roboryman/EchoCore/bom/EchoCore.csv

Ref | Qnty | Value | Name | Description | Footprint | Manufacturer | Manufacturer Part Number | JLCPCB Part Number | Comments | DNP
C101, C102, C104, C105, C106, C107, C113, C114, C306, C307, C311, C312, C401 | 13 | 100n | C | Unpolarized capacitor | Capacitor_SMD:C_0402_1005Metric | Samsung Electro-Mechanics | CL05B104KA5NNNC | C1525 | Prefer ceramic X7R
C103, C202, C207, C210 | 4 | 4.7u | C | Unpolarized capacitor | Capacitor_SMD:C_0603_1608Metric | Samsung Electro-Mechanics | CL10B475KQ8NQNC | C19666 | Prefer ceramic X7R
C108, C301, C302 | 3 | 10n | C | Unpolarized capacitor | Capacitor_SMD:C_0402_1005Metric | Murata Electronics | GRM1555C1E103GE01D | - | Ceramic C0G only
C109, C110, C203, C204, C206, C305, C308 | 7 | 1u | C | Unpolarized capacitor | Capacitor_SMD:C_0603_1608Metric | Samsung Electro-Mechanics | CL10B105KP8NNNC | C15849 | Prefer ceramic X7R
C111, C112 | 2 | 10p | C | Unpolarized capacitor | Capacitor_SMD:C_0805_2012Metric | Samsung Electro-Mechanics | CL21C100CBANNNC | - | Ceramic C0G or X7R
C201, C205 | 2 | 2.2u | C | Unpolarized capacitor | Capacitor_SMD:C_0603_1608Metric | Samsung Electro-Mechanics | CL10B225KP8NNNC | C23630 | Prefer ceramic X7R
C208 | 1 | 22u | C | Unpolarized capacitor | Capacitor_SMD:C_0805_2012Metric | Samsung Electro-Mechanics | CL21A226KQCLRNC | C45783 | Prefer ceramic X7R
C209 | 1 | DNP | C | Unpolarized capacitor | Capacitor_SMD:C_0805_2012Metric | - | - | - | DNP | DNP
C303, C304, C309 | 3 | 150p | C | Unpolarized capacitor | Capacitor_SMD:C_0805_2012Metric | YAGEO | CC0805FRNPO9BN151 | - | Ceramic C0G only
C310 | 1 | 220n | C | Unpolarized capacitor | Capacitor_SMD:C_0603_1608Metric | Murata Electronics | GRM188R71E224JA88J | - | Prefer ceramic X7R
D101 | 1 | EAST1616RGBB2 | LED_RGBA | RGB LED, red/green/blue/anode | _Galahad_Labs_Footprints:EAST1616RGBB2_RGBA | Everlight Electronics Co Ltd | EAST1616RGBB2 | - | RGB LED
D201 | 1 | 5988170107F (Green) | LED | Light emitting diode | _Galahad_Labs_Footprints:DIALIGHT_598-81xx | Dialight | 5988170107F | - | Power LED
FL401 | 1 | ACM-21-900M-T | Filter_EMI_CommonMode_12x43 | EMI 2-inductor common mode filter | _Galahad_Labs_Footprints:ABRACON_ACM-21-900M-T | Abracon LLC | ACM-21-900M-T | - | Buck inductor
J401 | 1 | FTSH-105-01-L-DV-K | Conn_02x05_Odd_Even | Generic connector, double row, 02x05, odd/even pin numbering scheme (row 1 odd numbers, row 2 even numbers), script generated (kicad-library-utils/schlib/autogen/connector/) | _Galahad_Labs_Footprints:SAMTEC_FTSH-105-01-L-DV-K | Samtec Inc. | FTSH-105-01-L-DV-K | - | SWD connector
J402 | 1 | USB4105-GF-A | USB_C_Receptacle_USB2.0 | USB 2.0-only Type-C Receptacle connector | Connector_USB:USB_C_Receptacle_GCT_USB4105-xx-A_16P_TopMnt_Horizontal | GCT | USB4105-GF-A | - | USB 2.0 connector (type c)
J403 | 1 | JST-PH_01x04 | Conn_01x04 | Generic connector, single row, 01x04, script generated (kicad-library-utils/schlib/autogen/connector/) | Connector_JST:JST_PH_S4B-PH-K_1x04_P2.00mm_Horizontal | JST Sales America Inc. | S4B-PH-K-S | - | Analog connector
L101, L201 | 2 | 10n | L | Inductor | Inductor_SMD:L_0402_1005Metric | Murata Electronics | LQG15WZ10NH02D | - | DCR > 0.15
L202 | 1 | 68u | L | Inductor | _Galahad_Labs_Footprints:TDK_VLS3015CX-H | TDK Corporation | VLS3015CX-680M-H | - | -
R101, R104, R107, R108 | 4 | 10k | R | Resistor | Resistor_SMD:R_0603_1608Metric | Vishay Dale | CRCW060310K0FKEAHP | C25804 | >1/4 W, low tolerance
R102, R103, R105, R106, R206 | 5 | 100 | R | Resistor | Resistor_SMD:R_0402_1005Metric | Vishay Dale | CRCW0402100RFKEDHP | C25076 | >1/4 W, low tolerance
R201 | 1 | 10 | R | Resistor | Resistor_SMD:R_0805_2012Metric | Rohm Semiconductor | ESR10EZPJ100 | C17415 | >2/5 W, low tolerance
R202 | 1 | 82k | R | Resistor | Resistor_SMD:R_0603_1608Metric | TE Connectivity Passive Product | CRGP0603F82K | C23254 | >1/4 W, low tolerance
R203 | 1 | 47k | R | Resistor | Resistor_SMD:R_0805_2012Metric | Vishay Dale | CRCW080547K0FKEAHP | C17713 | >1/4 W, low tolerance
R204 | 1 | 300k | R | Resistor | Resistor_SMD:R_0805_2012Metric | Vishay Dale | RCS0805300KFKEA | C17616 | >1/4 W, low tolerance
R205 | 1 | 510k | R | Resistor | Resistor_SMD:R_0805_2012Metric | Panasonic Electronic Components | ERJ-PB6B5103V | C17733 | >1/4 W, low tolerance
R207 | 1 | 180k | R | Resistor | Resistor_SMD:R_0805_2012Metric | Panasonic Electronic Components | ERJ-UP6F1803V | C17501 | >1/4 W, low tolerance
R209 | 1 | 22k | R | Resistor | Resistor_SMD:R_0603_1608Metric | Panasonic Electronic Components | ERJ-PA3F2202V | C31850 | >1/4 W, low tolerance
R210 | 1 | 18k | R | Resistor | Resistor_SMD:R_0603_1608Metric | Panasonic Electronic Components | ERJ-PA3F1802V | C25810 | >1/4 W, low tolerance
R301, R302, R303, R304, R306, R308 | 6 | 1k | R | Resistor | Resistor_SMD:R_0603_1608Metric | Susumu | RG1608P-102-B-T5 | C21190 | Very low tolerance
R305, R307, R310 | 3 | 100M | R | Resistor | Resistor_SMD:R_0805_2012Metric | YAGEO | RC0805JR-13100ML | - | -
R311 | 1 | 0R | R | Resistor | Resistor_SMD:R_0402_1005Metric | Bourns Inc. | CR0402-J/-000GLF | C17168 | -
R401, R402, R403 | 3 | 49R9 | R | Resistor | Resistor_SMD:R_0402_1005Metric | YAGEO | RC0402FR-0749R9L | C25120 | Low tolerance
R404, R405 | 2 | 5k1 | R | Resistor | Resistor_SMD:R_0603_1608Metric | YAGEO | RC0603FR-135K1L | C23186 | Low tolerance
SW102 | 1 | PTS645SM43SMTR92 LFS | SW_Push | Push button switch, generic, two pins | Button_Switch_SMD:SW_SPST_PTS645 | C&K | PTS645SM43SMTR92LFS | - | Temporary switch
U101 | 1 | BMI323 | BMI323 | Small, versatile 6DoF sensor module, LGA-14 | Package_LGA:Bosch_LGA-14_3x2.5mm_P0.5mm | Bosch Sensortec | BMI323 | - | IMU
U102 | 1 | STM32F070CBTx | STM32F070CBTx | STMicroelectronics Arm Cortex-M0 MCU, 128KB flash, 16KB RAM, 48 MHz, 2.4-3.6V, 37 GPIO, LQFP48 | Package_QFP:LQFP-48_7x7mm_P0.5mm | STMicroelectronics | STM32F070CBT6 | - | MCU
U201 | 1 | LM27762 | LM27762 | Low-noise inverting charge pump with both positive and negative LDO's, with 2.7V-5.5V input to +1.5 to +5V and -1.5 to -5V Output Voltage, WSON-12 | Package_SON:WSON-12-1EP_3x2mm_P0.5mm_EP1x2.65 | Texas Instruments | LM27762DSSR | - | Analog supply LDO
U202 | 1 | TLV62568DBVR | TLV62568DBV | High Efficiency Synchronous Buck Converter, Adjustable Output 0.6V-5.5V, 1A, SOT-23-5 | Package_TO_SOT_SMD:SOT-23-5 | Texas Instruments | TLV62568DBVR | - | Digital supply buck
U301 | 1 | OPA4376 | OPA4376 | Quad Low-Noise, Low Quiescent Current, Precision Operational Amplifier e-trim Series, SC-70-5 | Package_SO:TSSOP-14_4.4x5mm_P0.65mm | Texas Instruments | OPA4376AIPW | - | Analog buffer
U302 | 1 | ADS131M02 | ADS131M02 | 24-bit ΔΣ ADC, 2 Channels, SPI compatible, PGA 1 to 128, TSSOP-20 | Package_SO:TSSOP-20_4.4x6.5mm_P0.65mm | Texas Instruments | ADS131M02IPWT | - | ADC
U401, U403 | 2 | TPD4E1B06 | TPD4E1B06 | 4-Channel Ultra Low Leakage ESD Protection Device | Package_TO_SOT_SMD:SOT-363_SC-70-6 | Texas Instruments | TPD4E1B06DCKR | - | ESD
U402 | 1 | USBLC6-2SC6 | USBLC6-2SC6 | Very low capacitance ESD protection diode, 2 data-line, SOT-23-6 | Package_TO_SOT_SMD:SOT-23-6 | STMicroelectronics | USBLC6-2SC6 | - | USB CMC
Y101 | 1 | ECS-160-10-36-CKM | Crystal_GND24 | Four pin crystal, GND on pins 2 and 4 | _Galahad_Labs_Footprints:Crystal_SMD_ECS_ECX-2236-4Pin_2.5x2.0mm | ECS Inc. | ECS-160-10-36-CKM-TR3 | - | 16 MHz Crystal
