roboryman/EchoCore/pinout.csv

Position | Name | Type | Signal | Label
1 | VDD | Power
2 | PC13 | I/O
3 | PC14-OSC32_IN | I/O
4 | PC15-OSC32_OUT | I/O
5 | PF0-OSC_IN | I/O | RCC_OSC_IN
6 | PF1-OSC_OUT | I/O | RCC_OSC_OUT
7 | NRST | Reset
8 | VSSA | Power
9 | VDDA | Power
10 | PA0 | I/O
11 | PA1 | I/O
12 | PA2 | I/O
13 | PA3 | I/O
14 | PA4 | I/O | SPI1_NSS
15 | PA5 | I/O | SPI1_SCK
16 | PA6 | I/O | SPI1_MISO
17 | PA7 | I/O | SPI1_MOSI
18 | PB0 | I/O
19 | PB1 | Input | GPIO_Input | ADC_INT
20 | PB2 | I/O
21 | PB10 | I/O
22 | PB11 | I/O
23 | VSS | Power
24 | VDD | Power
25 | PB12 | Input | GPIO_Input | IMU_INT1
26 | PB13 | I/O | SPI2_SCK
27 | PB14 | I/O | SPI2_MISO
28 | PB15 | I/O | SPI2_MOSI
29 | PA8 | I/O | RCC_MCO
30 | PA9 | Input | GPIO_Input | IMU_INT2
31 | PA10 | I/O
32 | PA11 | I/O | USB_DM
33 | PA12 | I/O | USB_DP
34 | PA13 | I/O | SYS_SWDIO
35 | VSS | Power
36 | VDD | Power
37 | PA14 | I/O | SYS_SWCLK
38 | PA15 | I/O
39 | PB3 | I/O
40 | PB4 | I/O | TIM3_CH1
41 | PB5 | I/O | TIM3_CH2
42 | PB6 | I/O
43 | PB7 | I/O
44 | BOOT0 | Boot
45 | PB8 | I/O | TIM16_CH1
46 | PB9 | I/O | SPI2_NSS
47 | VSS | Power
48 | VDD | Power
