roboryman/EchoCore/EchoCore.kicad_pcb

## KiCad design EchoCore.kicad_pcb (2026-11-10)

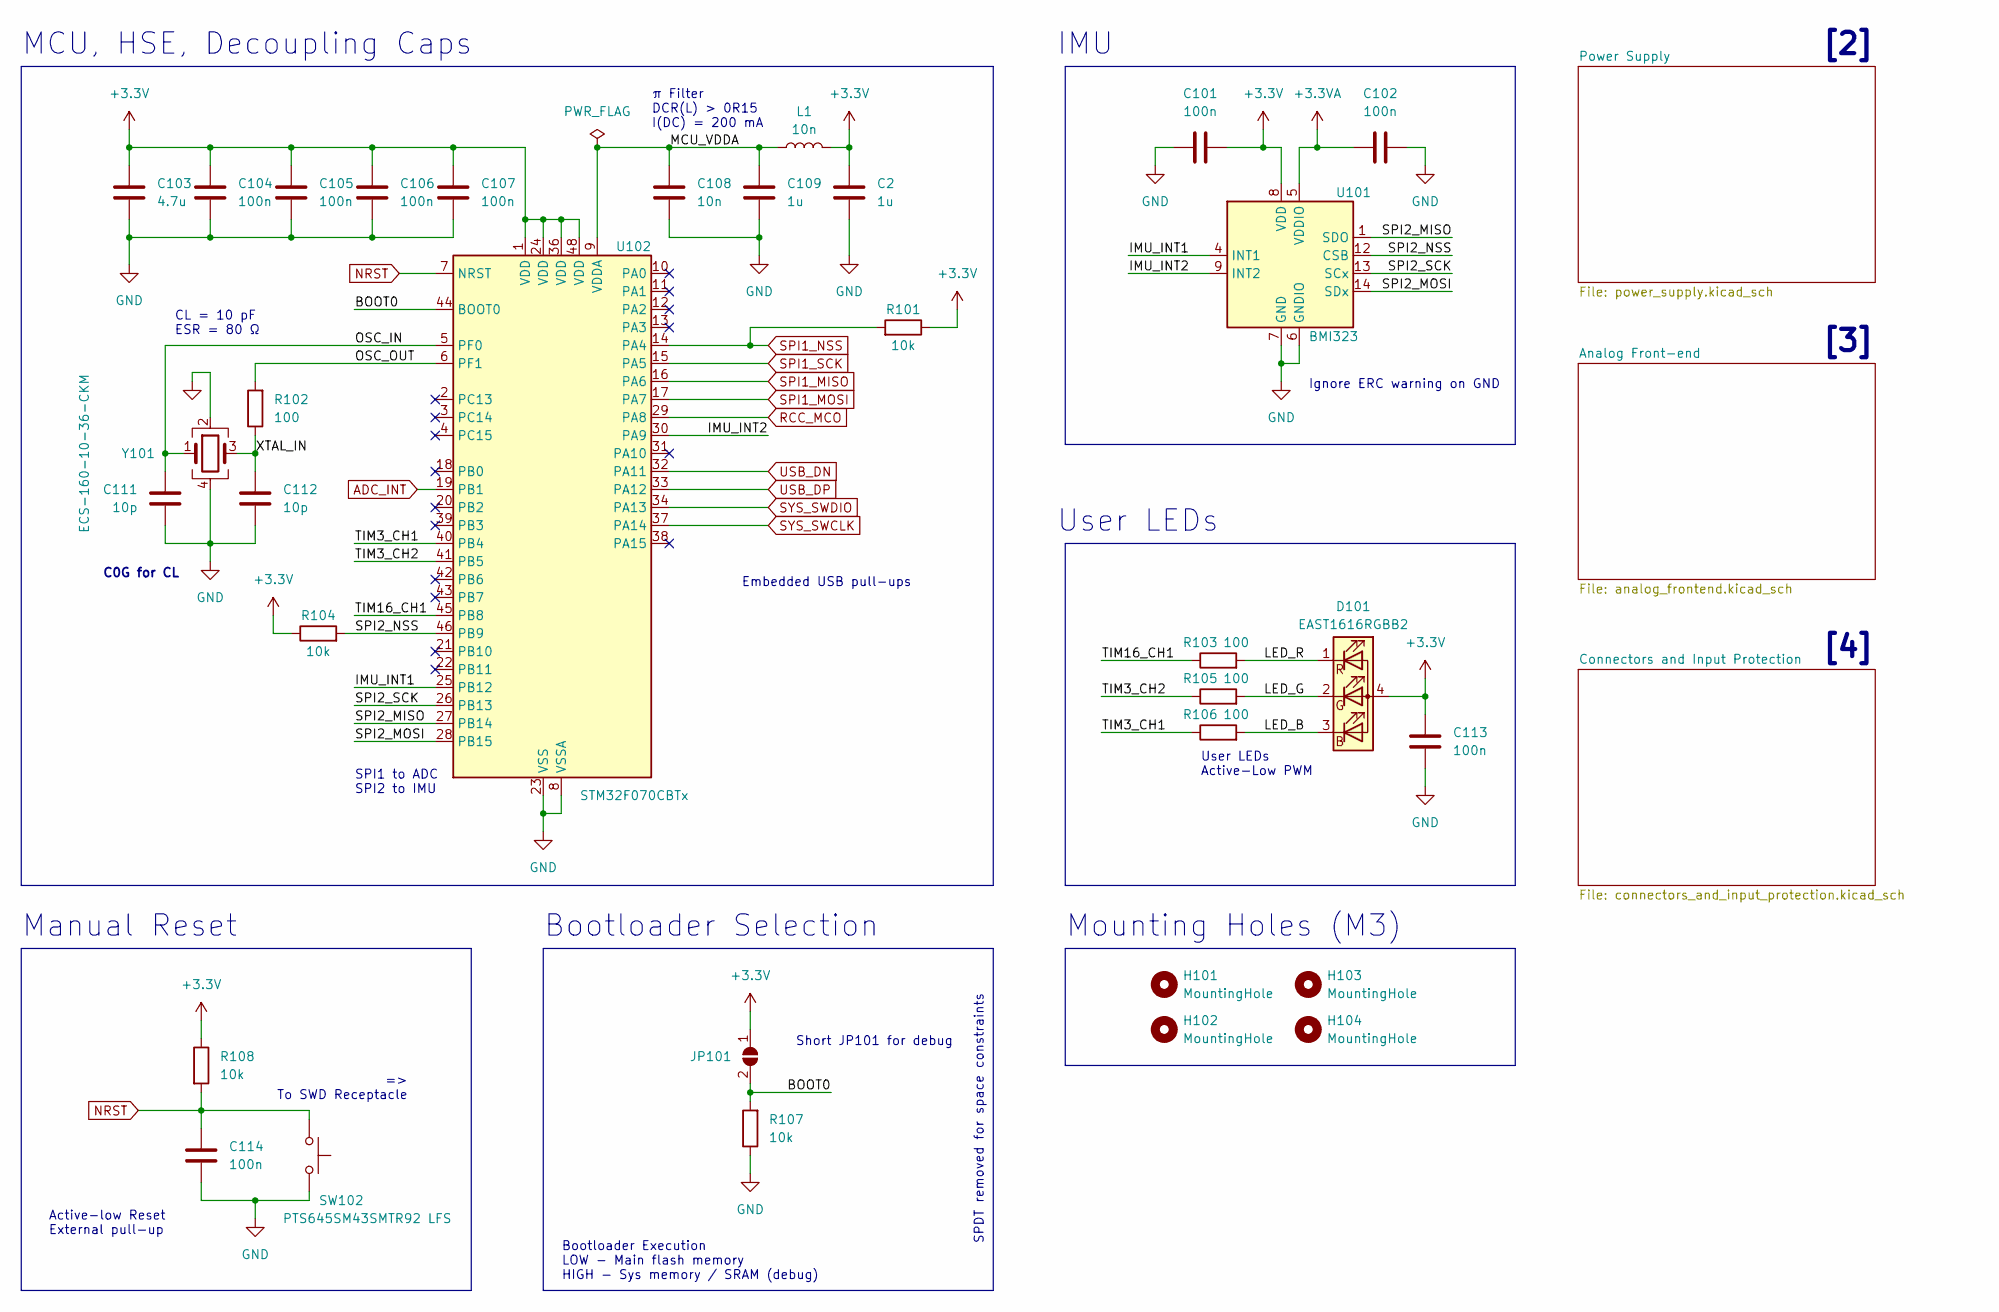
[picture p1: schematic EchoCore.kicad_sch]

Parts:
C2, C109: 1u; C_0603_1608Metric; Manufacturer Part Number CL10B105KP8NNNC; JLCPCB Part Number C15849
C101, C102, C104, C105, C106, C107, C113, C114: 100n; C_0402_1005Metric; Manufacturer Part Number CL05B104KA5NNNC; JLCPCB Part Number C1525
C103: 4.7u; C_0603_1608Metric; Manufacturer Part Number CL10B475KQ8NQNC; JLCPCB Part Number C19666
C108: 10n; C_0402_1005Metric; Manufacturer Part Number GRM1555C1E103GE01D
C111, C112: 10p; C_0805_2012Metric; Manufacturer Part Number CL21C100CBANNNC
D101: EAST1616RGBB2; EAST1616RGBB2_RGBA; Manufacturer Part Number EAST1616RGBB2
H101, H102, H103, H104: MountingHole; MountingHole_3.2mm_M3
JP101: SolderJumper_2_Open; SolderJumper-2_P1.3mm_Open_RoundedPad1.0x1.5mm
L1: 10n; L_0402_1005Metric; Manufacturer Part Number LQG15WZ10NH02D
R101, R104, R107, R108: 10k; R_0603_1608Metric; Manufacturer Part Number CRCW060310K0FKEAHP; JLCPCB Part Number C25804
R102, R103, R105, R106: 100; R_0402_1005Metric; Manufacturer Part Number CRCW0402100RFKEDHP; JLCPCB Part Number C25076
SW102: PTS645SM43SMTR92 LFS; SW_SPST_PTS645; Manufacturer Part Number PTS645SM43SMTR92LFS
U101: BMI323; Bosch_LGA-14_3x2.5mm_P0.5mm; Manufacturer Part Number BMI323
U102: STM32F070CBTx; LQFP-48_7x7mm_P0.5mm; Manufacturer Part Number STM32F070CBT6
Y101: ECS-160-10-36-CKM; Crystal_SMD_ECS_ECX-2236-4Pin_2.5x2.0mm; Manufacturer Part Number ECS-160-10-36-CKM-TR3

Connections:
+3.3V: C101.2, C103.1, C104.1, C105.1, C106.1, C107.1, C113.1, D101.4 (A), JP101.1 (A), R101.1, R104.1, R108.1, U101.8 (VDD), U102.1 (VDD), U102.24 (VDD), U102.36 (VDD), U102.48 (VDD); also elsewhere on the board
+3.3VA: C102.1, U101.5 (VDDIO); also elsewhere on the board
/BOOT0: JP101.2 (B), R107.2, U102.44 (BOOT0)
/IMU_INT1: U101.4 (INT1), U102.25 (PB12)
/IMU_INT2: U101.9 (INT2), U102.30 (PA9)
/LED_B: D101.3 (BK), R106.2
/LED_G: D101.2 (GK), R105.2
/LED_R: D101.1 (RK), R103.2
/MCU_VDDA: C108.1, C109.1, U102.9 (VDDA); also elsewhere on the board
/OSC_IN: C111.1, U102.5 (PF0), Y101.1
/OSC_OUT: R102.2, U102.6 (PF1)
/SPI2_MISO: U101.1 (SDO), U102.27 (PB14)
/SPI2_MOSI: U101.14 (SDx), U102.28 (PB15)
/SPI2_NSS: R104.2, U101.12 (CSB), U102.46 (PB9)
/SPI2_SCK: U101.13 (SCx), U102.26 (PB13)
/TIM3_CH1: R106.1, U102.40 (PB4)
/TIM3_CH2: R105.1, U102.41 (PB5)
/TIM16_CH1: R103.1, U102.45 (PB8)
/XTAL_IN: C112.1, R102.1, Y101.3
ADC_INT: U102.19 (PB1); also elsewhere on the board
GND: C101.1, C102.2, C103.2, C104.2, C105.2, C106.2, C107.2, C108.2, C109.2, C111.2, C112.2, C113.2, C114.2, R107.1, SW102.2, U101.6 (GNDIO), U101.7 (GND), U102.8 (VSSA), U102.23 (VSS), U102.35 (VSS), U102.47 (VSS), Y101.2, Y101.4; also elsewhere on the board
NRST: C114.1, R108.2, SW102.1, U102.7 (NRST); also elsewhere on the board
RCC_MCO: U102.29 (PA8); also elsewhere on the board
SPI1_MISO: U102.16 (PA6); also elsewhere on the board
SPI1_MOSI: U102.17 (PA7); also elsewhere on the board
SPI1_NSS: R101.2, U102.14 (PA4); also elsewhere on the board
SPI1_SCK: U102.15 (PA5); also elsewhere on the board
SYS_SWCLK: U102.37 (PA14); also elsewhere on the board
SYS_SWDIO: U102.34 (PA13); also elsewhere on the board
USB_DN: U102.32 (PA11); also elsewhere on the board
USB_DP: U102.33 (PA12); also elsewhere on the board

Notes on the sheet:
Bootloader Selection
CL = 10 pF ESR = 80 Ω
IMU
Bootloader Execution LOW - Main flash memory HIGH - Sys memory / SRAM (debug)
SPDT removed for space constraints
Manual Reset
π Filter DCR(L) > 0R15 I(DC) = 200 mA
User LEDs Active-Low PWM
Ignore ERC warning on GND
[4]
SPI1 to ADC SPI2 to IMU
[3]
[2]
Mounting Holes (M3)
User LEDs
Embedded USB pull-ups
Short JP101 for debug
C0G for CL
Active-low Reset External pull-up
MCU, HSE, Decoupling Caps
=> To SWD Receptacle

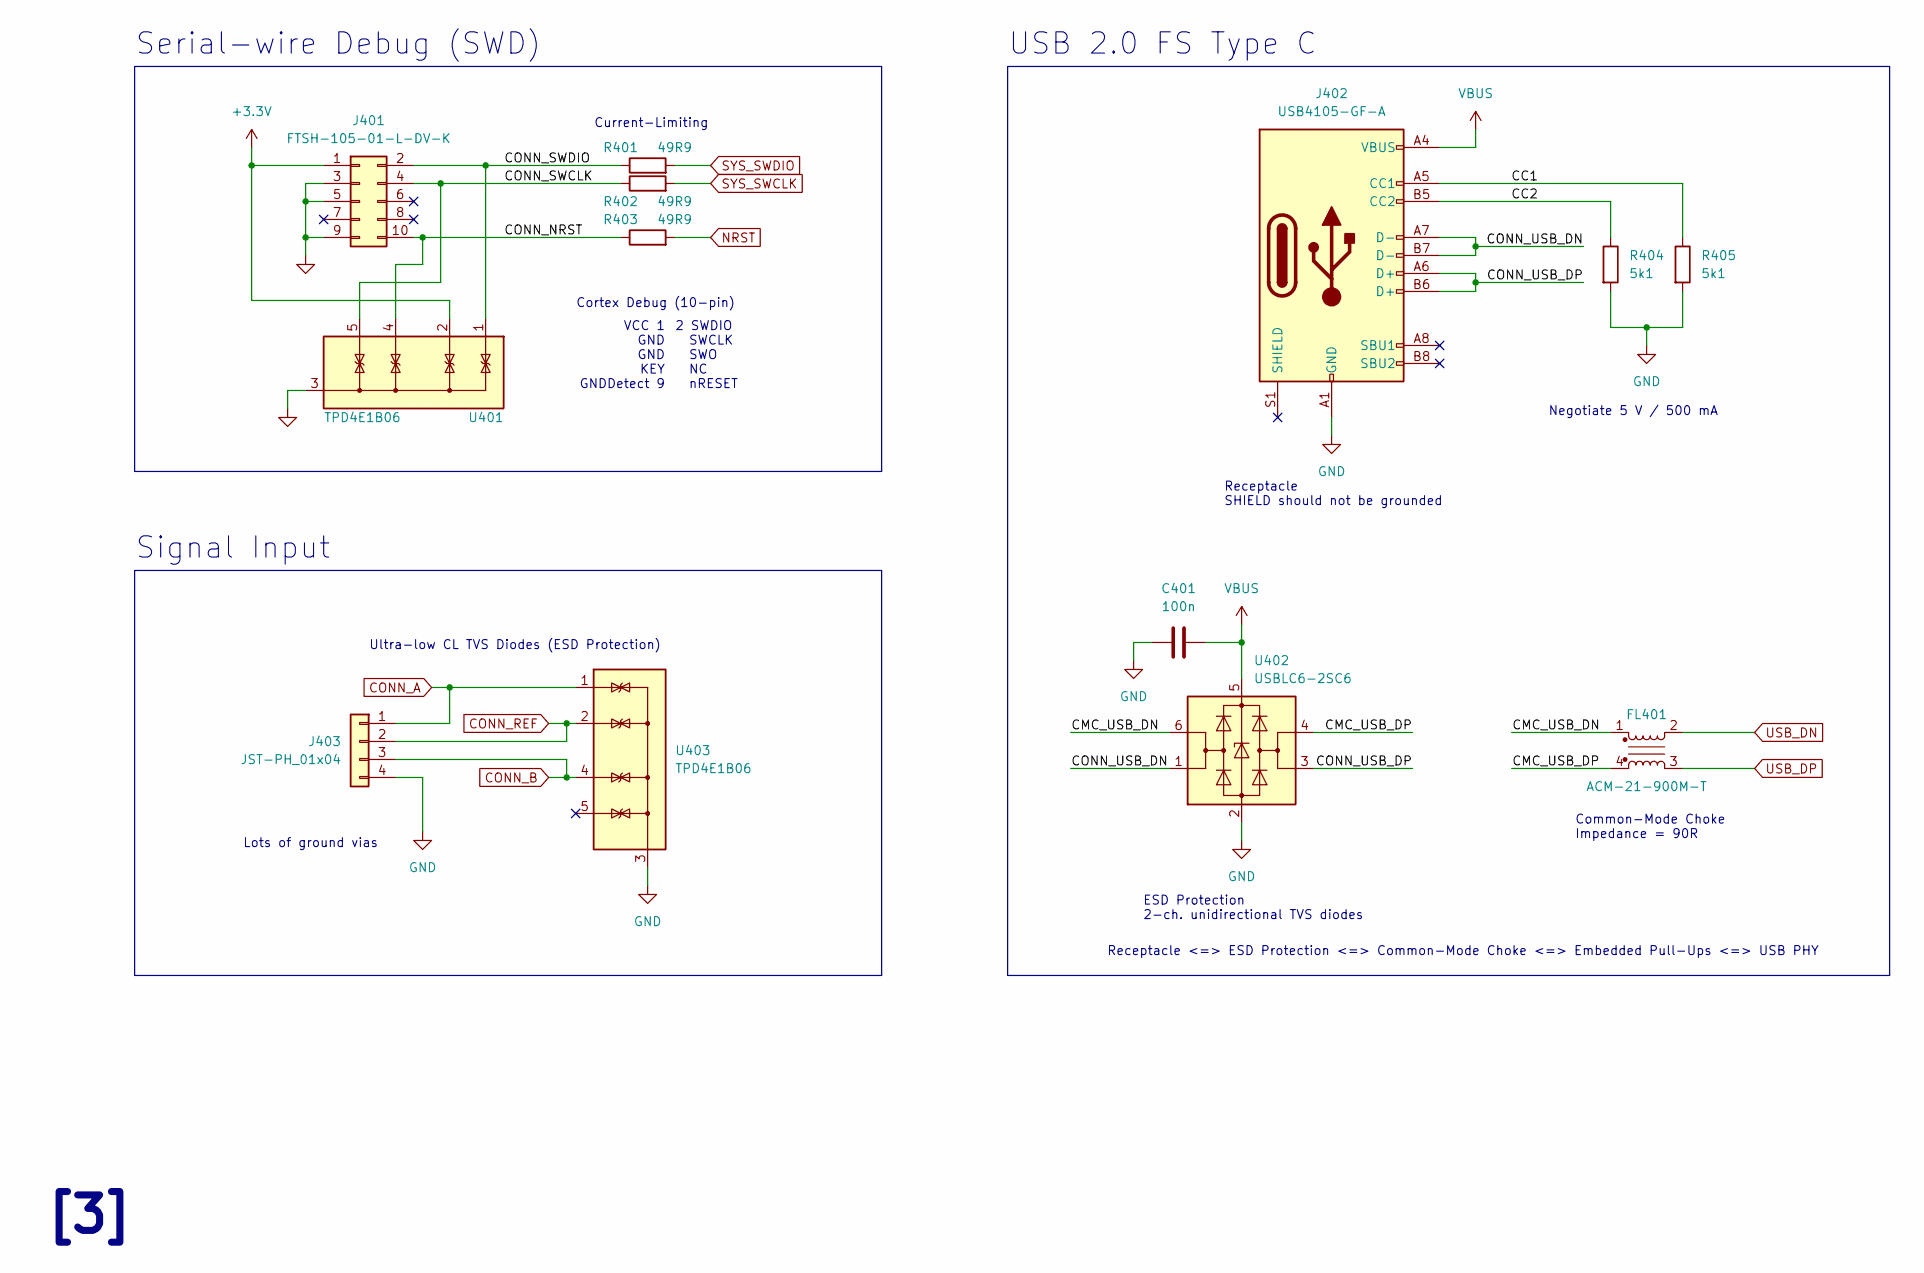
[picture p2: schematic connectors_and_input_protection.kicad_sch, EchoCore Connectors and Input Protection]

Parts:
C401: 100n; C_0402_1005Metric; Manufacturer Part Number CL05B104KA5NNNC; JLCPCB Part Number C1525
FL401: ACM-21-900M-T; ABRACON_ACM-21-900M-T; Manufacturer Part Number ACM-21-900M-T
J401: FTSH-105-01-L-DV-K; SAMTEC_FTSH-105-01-L-DV-K; Manufacturer Part Number FTSH-105-01-L-DV-K
J402: USB4105-GF-A; USB_C_Receptacle_GCT_USB4105-xx-A_16P_TopMnt_Horizontal; Manufacturer Part Number USB4105-GF-A
J403: JST-PH_01x04; JST_PH_S4B-PH-K_1x04_P2.00mm_Horizontal; Manufacturer Part Number S4B-PH-K-S
R401, R402, R403: 49R9; R_0402_1005Metric; Manufacturer Part Number RC0402FR-0749R9L; JLCPCB Part Number C25120
R404, R405: 5k1; R_0603_1608Metric; Manufacturer Part Number RC0603FR-135K1L; JLCPCB Part Number C23186
U401, U403: TPD4E1B06; SOT-363_SC-70-6; Manufacturer Part Number TPD4E1B06DCKR
U402: USBLC6-2SC6; SOT-23-6; Manufacturer Part Number USBLC6-2SC6

Connections:
+3.3V: J401.1, U401.2 (IO2); also elsewhere on the board
/Connectors and Input Protection/CC1: J402.A5 (CC1), R405.1
/Connectors and Input Protection/CC2: J402.B5 (CC2), R404.1
/Connectors and Input Protection/CMC_USB_DN: FL401.1, U402.6 (I/O1)
/Connectors and Input Protection/CMC_USB_DP: FL401.4, U402.4 (I/O2)
/Connectors and Input Protection/CONN_NRST: J401.10, R403.1, U401.4 (IO3)
/Connectors and Input Protection/CONN_SWCLK: J401.4, R402.1, U401.5 (IO4)
/Connectors and Input Protection/CONN_SWDIO: J401.2, R401.1, U401.1 (IO1)
/Connectors and Input Protection/CONN_USB_DN: J402.A7 (D-), J402.B7 (D-), U402.1 (I/O1)
/Connectors and Input Protection/CONN_USB_DP: J402.A6 (D+), J402.B6 (D+), U402.3 (I/O2)
CONN_A: J403.1, U403.1 (IO1); also elsewhere on the board
CONN_B: J403.3, U403.4 (IO3); also elsewhere on the board
CONN_REF: J403.2, U403.2 (IO2); also elsewhere on the board
GND: C401.1, J401.3, J401.5, J401.9, J402.A1 (GND), J402.A12 (GND), J402.B1 (GND), J402.B12 (GND), J403.4, R404.2, R405.2, U401.3 (GND), U402.2 (GND), U403.3 (GND); also elsewhere on the board
NRST: R403.2; also elsewhere on the board
SYS_SWCLK: R402.2; also elsewhere on the board
SYS_SWDIO: R401.2; also elsewhere on the board
USB_DN: FL401.2; also elsewhere on the board
USB_DP: FL401.3; also elsewhere on the board
VBUS: C401.2, J402.A4 (VBUS), J402.A9 (VBUS), J402.B4 (VBUS), J402.B9 (VBUS), U402.5 (VBUS); also elsewhere on the board

Notes on the sheet:
USB 2.0 FS Type C
Receptacle SHIELD should not be grounded
2 SWDIO SWCLK SWO NC nRESET
Signal Input
Ultra-low CL TVS Diodes (ESD Protection)
Serial-wire Debug (SWD)
Common-Mode Choke Impedance = 90R
Negotiate 5 V / 500 mA
Cortex Debug (10-pin)
Lots of ground vias
[3]
Current-Limiting
Receptacle <=> ESD Protection <=> Common-Mode Choke <=> Embedded Pull-Ups <=> USB PHY
ESD Protection 2-ch. unidirectional TVS diodes
VCC 1 GND GND KEY GNDDetect 9

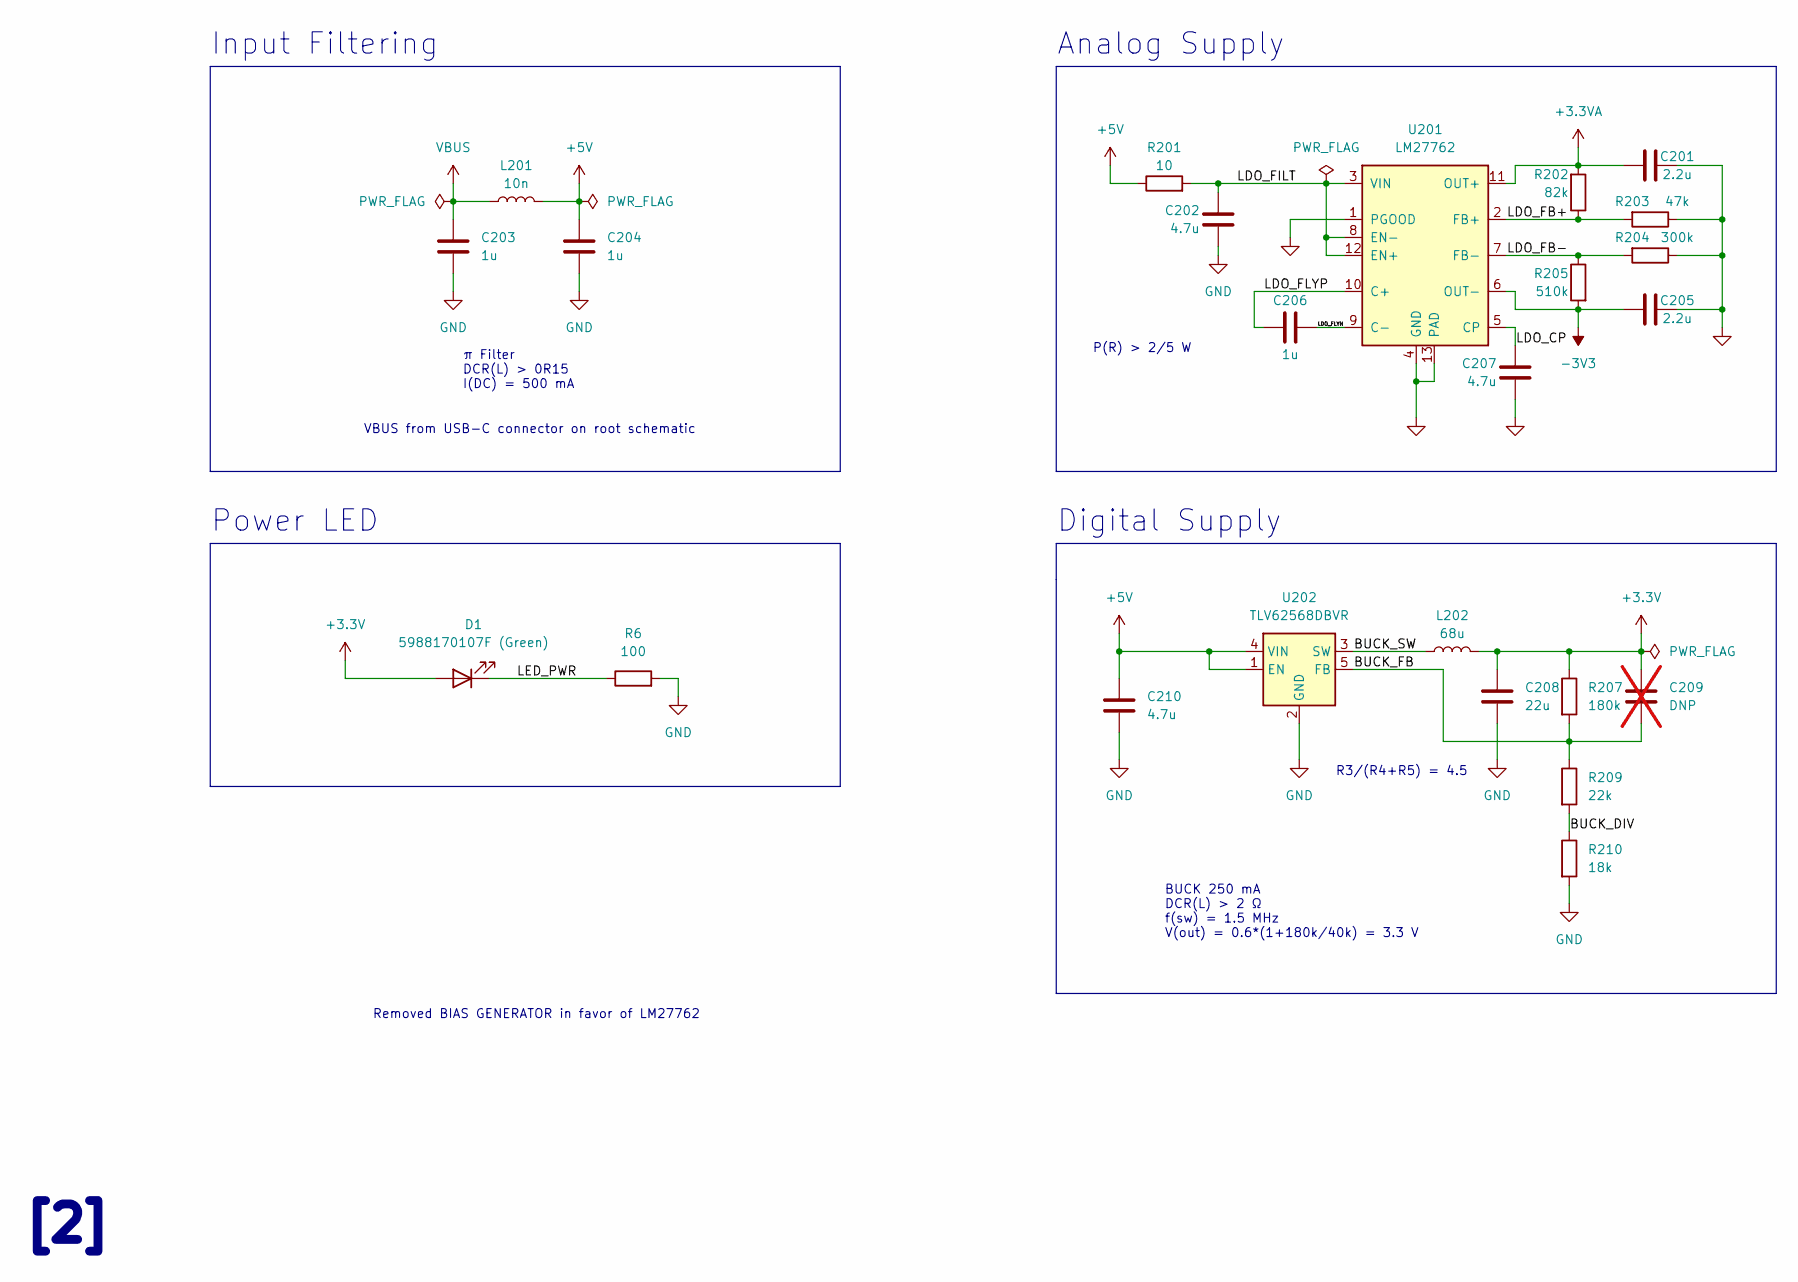
[picture p3: schematic power_supply.kicad_sch, EchoCore Power Supply]

Parts:
C201, C205: 2.2u; C_0603_1608Metric; Manufacturer Part Number CL10B225KP8NNNC; JLCPCB Part Number C23630
C202, C207, C210: 4.7u; C_0603_1608Metric; Manufacturer Part Number CL10B475KQ8NQNC; JLCPCB Part Number C19666
C203, C204, C206: 1u; C_0603_1608Metric; Manufacturer Part Number CL10B105KP8NNNC; JLCPCB Part Number C15849
C208: 22u; C_0805_2012Metric; Manufacturer Part Number CL21A226KQCLRNC; JLCPCB Part Number C45783
C209: DNP; C_0805_2012Metric; not fitted
D1: 5988170107F (Green); DIALIGHT_598-81xx; Manufacturer Part Number 5988170107F
L201: 10n; L_0402_1005Metric; Manufacturer Part Number LQG15WZ10NH02D
L202: 68u; TDK_VLS3015CX-H; Manufacturer Part Number VLS3015CX-680M-H
R6: 100; R_0402_1005Metric; Manufacturer Part Number CRCW0402100RFKEDHP; JLCPCB Part Number C25076
R201: 10; R_0805_2012Metric; Manufacturer Part Number ESR10EZPJ100; JLCPCB Part Number C17415
R202: 82k; R_0603_1608Metric; Manufacturer Part Number CRGP0603F82K; JLCPCB Part Number C23254
R203: 47k; R_0805_2012Metric; Manufacturer Part Number CRCW080547K0FKEAHP; JLCPCB Part Number C17713
R204: 300k; R_0805_2012Metric; Manufacturer Part Number RCS0805300KFKEA; JLCPCB Part Number C17616
R205: 510k; R_0805_2012Metric; Manufacturer Part Number ERJ-PB6B5103V; JLCPCB Part Number C17733
R207: 180k; R_0805_2012Metric; Manufacturer Part Number ERJ-UP6F1803V; JLCPCB Part Number C17501
R209: 22k; R_0603_1608Metric; Manufacturer Part Number ERJ-PA3F2202V; JLCPCB Part Number C31850
R210: 18k; R_0603_1608Metric; Manufacturer Part Number ERJ-PA3F1802V; JLCPCB Part Number C25810
U201: LM27762; WSON-12-1EP_3x2mm_P0.5mm_EP1x2.65; Manufacturer Part Number LM27762DSSR
U202: TLV62568DBVR; SOT-23-5; Manufacturer Part Number TLV62568DBVR

Connections:
+3.3V: C208.2, C209.2, L202.2, R207.1; also elsewhere on the board
+3.3VA: C201.1, R202.2, U201.11 (OUT+); also elsewhere on the board
+5V: C204.1, C210.1, L201.2, R201.1, U202.1 (EN), U202.4 (VIN)
-3V3: C205.1, R205.2, U201.6 (OUT-); also elsewhere on the board
/Power Supply/BUCK_DIV: R209.2, R210.1
/Power Supply/BUCK_FB: C209.1, R207.2, R209.1, U202.5 (FB)
/Power Supply/BUCK_SW: L202.1, U202.3 (SW)
/Power Supply/LDO_CP: C207.1, U201.5 (CP)
/Power Supply/LDO_FB+: R202.1, R203.2, U201.2 (FB+)
/Power Supply/LDO_FB-: R204.2, R205.1, U201.7 (FB-)
/Power Supply/LDO_FILT: C202.1, R201.2, U201.3 (VIN), U201.8 (EN-), U201.12 (EN+)
/Power Supply/LDO_FLYN: C206.2, U201.9 (C-)
/Power Supply/LDO_FLYP: C206.1, U201.10 (C+)
GND: C201.2, C202.2, C203.2, C204.2, C205.2, C207.2, C208.1, C210.2, R203.1, R204.1, R210.2, U201.1 (PGOOD), U201.4 (GND), U201.13 (PAD), U202.2 (GND); also elsewhere on the board
VBUS: C203.1, L201.1; also elsewhere on the board

Notes on the sheet:
π Filter DCR(L) > 0R15 I(DC) = 500 mA
Digital Supply
P(R) > 2/5 W
VBUS from USB-C connector on root schematic
Analog Supply
Input Filtering
R3/(R4+R5) = 4.5
Power LED
Removed BIAS GENERATOR in favor of LM27762
BUCK 250 mA DCR(L) > 2 Ω f(sw) = 1.5 MHz V(out) = 0.6*(1+180k/40k) = 3.3 V
[2]

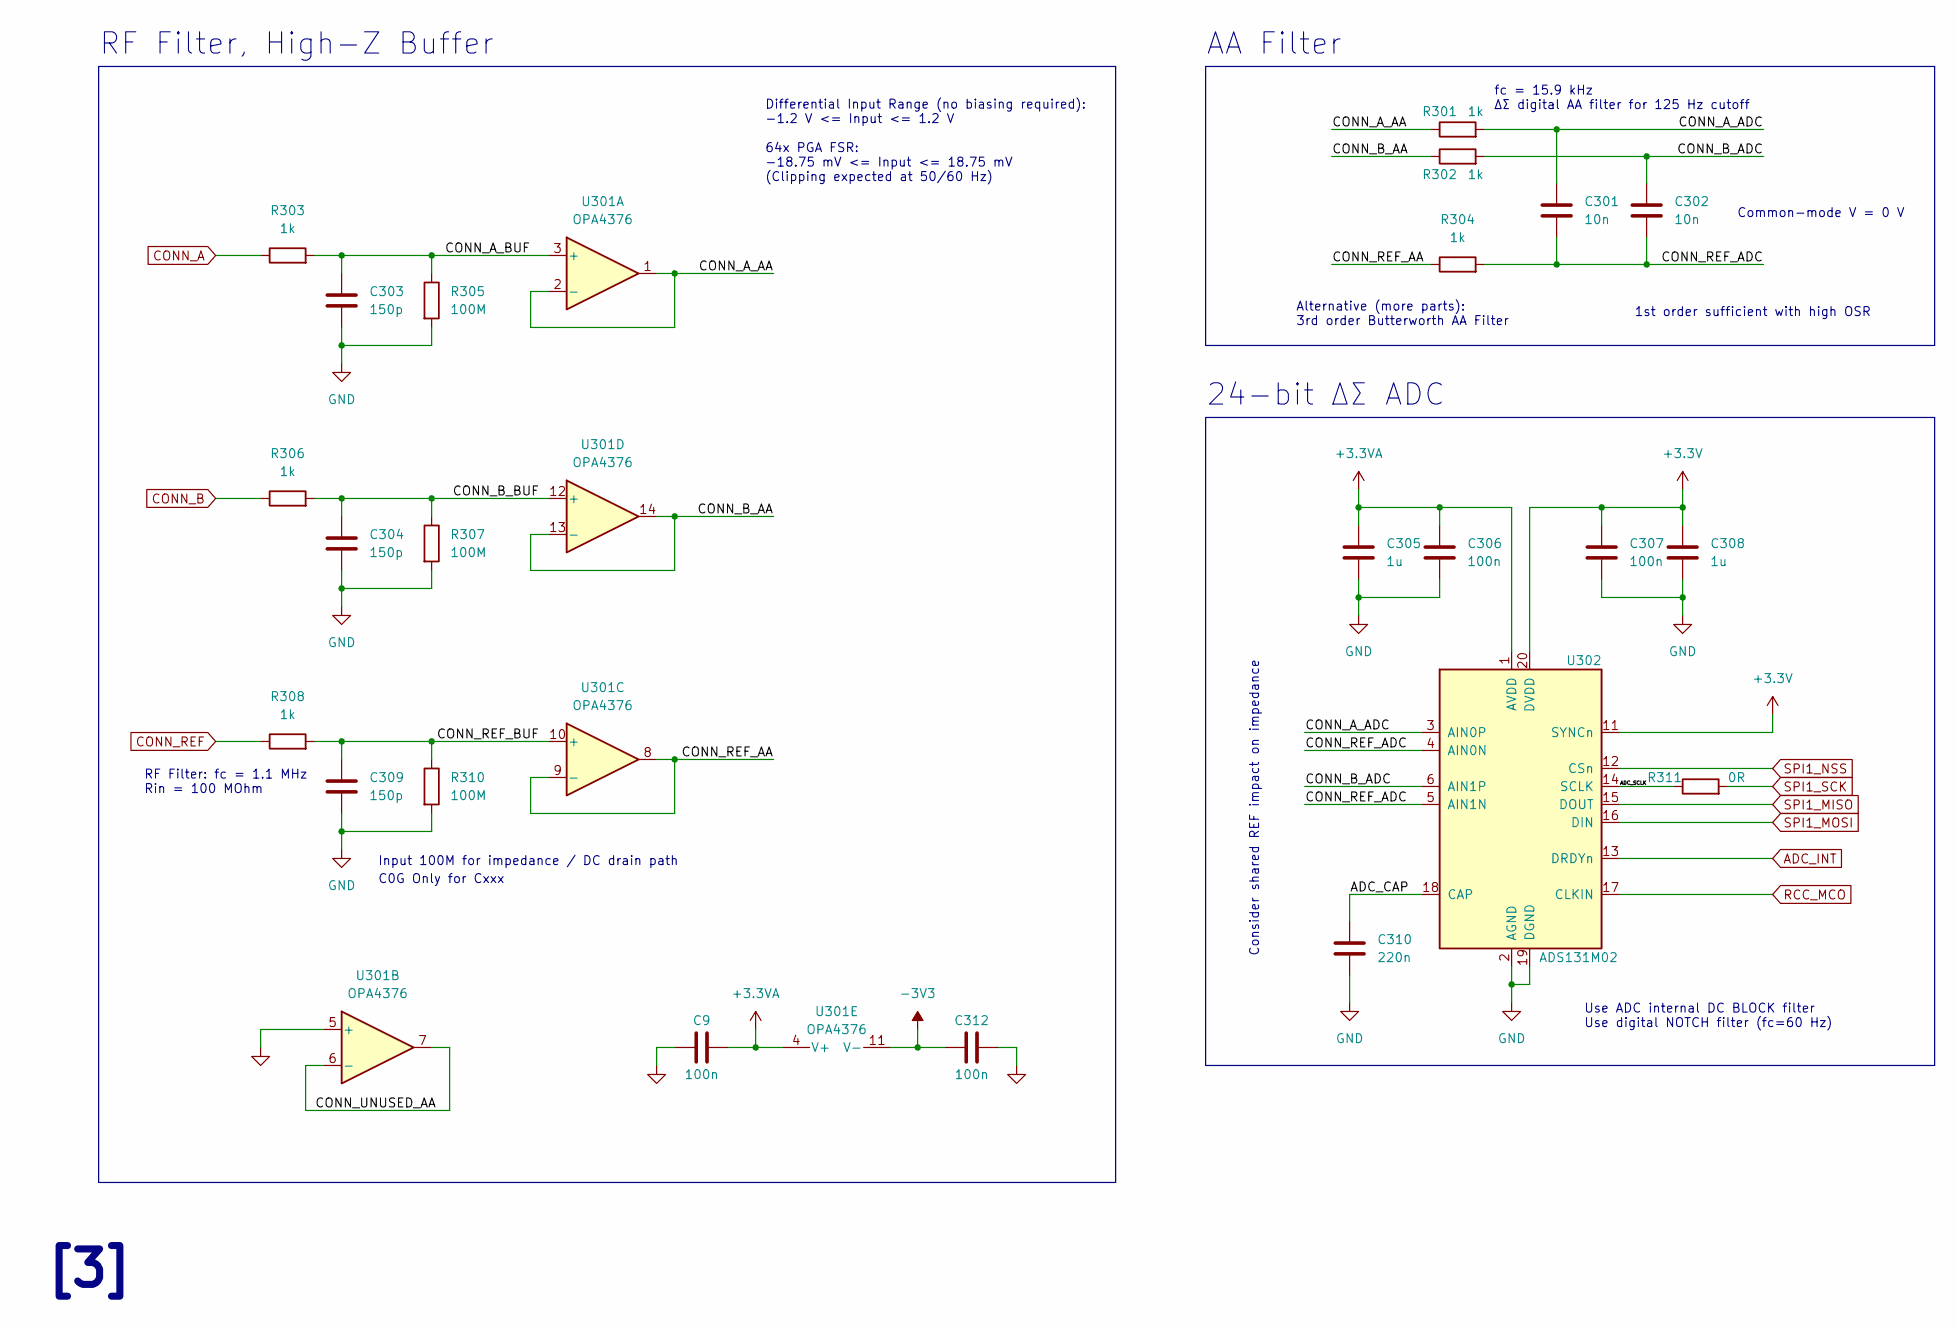
[picture p4: schematic analog_frontend.kicad_sch, EchoCore Analog Front-End]

Parts:
C9, C306, C307, C312: 100n; C_0402_1005Metric; Manufacturer Part Number CL05B104KA5NNNC; JLCPCB Part Number C1525
C301, C302: 10n; C_0402_1005Metric; Manufacturer Part Number GRM1555C1E103GE01D
C303, C304, C309: 150p; C_0805_2012Metric; Manufacturer Part Number CC0805FRNPO9BN151
C305, C308: 1u; C_0603_1608Metric; Manufacturer Part Number CL10B105KP8NNNC; JLCPCB Part Number C15849
C310: 220n; C_0603_1608Metric; Manufacturer Part Number GRM188R71E224JA88J
R301, R302, R303, R304, R306, R308: 1k; R_0603_1608Metric; Manufacturer Part Number RG1608P-102-B-T5; JLCPCB Part Number C21190
R305, R307, R310: 100M; R_0805_2012Metric; Manufacturer Part Number RC0805JR-13100ML
R311: 0R; R_0402_1005Metric; Manufacturer Part Number CR0402-J/-000GLF; JLCPCB Part Number C17168
U301: OPA4376; TSSOP-14_4.4x5mm_P0.65mm; Manufacturer Part Number OPA4376AIPW
U302: ADS131M02; TSSOP-20_4.4x6.5mm_P0.65mm; Manufacturer Part Number ADS131M02IPWT

Connections:
+3.3V: C307.2, C308.1, U302.11 (SYNCn), U302.20 (DVDD); also elsewhere on the board
+3.3VA: C305.1, C306.2, U301.4 (V+), U302.1 (AVDD); also elsewhere on the board
-3V3: C312.1, U301.11 (V-); also elsewhere on the board
/Analog Front-end/ADC_CAP: C310.1, U302.18 (CAP)
/Analog Front-end/ADC_SCLK: R311.1, U302.14 (SCLK)
/Analog Front-end/CONN_A_AA: R301.1, U301.1, U301.2 (-)
/Analog Front-end/CONN_A_ADC: C301.1, R301.2, U302.3 (AIN0P)
/Analog Front-end/CONN_A_BUF: C303.1, R303.2, R305.1, U301.3 (+)
/Analog Front-end/CONN_B_AA: R302.1, U301.13 (-), U301.14
/Analog Front-end/CONN_B_ADC: C302.1, R302.2, U302.6 (AIN1P)
/Analog Front-end/CONN_B_BUF: C304.1, R306.2, R307.1, U301.12 (+)
/Analog Front-end/CONN_REF_AA: R304.1, U301.8, U301.9 (-)
/Analog Front-end/CONN_REF_ADC: C301.2, C302.2, R304.2, U302.4 (AIN0N), U302.5 (AIN1N)
/Analog Front-end/CONN_REF_BUF: C309.1, R308.2, R310.1, U301.10 (+)
/Analog Front-end/CONN_UNUSED_AA: U301.6 (-), U301.7
ADC_INT: U302.13 (DRDYn); also elsewhere on the board
CONN_A: R303.1; also elsewhere on the board
CONN_B: R306.1; also elsewhere on the board
CONN_REF: R308.1; also elsewhere on the board
GND: C303.2, C304.2, C305.2, C306.1, C307.1, C308.2, C309.2, C310.2, C312.2, R305.2, R307.2, R310.2, U301.5 (+), U302.2 (AGND), U302.19 (DGND); also elsewhere on the board
RCC_MCO: U302.17 (CLKIN); also elsewhere on the board
SPI1_MISO: U302.15 (DOUT); also elsewhere on the board
SPI1_MOSI: U302.16 (DIN); also elsewhere on the board
SPI1_NSS: U302.12 (CSn); also elsewhere on the board
SPI1_SCK: R311.2; also elsewhere on the board

Notes on the sheet:
1st order sufficient with high OSR
24-bit ΔΣ ADC
Differential Input Range (no biasing required): -1.2 V <= Input <= 1.2 V 64x PGA FSR: -18.75 mV <= Input <= 18.75 mV (Clipping expected at 50/60 Hz)
C0G Only for Cxxx
Use ADC internal DC BLOCK filter Use digital NOTCH filter (fc=60 Hz)
Input 100M for impedance / DC drain path
[3]
Alternative (more parts): 3rd order Butterworth AA Filter
AA Filter
Common-mode V = 0 V
Consider shared REF impact on impedance
RF Filter, High-Z Buffer
fc = 15.9 kHz ΔΣ digital AA filter for 125 Hz cutoff
RF Filter: fc = 1.1 MHz Rin = 100 MOhm

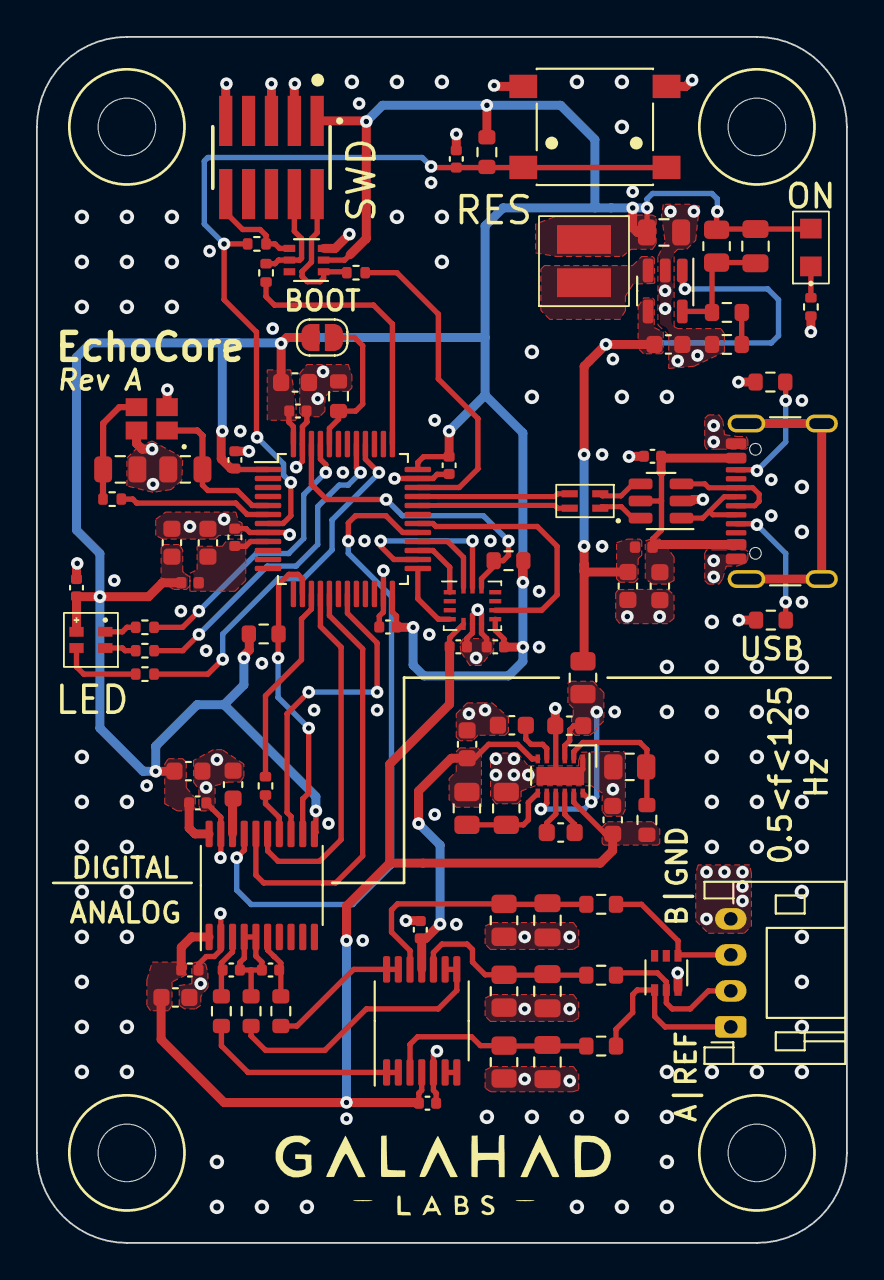
[picture p5: board EchoCore.kicad_pcb from above]

Board: 4 copper layers, 45.0 x 67.0 mm, 94 parts (0 on the bottom side), 68 nets.

Other parts of the board:
C110: 1u; C_0603_1608Metric
C311: 100n; C_0402_1005Metric
D201: 5988170107F (Green); DIALIGHT_598-81xx
L101: 10n; L_0402_1005Metric
R206: 100; R_0402_1005Metric

Their connections:
+3.3V: C110.1, D201.2 (A), L101.2; also elsewhere on the board
+3.3VA: C311.1; also elsewhere on the board
/MCU_VDDA: L101.1; also elsewhere on the board
/Power Supply/LED_PWR: D201.1 (K), R206.1
GND: C110.2, C311.2, R206.2; also elsewhere on the board
