roboryman/EchoCore/PinOutPlanning_RETS/Core/Src/main.c

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
/* Includes ------------------------------------------------------------------*/
#include <stdio.h>
#include <stdarg.h>
#include "main.h"
#include "usb_device.h"

/* USER CODE BEGIN Includes */
#include "user_define.h"
#include "usbd_cdc_if.h"
#include "bmi323.h"
#include "ads131m02.h"
/* USER CODE END Includes */

SPI_HandleTypeDef hspi1;
SPI_HandleTypeDef hspi2;

TIM_HandleTypeDef htim3;
TIM_HandleTypeDef htim16;

void SystemClock_Config(void);
static void MX_GPIO_Init(void);
static void MX_SPI1_Init(void);
static void MX_SPI2_Init(void);
static void MX_TIM3_Init(void);
static void MX_TIM16_Init(void);
/* USER CODE BEGIN PFP */
static void CDC_TX_Buffer_Init(void);
/* USER CODE END PFP */

/**
  * @brief  The application entry point.
  * @retval int
  */
int main(void)
{
	/* MCU Configuration--------------------------------------------------------*/

	/* Reset of all peripherals, Initializes the Flash interface and the Systick. */
	HAL_Init();

	/* Configure the system clock */
	SystemClock_Config();

	/* Initialize all configured peripherals */
	MX_GPIO_Init();
	MX_SPI1_Init();
	MX_SPI2_Init();
	MX_TIM3_Init();
	MX_TIM16_Init();
	MX_USB_DEVICE_Init();
	/* USER CODE BEGIN 2 */
	CDC_TX_Buffer_Init(); // Put this in USER CODE BEGIN Init ? TODO TODO TODO

	HAL_Delay(1000);

	Init_BMI323();
	ADS131M02_echocore_init();

	HAL_Delay(1000);

	PDEBUG("Enabling interrupts...\r\n");
	HAL_NVIC_SetPriority(ADC_INT_EXTI_IRQn, 1, 0);
  	HAL_NVIC_EnableIRQ(ADC_INT_EXTI_IRQn);

	TIM3->CCR1 = 0;
	TIM3->CCR2 = 0;
	TIM16->CCR1 = 0;
	//HAL_TIM_PWM_Start(&htim3, TIM_CHANNEL_1);
	HAL_TIM_PWM_Start(&htim3, TIM_CHANNEL_2);

	PDEBUG("Beginning task loop...\r\n");

	/* USER CODE END 2 */

	/* Infinite loop */
	/* USER CODE BEGIN WHILE */
	while (1)
	{
		/* USER CODE END WHILE */

		/* USER CODE BEGIN 3 */

		/* Check for received data and interpret */
		if(cdc_int_flag)
		{
			// Interpret UserRxBufferFS based on RX data format

			/* DEBUG */
			PDEBUG("Printing all registers of IMU...\r\n");
			BMI323_Print_ALLRegs();

			/* Reset CDC RX interrupt flag */
			cdc_int_flag = 0;
		}

		/* Update ADC Values */
		ADS131M02_task();

		/* Update IMU Values */
		BMI323Task();

		/* Transmit new packet */
		CDC_Transmit_FS(UserTxBufferFS, APP_TX_DATA_SIZE);
		//HAL_Delay(10000);

		/* Control RGB LEDs based on IMU acceleration */
		// Can use data from UserTxBuffer for this (probably should use mutex tho in case of interrupts)
		// LEDTask();

		/* Testing */
		//CDC_Transmit_FS(UserTxBufferFS, APP_TX_DATA_SIZE);
		//HAL_Delay(10000);
		///uint8_t hi_msg[] = "hello\r\n";
		//CDC_Transmit_FS(hi_msg, sizeof(hi_msg));
		//HAL_Delay(500);
	}
	/* USER CODE END 3 */
}

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
/* USER CODE BEGIN 4 */
static void CDC_TX_Buffer_Init(void)
{
	uint16_t version	= 0x0101; // LSB first for memcpy
	uint32_t eeg_data_start = 0xAAAAAAAA; // LSB first for memcpy
	uint32_t imu_data_start = 0x55555555; // LSB first for memcpy

	// Reset to all 0x00
	memset(UserTxBufferFS, 0, sizeof(UserTxBufferFS));

	/* Initialize header and footer */
	UserTxBufferFS[0] = 0xAA;								// Frame Start
	strcpy((char *)&UserTxBufferFS[1], "GALAHAD LABS");		// Vendor
	strcpy((char *)&UserTxBufferFS[13], "ECHOCORE");		// Product
	memcpy(&UserTxBufferFS[21], &version, 2);				// HW/FW Version
	memcpy(&UserTxBufferFS[27], &eeg_data_start, 4);		// EEG Data Start
	/*
	 * EEG Data
	 */
	memcpy(&UserTxBufferFS[39], &imu_data_start, 4);		// IMU Data Start
	UserTxBufferFS[57] = 0x55;								// Frame End
}


void HAL_GPIO_EXTI_Callback(uint16_t GPIO_Pin)
{
	if(GPIO_Pin == IMU_INT1_Pin) // PB12
	{
		imu_int1_flag = 1;
		PDEBUG("INT1 Triggered\r\n");
		#if defined(FIFO_WM_INT)
			#if defined(USE_BMI323)
			bmi323_fifo_ready = 1;
			#endif
		#endif
	}
	else if(GPIO_Pin == IMU_INT2_Pin) // PA9
	{
		// Conflicts with SPI2 CSN...
		imu_int2_flag = 1;
		PDEBUG("INT2 Triggered\r\n");
	}
	else if(GPIO_Pin == ADC_INT_Pin)
	{
		adc_flag = 1;
		//PDEBUG("ADC INT Triggered\r\n");
	}
}


void PDEBUG(char *format, ...)
{
#if defined(DEBUG_EN)
	char chBuffer[512];
    va_list ap;
    va_start(ap, format);
    vsnprintf(chBuffer, sizeof(chBuffer), format, ap);
    CDC_Transmit_FS((uint8_t *)chBuffer, strlen(chBuffer));
    va_end(ap);
#endif
}
/* USER CODE END 4 */
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
