roboryman/EchoCore/PinOutPlanning_RETS/Core/Inc/bmi3_defs.h

/**
* Copyright (c) 2023 Bosch Sensortec GmbH. All rights reserved.
*
* BSD-3-Clause
*
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
* 1. Redistributions of source code must retain the above copyright
*    notice, this list of conditions and the following disclaimer.
*
* 2. Redistributions in binary form must reproduce the above copyright
*    notice, this list of conditions and the following disclaimer in the
*    documentation and/or other materials provided with the distribution.
*
* 3. Neither the name of the copyright holder nor the names of its
*    contributors may be used to endorse or promote products derived from
*    this software without specific prior written permission.
*
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
* @file       bmi3_defs.h
* @date       2023-02-17
* @version    v2.1.0
*
*/
 #ifndef _BMI3_DEFS_H
 #define _BMI3_DEFS_H

/********************************************************* */
/*!             Header includes                           */
/********************************************************* */
#include <stdint.h>
#include <stddef.h>

/********************************************************* */
/*!             General Macro Definitions                 */
/********************************************************* */
/*! Utility macros */
#define BMI3_SET_BITS(reg_data, bitname, data) \
    ((reg_data & ~(bitname##_MASK)) | \
     ((data << bitname##_POS) & bitname##_MASK))

#define BMI3_GET_BITS(reg_data, bitname) \
    ((reg_data & (bitname##_MASK)) >> \
     (bitname##_POS))

#define BMI3_SET_BIT_POS0(reg_data, bitname, data) \
    ((reg_data & ~(bitname##_MASK)) | \
     (data & bitname##_MASK))

#define BMI3_GET_BIT_POS0(reg_data, bitname)         (reg_data & (bitname##_MASK))
#define BMI3_SET_BIT_VAL0(reg_data, bitname)         (reg_data & ~(bitname##_MASK))

/*! LSB and MSB mask definitions */
#define BMI3_SET_LOW_BYTE                            UINT16_C(0x00FF)
#define BMI3_SET_HIGH_BYTE                           UINT16_C(0xFF00)
#define BMI3_SET_LOW_NIBBLE                          UINT8_C(0x0F)

/*! For getting LSB and MSB */
#define BMI3_GET_LSB(var)                            (uint8_t)(var & BMI3_SET_LOW_BYTE)
#define BMI3_GET_MSB(var)                            (uint8_t)((var & BMI3_SET_HIGH_BYTE) >> 8)

/*! For enable and disable */
#define BMI3_ENABLE                                  UINT8_C(1)
#define BMI3_DISABLE                                 UINT8_C(0)

/*! To define TRUE or FALSE */
#define BMI3_TRUE                                    UINT8_C(1)
#define BMI3_FALSE                                   UINT8_C(0)

/*!
 * BMI3_INTF_RET_TYPE is the read/write interface return type which can be overwritten by the build system.
 * The default is set to int8_t.
 */
#ifndef BMI3_INTF_RET_TYPE
#define BMI3_INTF_RET_TYPE                           int8_t
#endif

/*!
 * BMI3_INTF_RET_SUCCESS is the success return value read/write interface return type which can be
 * overwritten by the build system. The default is set to 0.
 */
#ifndef BMI3_INTF_RET_SUCCESS
#define BMI3_INTF_RET_SUCCESS                        INT8_C(0)
#endif

/*! To define success code */
#define BMI3_OK                                      INT8_C(0)

/*! To define error codes */
#define BMI3_E_NULL_PTR                              INT8_C(-1)
#define BMI3_E_COM_FAIL                              INT8_C(-2)
#define BMI3_E_DEV_NOT_FOUND                         INT8_C(-3)
#define BMI3_E_ACC_INVALID_CFG                       INT8_C(-4)
#define BMI3_E_GYRO_INVALID_CFG                      INT8_C(-5)
#define BMI3_E_INVALID_SENSOR                        INT8_C(-6)
#define BMI3_E_INVALID_INT_PIN                       INT8_C(-7)
#define BMI3_E_INVALID_INPUT                         INT8_C(-8)
#define BMI3_E_INVALID_STATUS                        INT8_C(-9)
#define BMI3_E_DATA_RDY_INT_FAILED                   INT8_C(-10)
#define BMI3_E_INVALID_FOC_POSITION                  INT8_C(-11)
#define BMI3_E_INVALID_ST_SELECTION                  INT8_C(-12)
#define BMI3_E_OUT_OF_RANGE                          INT8_C(-13)
#define BMI3_E_FEATURE_ENGINE_STATUS                 INT8_C(-14)

/*! BMI3 Commands */
#define BMI3_CMD_SELF_TEST_TRIGGER                   UINT16_C(0x0100)
#define BMI3_CMD_SELF_CALIB_TRIGGER                  UINT16_C(0x0101)
#define BMI3_CMD_SELF_CALIB_ABORT                    UINT16_C(0x0200)
#define BMI3_CMD_I3C_TCSYNC_UPDATE                   UINT16_C(0x0201)
#define BMI3_CMD_AXIS_MAP_UPDATE                     UINT16_C(0x0300)
#define BMI3_CMD_1                                   UINT16_C(0x64AD)
#define BMI3_CMD_2                                   UINT16_C(0xD3AC)
#define BMI3_CMD_SOFT_RESET                          UINT16_C(0xDEAF)

/*! To define warnings for FIFO activity */
#define BMI3_W_FIFO_EMPTY                            UINT8_C(1)
#define BMI3_W_PARTIAL_READ                          UINT8_C(2)
#define BMI3_W_ST_PARTIAL_READ                       UINT8_C(3)
#define BMI3_W_FIFO_GYRO_DUMMY_FRAME                 UINT8_C(4)
#define BMI3_W_FIFO_ACCEL_DUMMY_FRAME                UINT8_C(5)
#define BMI3_W_FIFO_TEMP_DUMMY_FRAME                 UINT8_C(6)
#define BMI3_W_FIFO_INVALID_FRAME                    UINT8_C(7)

/*! Masks for FIFO dummy data frames */
#define BMI3_FIFO_GYRO_DUMMY_FRAME                   UINT16_C(0x7f02)
#define BMI3_FIFO_ACCEL_DUMMY_FRAME                  UINT16_C(0x7f01)
#define BMI3_FIFO_TEMP_DUMMY_FRAME                   UINT16_C(0x8000)

/*! Bit wise to define information */
#define BMI3_I_MIN_VALUE                             UINT8_C(1)
#define BMI3_I_MAX_VALUE                             UINT8_C(2)

/*! To define Self-test enable modes */
#define BMI3_ST_ACCEL_ONLY                           UINT8_C(1)
#define BMI3_ST_GYRO_ONLY                            UINT8_C(2)
#define BMI3_ST_BOTH_ACC_GYR                         UINT8_C(3)

/*! Soft-reset delay */
#define BMI3_SOFT_RESET_DELAY                        UINT16_C(2000)

/***************************************************************************** */
/*!         Sensor Macro Definitions                 */
/***************************************************************************** */
/*! Macros to define BMI3 sensor/feature types */
#define BMI3_ACCEL                                   UINT8_C(0)
#define BMI3_GYRO                                    UINT8_C(1)
#define BMI3_SIG_MOTION                              UINT8_C(2)
#define BMI3_ANY_MOTION                              UINT8_C(3)
#define BMI3_NO_MOTION                               UINT8_C(4)
#define BMI3_STEP_COUNTER                            UINT8_C(5)
#define BMI3_TILT                                    UINT8_C(6)
#define BMI3_ORIENTATION                             UINT8_C(7)
#define BMI3_FLAT                                    UINT8_C(8)
#define BMI3_TAP                                     UINT8_C(9)
#define BMI3_ALT_ACCEL                               UINT8_C(10)
#define BMI3_ALT_GYRO                                UINT8_C(11)
#define BMI3_ALT_AUTO_CONFIG                         UINT8_C(12)

/*! Non virtual sensor features */
#define BMI3_TEMP                                    UINT8_C(13)
#define BMI3_I3C_SYNC_ACCEL                          UINT8_C(14)
#define BMI3_I3C_SYNC_GYRO                           UINT8_C(15)
#define BMI3_I3C_SYNC_TEMP                           UINT8_C(16)

#define BMI3_16_BIT_RESOLUTION                       UINT8_C(16)

/*! Masks for mapping of config major and minor mask instances in the system */
#define BMI3_CONFIG_1_MAJOR_MASK                     UINT16_C(0xFC00)
#define BMI3_CONFIG_1_MINOR_MASK                     UINT16_C(0x03FF)
#define BMI3_CONFIG_2_MAJOR_MASK                     UINT16_C(0xFC00)
#define BMI3_CONFIG_2_MINOR_MASK                     UINT16_C(0x03FF)

/*! Bit position for config version */
#define BMI3_CONFIG_POS                              UINT8_C(10)

/*! BMI3 I2C address */
#define BMI3_ADDR_I2C_PRIM                           UINT8_C(0x68)
#define BMI3_ADDR_I2C_SEC                            UINT8_C(0x69)

/********************************************************* */
/*!                 Register Addresses                    */
/********************************************************* */

/*! To define the chip id address */
#define BMI3_REG_CHIP_ID                             UINT8_C(0x00)

/*! Reports sensor error conditions */
#define BMI3_REG_ERR_REG                             UINT8_C(0x01)

/*! Sensor status flags */
#define BMI3_REG_STATUS                              UINT8_C(0x02)

/*! ACC Data X. */
#define BMI3_REG_ACC_DATA_X                          UINT8_C(0x03)

/*! ACC Data Y. */
#define BMI3_REG_ACC_DATA_Y                          UINT8_C(0x04)

/*! ACC Data Z. */
#define BMI3_REG_ACC_DATA_Z                          UINT8_C(0x05)

/*! GYR Data X. */
#define BMI3_REG_GYR_DATA_X                          UINT8_C(0x06)

/*! GYR Data Y. */
#define BMI3_REG_GYR_DATA_Y                          UINT8_C(0x07)

/*! GYR Data Z. */
#define BMI3_REG_GYR_DATA_Z                          UINT8_C(0x08)

/*! Temperature Data.
 *  The resolution is 512 LSB/K.
 *  0x0000 -> 23 degree Celsius
 *  0x8000 -> invalid
 */
#define BMI3_REG_TEMP_DATA                           UINT8_C(0x09)

/*! Sensor time LSW (15:0). */
#define BMI3_REG_SENSOR_TIME_0                       UINT8_C(0x0A)

/*! Sensor time MSW (31:16). */
#define BMI3_REG_SENSOR_TIME_1                       UINT8_C(0x0B)

/*! Saturation flags for each sensor and axis. */
#define BMI3_REG_SAT_FLAGS                           UINT8_C(0x0C)

/*! INT1 Status Register.
 *  This register is clear-on-read.
 */
#define BMI3_REG_INT_STATUS_INT1                     UINT8_C(0x0D)

/*! INT2 Status Register.
 *  This register is clear-on-read.
 */
#define BMI3_REG_INT_STATUS_INT2                     UINT8_C(0x0E)

/*! I3C IBI Status Register.
 *  This register is clear-on-read.
 */
#define BMI3_REG_INT_STATUS_IBI                      UINT8_C(0x0F)

/*! Feature engine configuration, before setting/changing an active configuration the register must be cleared
(set to 0) */
#define BMI3_REG_FEATURE_IO0                         UINT8_C(0x10)

/*! Feature engine I/O register 0. */
#define BMI3_REG_FEATURE_IO1                         UINT8_C(0x11)

/*! Feature engine I/O register 1. */
#define BMI3_REG_FEATURE_IO2                         UINT8_C(0x12)

/*! Feature engine I/O register 2. */
#define BMI3_REG_FEATURE_IO3                         UINT8_C(0x13)

/*! Feature I/O synchronization status and trigger. */
#define BMI3_REG_FEATURE_IO_STATUS                   UINT8_C(0x14)

/*! FIFO fill state in words */
#define BMI3_REG_FIFO_FILL_LEVEL                     UINT8_C(0x15)

/*! FIFO data output register */
#define BMI3_REG_FIFO_DATA                           UINT8_C(0x16)

/*! Sets the output data rate, bandwidth, range and the mode of the accelerometer */
#define BMI3_REG_ACC_CONF                            UINT8_C(0x20)

/*! Sets the output data rate, bandwidth, range and the mode of the gyroscope in the sensor */
#define BMI3_REG_GYR_CONF                            UINT8_C(0x21)

/*! Sets the alternative output data rate, bandwidth, range and the mode of the accelerometer */
#define BMI3_REG_ALT_ACC_CONF                        UINT8_C(0x28)

/*! Sets the alternative output data rate, bandwidth, range and the mode of the gyroscope */
#define BMI3_REG_ALT_GYR_CONF                        UINT8_C(0x29)

/*! Alternate configuration control */
#define BMI3_REG_ALT_CONF                            UINT8_C(0x2A)

/*! Reports the active configuration for the accelerometer and gyroscope */
#define BMI3_REG_ALT_STATUS                          UINT8_C(0x2B)

/*! FIFO watermark level */
#define BMI3_REG_FIFO_WATERMARK                      UINT8_C(0x35)

/*! Configuration of the FIFO data buffer behaviour */
#define BMI3_REG_FIFO_CONF                           UINT8_C(0x36)

/*! Control of the FIFO data buffer */
#define BMI3_REG_FIFO_CTRL                           UINT8_C(0x37)

/*! Configures the electrical behavior of the interrupt pins */
#define BMI3_REG_IO_INT_CTRL                         UINT8_C(0x38)

/*! Interrupt Configuration Register. */
#define BMI3_REG_INT_CONF                            UINT8_C(0x39)

/*! Mapping of feature engine interrupts to outputs */
#define BMI3_REG_INT_MAP1                            UINT8_C(0x3A)

/*! Mapping of feature engine interrupts, data ready interrupts for signals and FIFO buffer interrupts to outputs */
#define BMI3_REG_INT_MAP2                            UINT8_C(0x3B)

/*! Feature engine control register */
#define BMI3_REG_FEATURE_CTRL                        UINT8_C(0x40)

/*! Address register for feature data: configurations and extended output. */
#define BMI3_REG_FEATURE_DATA_ADDR                   UINT8_C(0x41)

/*! I/O port for the data values of the feature engine. */
#define BMI3_REG_FEATURE_DATA_TX                     UINT8_C(0x42)

/*! Status of the data access to the feature engine. */
#define BMI3_REG_FEATURE_DATA_STATUS                 UINT8_C(0x43)

/*! Status of the feature engine. */
#define BMI3_REG_FEATURE_ENGINE_STATUS               UINT8_C(0x45)

/*! Register of extended data on feature events. The register content is valid in combination with an active bit
in INT_STATUS_INT1/2. */
#define BMI3_REG_FEATURE_EVENT_EXT                   UINT8_C(0x47)

/*! Pull down behavior control */
#define BMI3_REG_IO_PDN_CTRL                         UINT8_C(0x4F)

/*! Configuration register for the SPI interface */
#define BMI3_REG_IO_SPI_IF                           UINT8_C(0x50)

/*! Configuration register for the electrical characteristics of the pads */
#define BMI3_REG_IO_PAD_STRENGTH                     UINT8_C(0x51)

/*! Configuration register for the I2C interface. */
#define BMI3_REG_IO_I2C_IF                           UINT8_C(0x52)

/*! ODR Deviation Trim Register (OTP backed) - User mirror register */
#define BMI3_REG_IO_ODR_DEVIATION                    UINT8_C(0x53)

/*! Data path register for the accelerometer offset of axis x */
#define BMI3_REG_ACC_DP_OFF_X                        UINT8_C(0x60)

/*! Data path register for the accelerometer re-scale of axis x */
#define BMI3_REG_ACC_DP_DGAIN_X                      UINT8_C(0x61)

/*! Data path register for the accelerometer offset of axis y */
#define BMI3_REG_ACC_DP_OFF_Y                        UINT8_C(0x62)

/*! Data path register for the accelerometer re-scale of axis y */
#define BMI3_REG_ACC_DP_DGAIN_Y                      UINT8_C(0x63)

/*! Data path register for the accelerometer offset of axis z */
#define BMI3_REG_ACC_DP_OFF_Z                        UINT8_C(0x64)

/*! Data path register for the accelerometer re-scale of axis z */
#define BMI3_REG_ACC_DP_DGAIN_Z                      UINT8_C(0x65)

/*! Data path register for the gyroscope offset of axis x */
#define BMI3_REG_GYR_DP_OFF_X                        UINT8_C(0x66)

/*! Data path register for the gyroscope re-scale of axis x */
#define BMI3_REG_GYR_DP_DGAIN_X                      UINT8_C(0x67)

/*! Data path register for the gyroscope offset of axis y */
#define BMI3_REG_GYR_DP_OFF_Y                        UINT8_C(0x68)

/*! Data path register for the gyroscope re-scale of axis y */
#define BMI3_REG_GYR_DP_DGAIN_Y                      UINT8_C(0x69)

/*! Data path register for the gyroscope offset of axis z */
#define BMI3_REG_GYR_DP_OFF_Z                        UINT8_C(0x6A)

/*! Data path register for the gyroscope re-scale of axis z */
#define BMI3_REG_GYR_DP_DGAIN_Z                      UINT8_C(0x6B)

/*! I3C Timing Control Sync TPH Register */
#define BMI3_REG_I3C_TC_SYNC_TPH                     UINT8_C(0x70)

/*! I3C Timing Control Sync TU Register */
#define BMI3_REG_I3C_TC_SYNC_TU                      UINT8_C(0x71)

/*! I3C Timing Control Sync ODR Register */
#define BMI3_REG_I3C_TC_SYNC_ODR                     UINT8_C(0x72)

/*! Command Register */
#define BMI3_REG_CMD                                 UINT8_C(0x7E)

/*! Reserved configuration */
#define BMI3_REG_CFG_RES                             UINT8_C(0x7F)

/*! Macro to define start address of data in RAM patch */
#define BMI3_CONFIG_ARRAY_DATA_START_ADDR            UINT8_C(4)

/********************************************************* */
/*!               Macros for bit masking                  */
/********************************************************* */

/*! Chip id. */
#define BMI3_CHIP_ID_MASK                            UINT16_C(0x00FF)

#define BMI3_REV_ID_MASK                             UINT8_C(0xF0)
#define BMI3_REV_ID_POS                              UINT8_C(4)

/*! Fatal Error, chip is not in operational state (Boot-, power-system). This flag will be reset only by power-on-reset
 * or soft-reset. */
#define BMI3_FATAL_ERR_MASK                          UINT16_C(0x0001)

/*! Overload of the feature engine detected. This flag is clear-on-read. */
#define BMI3_FEAT_ENG_OVRLD_MASK                     UINT16_C(0x0004)
#define BMI3_FEAT_ENG_OVRLD_POS                      UINT8_C(2)

/*! Watchdog timer of the feature engine triggered. This flag is clear-on-read. */
#define BMI3_FEAT_ENG_WD_MASK                        UINT16_C(0x0010)
#define BMI3_FEAT_ENG_WD_POS                         UINT8_C(4)

/*! Unsupported accelerometer configuration set by user. This flag will be reset when configuration has been corrected.
 * */
#define BMI3_ACC_CONF_ERR_MASK                       UINT16_C(0x0020)
#define BMI3_ACC_CONF_ERR_POS                        UINT8_C(5)

/*! Unsupported gyroscope configuration set by user.
 * This flag will be reset when configuration has been corrected.
 */
#define BMI3_GYR_CONF_ERR_MASK                       UINT16_C(0x0040)
#define BMI3_GYR_CONF_ERR_POS                        UINT8_C(6)

/*! SDR parity error or read abort condition (maximum clock stall time for I3C Read Trasfer) occurred.
 *  This flag is a clear-on-read type. It is cleared automatically once read.
 *  Refer to the MIPI I3C specification chapter 'Master Clock Stalling' for detail info regarding the read abort
 * condition.
 */
#define BMI3_I3C_ERROR0_MASK                         UINT16_C(0x0100)
#define BMI3_I3C_ERROR0_POS                          UINT8_C(8)

/*! S0/S1 error occurred. When S0/S1 error occurs, the slave will recover automatically after 60 us as if we see a
 * HDR-exit pattern on the bus while the flag will persist for notification purpose.
 * This flag is clear-on-read type. It is cleared automatically once read.
 */
#define BMI3_I3C_ERROR3_MASK                         UINT16_C(0x0800)
#define BMI3_I3C_ERROR3_POS                          UINT8_C(11)

/*! '1' after device power up or soft-reset. This flag is clear-on-read. */
#define BMI3_POR_DETECTED_MASK                       UINT16_C(0x0001)

/*! Data ready for Temperature. This flag is clear-on-read. */
#define BMI3_DRDY_TEMP_MASK                          UINT16_C(0x0020)
#define BMI3_DRDY_TEMP_POS                           UINT8_C(5)

/*! Data ready for Gyroscope. This flag is clear-on-read. */
#define BMI3_DRDY_GYR_MASK                           UINT16_C(0x0040)
#define BMI3_DRDY_GYR_POS                            UINT8_C(6)

/*! Data ready for Accelerometer. This flag is clear-on-read. */
#define BMI3_DRDY_ACC_MASK                           UINT16_C(0x0080)
#define BMI3_DRDY_ACC_POS                            UINT8_C(7)

/*! Accel x-axis mask and bit position */
#define BMI3_ACC_X_MASK                              UINT16_C(0xFFFF)

/*! Accel y-axis mask and bit position */
#define BMI3_ACC_Y_MASK                              UINT16_C(0xFFFF)

/*! Accel z-axis mask and bit position */
#define BMI3_ACC_Z_MASK                              UINT16_C(0xFFFF)

/*! Gyro x-axis mask and bit position */
#define BMI3_GYR_X_MASK                              UINT16_C(0xFFFF)

/*! Gyro y-axis mask and bit position */
#define BMI3_GYR_Y_MASK                              UINT16_C(0xFFFF)

/*! Gyro z-axis mask and bit position */
#define BMI3_GYR_Z_MASK                              UINT16_C(0xFFFF)

/*! Temperature value.
 *  T (deg C) := temp_data/512 + 23
 */
#define BMI3_TEMP_DATA_MASK                          UINT16_C(0xFFFF)

/*! Sensor time LSW (15:0) */
#define BMI3_SENSOR_TIME_15_0_MASK                   UINT16_C(0xFFFF)

/*! Sensor time MSW (31:16) */
#define BMI3_SENSOR_TIME_31_16_MASK                  UINT16_C(0xFFFF)

/*! Saturation flag for accel X axis */
#define BMI3_SATF_ACC_X_MASK                         UINT16_C(0x0001)

/*! Saturation flag for accel Y axis */
#define BMI3_SATF_ACC_Y_MASK                         UINT16_C(0x0002)
#define BMI3_SATF_ACC_Y_POS                          UINT8_C(1)

/*! Saturation flag for accel Z axis */
#define BMI3_SATF_ACC_Z_MASK                         UINT16_C(0x0004)
#define BMI3_SATF_ACC_Z_POS                          UINT8_C(2)

/*! Saturation flag for gyro X axis */
#define BMI3_SATF_GYR_X_MASK                         UINT16_C(0x0008)
#define BMI3_SATF_GYR_X_POS                          UINT8_C(3)

/*! Saturation flag for gyro Y axis */
#define BMI3_SATF_GYR_Y_MASK                         UINT16_C(0x0010)
#define BMI3_SATF_GYR_Y_POS                          UINT8_C(4)

/*! Saturation flag for gyro Z axis */
#define BMI3_SATF_GYR_Z_MASK                         UINT16_C(0x0020)
#define BMI3_SATF_GYR_Z_POS                          UINT8_C(5)

/*! IBI status macros */
#define BMI3_IBI_NO_MOTION_MASK                      UINT16_C(0x0001)

#define BMI3_IBI_ANY_MOTION_MASK                     UINT16_C(0x0002)
#define BMI3_IBI_ANY_MOTION_POS                      UINT8_C(1)

#define BMI3_IBI_FLAT_MASK                           UINT16_C(0x0004)
#define BMI3_IBI_FLAT_POS                            UINT8_C(2)

#define BMI3_IBI_ORIENTATION_MASK                    UINT16_C(0x0008)
#define BMI3_IBI_ORIENTATION_POS                     UINT8_C(3)

#define BMI3_IBI_STEP_DETECTOR_MASK                  UINT16_C(0x0010)
#define BMI3_IBI_STEP_DETECTOR_POS                   UINT8_C(4)

#define BMI3_IBI_STEP_COUNTER_MASK                   UINT16_C(0x0020)
#define BMI3_IBI_STEP_COUNTER_POS                    UINT8_C(5)

#define BMI3_IBI_SIG_MOTION_MASK                     UINT16_C(0x0040)
#define BMI3_IBI_SIG_MOTION_POS                      UINT8_C(6)

#define BMI3_IBI_TILT_MASK                           UINT16_C(0x0080)
#define BMI3_IBI_TILT_POS                            UINT8_C(7)

#define BMI3_IBI_TAP_MASK                            UINT16_C(0x0100)
#define BMI3_IBI_TAP_POS                             UINT8_C(8)

#define BMI3_IBI_I3C_MASK                            UINT16_C(0x0200)
#define BMI3_IBI_I3C_POS                             UINT8_C(9)

#define BMI3_IBI_ERR_STATUS_MASK                     UINT16_C(0x0400)
#define BMI3_IBI_ERR_STATUS_POS                      UINT8_C(10)

#define BMI3_IBI_TEMP_DRDY_MASK                      UINT16_C(0x0800)
#define BMI3_IBI_TEMP_DRDY_POS                       UINT8_C(11)

#define BMI3_IBI_GYR_DRDY_MASK                       UINT16_C(0x1000)
#define BMI3_IBI_GYR_DRDY_POS                        UINT8_C(12)

#define BMI3_IBI_ACC_DRDY_MASK                       UINT16_C(0x2000)
#define BMI3_IBI_ACC_DRDY_POS                        UINT8_C(13)

#define BMI3_IBI_FWM_MASK                            UINT16_C(0x4000)
#define BMI3_IBI_FWM_POS                             UINT8_C(14)

#define BMI3_IBI_FFULL_MASK                          UINT16_C(0x8000)
#define BMI3_IBI_FFULL_POS                           UINT8_C(15)

/*! No-motion detection output */
#define BMI3_NO_MOTION_X_EN_MASK                     UINT16_C(0x0001)

/*! No-motion detection output */
#define BMI3_NO_MOTION_Y_EN_MASK                     UINT16_C(0x0002)
#define BMI3_NO_MOTION_Y_EN_POS                      UINT8_C(1)

/*! No-motion detection output */
#define BMI3_NO_MOTION_Z_EN_MASK                     UINT16_C(0x0004)
#define BMI3_NO_MOTION_Z_EN_POS                      UINT8_C(2)

/*! Any-motion detection output */
#define BMI3_ANY_MOTION_X_EN_MASK                    UINT16_C(0x0008)
#define BMI3_ANY_MOTION_X_EN_POS                     UINT8_C(3)

/*! Any-motion detection output */
#define BMI3_ANY_MOTION_Y_EN_MASK                    UINT16_C(0x0010)
#define BMI3_ANY_MOTION_Y_EN_POS                     UINT8_C(4)

/*! Any-motion detection output */
#define BMI3_ANY_MOTION_Z_EN_MASK                    UINT16_C(0x0020)
#define BMI3_ANY_MOTION_Z_EN_POS                     UINT8_C(5)

/*! Flat detection output */
#define BMI3_FLAT_EN_MASK                            UINT16_C(0x0040)
#define BMI3_FLAT_EN_POS                             UINT8_C(6)

/*! Orientation detection output */
#define BMI3_ORIENTATION_EN_MASK                     UINT16_C(0x0080)
#define BMI3_ORIENTATION_EN_POS                      UINT8_C(7)

/*! Step detector output */
#define BMI3_STEP_DETECTOR_EN_MASK                   UINT16_C(0x0100)
#define BMI3_STEP_DETECTOR_EN_POS                    UINT8_C(8)

/*! Step counter watermark output */
#define BMI3_STEP_COUNTER_EN_MASK                    UINT16_C(0x0200)
#define BMI3_STEP_COUNTER_EN_POS                     UINT8_C(9)

/*! Sigmotion detection output */
#define BMI3_SIG_MOTION_EN_MASK                      UINT16_C(0x0400)
#define BMI3_SIG_MOTION_EN_POS                       UINT8_C(10)

/*! Tilt detection output */
#define BMI3_TILT_EN_MASK                            UINT16_C(0x0800)
#define BMI3_TILT_EN_POS                             UINT8_C(11)

/*! Tap detection output */
#define BMI3_TAP_DETECTOR_S_TAP_EN_MASK              UINT16_C(0x1000)
#define BMI3_TAP_DETECTOR_S_TAP_EN_POS               UINT8_C(12)

#define BMI3_TAP_DETECTOR_D_TAP_EN_MASK              UINT16_C(0x2000)
#define BMI3_TAP_DETECTOR_D_TAP_EN_POS               UINT8_C(13)

#define BMI3_TAP_DETECTOR_T_TAP_EN_MASK              UINT16_C(0x4000)
#define BMI3_TAP_DETECTOR_T_TAP_EN_POS               UINT8_C(14)

#define BMI3_I3C_SYNC_FILTER_EN_MASK                 UINT16_C(0x0001)

#define BMI3_I3C_SYNC_EN_MASK                        UINT16_C(0x8000)
#define BMI3_I3C_SYNC_EN_POS                         UINT8_C(15)

/*! Error and status information */
#define BMI3_ERROR_STATUS_MASK                       UINT16_C(0x000F)

#define BMI3_FEAT_ENG_INACT_MASK                     UINT8_C(0x0)

#define BMI3_FEAT_ENG_ACT_MASK                       UINT8_C(0x1)

#define BMI3_INIT_CRC_ERR_MASK                       UINT8_C(0x3)

#define BMI3_UGAIN_OFFS_UPD_ERR_MASK                 UINT8_C(0x4)

#define BMI3_NO_ERROR_MASK                           UINT8_C(0x5)

#define BMI3_AXIS_MAP_ERR_MASK                       UINT8_C(0x6)

#define BMI3_TCSYNC_CONF_ERR_MASK                    UINT8_C(0x8)

#define BMI3_SC_ST_ABORTED_MASK                      UINT8_C(0x9)

#define BMI3_SC_IGNORED_MASK                         UINT8_C(0xA)

#define BMI3_ST_IGNORED_MASK                         UINT8_C(0xB)

#define BMI3_SC_ST_PRECON_ERR_MASK                   UINT8_C(0xC)

#define BMI3_MODE_CHANGE_WHILE_SC_ST_MASK            UINT8_C(0xD)

#define BMI3_POSTPONE_I3C_SYNC_MASK                  UINT8_C(0xE)

#define BMI3_MODE_CHANGE_WHILE_I3C_SYNC_MASK         UINT8_C(0xF)

/*! Self-calibration (gyroscope only) or self-test (accelerometer and/or gyroscope) execution status. 0 indicates that
 * the procedure is ongoing. 1 indicates that the procedure is completed. */
#define BMI3_SC_ST_COMPLETE_MASK                     UINT16_C(0x0010)
#define BMI3_SC_ST_COMPLETE_POS                      UINT8_C(4)

/*! Gyroscope self-calibration result (1=OK, 0=Not OK). Bit sc_st_complete should be 1 prior to reading this bit. */
#define BMI3_GYRO_SC_RESULT_MASK                     UINT16_C(0x0020)
#define BMI3_GYRO_SC_RESULT_POS                      UINT8_C(5)

/*! Accelerometer and/or gyroscope self-test result (1=OK, 0=Not OK). Bit sc_st_complete should be 1 prior to reading
 * this bit. */
#define BMI3_ST_RESULT_MASK                          UINT16_C(0x0040)
#define BMI3_ST_RESULT_POS                           UINT8_C(6)

/*! Insufficient sample rate for either 50Hz or 200Hz or I3C TC-sync feature */
#define BMI3_SAMPLE_RATE_ERR_MASK                    UINT16_C(0x0080)
#define BMI3_SAMPLE_RATE_ERR_POS                     UINT8_C(7)

/*! User gain/offset update execution status. 0 indicates that the procedure is ongoing. 1 indicates that the procedure
 * is completed */
#define BMI3_UGAIN_OFFS_UPD_COMPLETE_MASK            UINT16_C(0x0100)
#define BMI3_UGAIN_OFFS_UPD_COMPLETE_POS             UINT8_C(8)

/*! Axis mapping completed */
#define BMI3_AXIS_MAP_COMPLETE_MASK                  UINT16_C(0x0400)
#define BMI3_AXIS_MAP_COMPLETE_POS                   UINT8_C(10)

/*! Current state of the system */
#define BMI3_STATE_MASK                              UINT16_C(0x1800)
#define BMI3_STATE_POS                               UINT8_C(11)

/*! Before feature engine enable: Feature engine start-up configuration */
#define BMI3_STARTUP_CONFIG_0_MASK                   UINT16_C(0x0FFFF)

/*! Step counter value word-0 (low word) */
#define BMI3_STEP_COUNTER_OUT_0_MASK                 UINT16_C(0x0FFFF)

/*! Before feature engine enable: Feature engine start-up configuration */
#define BMI3_STARTUP_CONFIG_1_MASK                   UINT16_C(0x0FFFF)

/*! Step counter value word-1 (high word) */
#define BMI3_STEP_COUNTER_OUT_1_MASK                 UINT16_C(0x0FFFF)

/*! On read: data has been written by the feature engine On write: data written by the host shall be sent to the feature
 * engine. */
#define BMI3_FEATURE_IO_STATUS_MASK                  UINT16_C(0x0001)

/*! Current fill level of FIFO buffer
 * An empty FIFO corresponds to 0x000. The word counter may be reset by reading out all frames from the FIFO buffer or
 * when the FIFO is reset through fifo_flush. The word counter is updated each time a complete frame was read or
 * written. */
#define BMI3_FIFO_FILL_LEVEL_MASK                    UINT16_C(0x07FF)

/*! FIFO read data (16 bits)
 * Data format depends on the setting of register FIFO_CONF. The FIFO data are organized in frames. The new data flag is
 * preserved. Read burst access must be used, the address will not increment when the read burst reads at the address of
 * FIFO_DATA. When a frame is only partially read out it is retransmitted including the header at the next readout. */
#define BMI3_FIFO_DATA_MASK                          UINT16_C(0x0FFFF)

/*! ODR in Hz */
#define BMI3_ACC_ODR_MASK                            UINT16_C(0x000F)

/*! Full scale, Resolution */
#define BMI3_ACC_RANGE_MASK                          UINT16_C(0x0070)
#define BMI3_ACC_RANGE_POS                           UINT8_C(4)

/*! The Accel bandwidth coefficient defines the 3 dB cutoff frequency in relation to the ODR */
#define BMI3_ACC_BW_MASK                             UINT16_C(0x0080)
#define BMI3_ACC_BW_POS                              UINT8_C(7)

/*! Number of samples to be averaged */
#define BMI3_ACC_AVG_NUM_MASK                        UINT16_C(0x0700)
#define BMI3_ACC_AVG_NUM_POS                         UINT8_C(8)

/*! Defines mode of operation for Accelerometer. DO NOT COPY OPERATION DESCRIPTION TO CUSTOMER SPEC! */
#define BMI3_ACC_MODE_MASK                           UINT16_C(0x7000)
#define BMI3_ACC_MODE_POS                            UINT8_C(12)

/*! ODR in Hz */
#define BMI3_GYR_ODR_MASK                            UINT16_C(0x000F)

/*! Full scale, Resolution */
#define BMI3_GYR_RANGE_MASK                          UINT16_C(0x0070)
#define BMI3_GYR_RANGE_POS                           UINT8_C(4)

/*! The Gyroscope bandwidth coefficient defines the 3 dB cutoff frequency in relation to the ODR */
#define BMI3_GYR_BW_MASK                             UINT16_C(0x0080)
#define BMI3_GYR_BW_POS                              UINT8_C(7)

/*! Number of samples to be averaged */
#define BMI3_GYR_AVG_NUM_MASK                        UINT16_C(0x0700)
#define BMI3_GYR_AVG_NUM_POS                         UINT8_C(8)

/*! Defines mode of operation for Gyroscope.DO NOT COPY OPERATION DESCRIPTION TO CUSTOMER SPEC! */
#define BMI3_GYR_MODE_MASK                           UINT16_C(0x7000)
#define BMI3_GYR_MODE_POS                            UINT8_C(12)

/*! ODR in Hz */
#define BMI3_ALT_ACC_ODR_MASK                        UINT16_C(0x000F)

/*! Number of samples to be averaged */
#define BMI3_ALT_ACC_AVG_NUM_MASK                    UINT16_C(0x0700)
#define BMI3_ALT_ACC_AVG_NUM_POS                     UINT8_C(8)

/*! Defines mode of operation for Accelerometer. DO NOT COPY OPERATION DESCRIPTION TO CUSTOMER SPEC! */
#define BMI3_ALT_ACC_MODE_MASK                       UINT16_C(0x7000)
#define BMI3_ALT_ACC_MODE_POS                        UINT8_C(12)

/*! ODR in Hz */
#define BMI3_ALT_GYR_ODR_MASK                        UINT16_C(0x000F)

/*! Number of samples to be averaged */
#define BMI3_ALT_GYR_AVG_NUM_MASK                    UINT16_C(0x0700)
#define BMI3_ALT_GYR_AVG_NUM_POS                     UINT8_C(8)

/*! Defines mode of operation for Gyroscope.DO NOT COPY OPERATION DESCRIPTION TO CUSTOMER SPEC! */
#define BMI3_ALT_GYR_MODE_MASK                       UINT16_C(0x7000)
#define BMI3_ALT_GYR_MODE_POS                        UINT8_C(12)

/*! Enables switching possibility to alternate configuration for accel */
#define BMI3_ALT_ACC_EN_MASK                         UINT16_C(0x0001)

/*! Enables switching possibility to alternate configuration for gyro */
#define BMI3_ALT_GYR_EN_MASK                         UINT16_C(0x0010)
#define BMI3_ALT_GYR_EN_POS                          UINT8_C(4)

/*! If enabled, any write to ACC_CONF or GYR_CONF will instanly switch back to associated user configuration */
#define BMI3_ALT_RST_CONF_WRITE_EN_MASK              UINT16_C(0x0100)
#define BMI3_ALT_RST_CONF_WRITE_EN_POS               UINT8_C(8)

/*! Accel is using ALT_ACC_CONF if set; ACC_CONF otherwise */
#define BMI3_ALT_ACC_ACTIVE_MASK                     UINT16_C(0x0001)

/*! Gyro is using ALT_GYR_CONF if set; GYR_CONF otherwise */
#define BMI3_ALT_GYR_ACTIVE_MASK                     UINT16_C(0x0010)
#define BMI3_ALT_GYR_ACTIVE_POS                      UINT8_C(4)

/*! Trigger an interrupt when FIFO contains fifo_watermark words */
#define BMI3_FIFO_WATERMARK_MASK                     UINT16_C(0x03FF)

/*! Stop writing samples into fifo when fifo is full */
#define BMI3_FIFO_STOP_ON_FULL_MASK                  UINT16_C(0x0001)

/*! Store Sensortime data in FIFO */
#define BMI3_FIFO_TIME_EN_MASK                       UINT16_C(0x0100)
#define BMI3_FIFO_TIME_EN_POS                        UINT8_C(8)

/*! Store Accelerometer data in FIFO (all 3 axes) */
#define BMI3_FIFO_ACC_EN_MASK                        UINT16_C(0x0200)
#define BMI3_FIFO_ACC_EN_POS                         UINT8_C(9)

/*! Store Gyroscope data in FIFO (all 3 axes) */
#define BMI3_FIFO_GYR_EN_MASK                        UINT16_C(0x0400)
#define BMI3_FIFO_GYR_EN_POS                         UINT8_C(10)

/*! Store temperature data in FIFO */
#define BMI3_FIFO_TEMP_EN_MASK                       UINT16_C(0x0800)
#define BMI3_FIFO_TEMP_EN_POS                        UINT8_C(11)

/*! Clear all fifo data; do not touch configuration. */
#define BMI3_FIFO_FLUSH_MASK                         UINT16_C(0x0001)

/*! Configure level of INT1 pin */
#define BMI3_INT1_LVL_MASK                           UINT16_C(0x0001)

/*! Configure behavior of INT1 pin */
#define BMI3_INT1_OD_MASK                            UINT16_C(0x0002)
#define BMI3_INT1_OD_POS                             UINT8_C(1)

/*! Output enable for INT1 pin */
#define BMI3_INT1_OUTPUT_EN_MASK                     UINT16_C(0x0004)
#define BMI3_INT1_OUTPUT_EN_POS                      UINT8_C(2)

/*! Configure level of INT2 pin */
#define BMI3_INT2_LVL_MASK                           UINT16_C(0x0100)
#define BMI3_INT2_LVL_POS                            UINT8_C(8)

/*! Configure behavior of INT2 pin */
#define BMI3_INT2_OD_MASK                            UINT16_C(0x0200)
#define BMI3_INT2_OD_POS                             UINT8_C(9)

/*! Output enable for INT2 pin */
#define BMI3_INT2_OUTPUT_EN_MASK                     UINT16_C(0x0400)
#define BMI3_INT2_OUTPUT_EN_POS                      UINT8_C(10)

/*! Mask definitions for interrupt pin configuration */
#define BMI3_INT_LATCH_MASK                          UINT16_C(0x0001)

/*! Map no-motion output to either INT1 or INT2 or IBI */
#define BMI3_NO_MOTION_OUT_MASK                      UINT16_C(0x0003)

/*! Map any-motion output to either INT1 or INT2 or IBI */
#define BMI3_ANY_MOTION_OUT_MASK                     UINT16_C(0x000C)
#define BMI3_ANY_MOTION_OUT_POS                      UINT8_C(2)

/*! Map flat output to either INT1 or INT2 or IBI */
#define BMI3_FLAT_OUT_MASK                           UINT16_C(0x0030)
#define BMI3_FLAT_OUT_POS                            UINT8_C(4)

/*! Map orientation output to either INT1 or INT2 or IBI */
#define BMI3_ORIENTATION_OUT_MASK                    UINT8_C(0x00C0)
#define BMI3_ORIENTATION_OUT_POS                     UINT8_C(6)

/*! Map step_detector output to either INT1 or INT2 or IBI */
#define BMI3_STEP_DETECTOR_OUT_MASK                  UINT8_C(0x0300)
#define BMI3_STEP_DETECTOR_OUT_POS                   UINT8_C(8)

/*! Map step_counter watermark output to either INT1 or INT2 or IBI */
#define BMI3_STEP_COUNTER_OUT_MASK                   UINT8_C(0x0C00)
#define BMI3_STEP_COUNTER_OUT_POS                    UINT8_C(10)

/*! Map sigmotion output to either INT1 or INT2 or IBI */
#define BMI3_SIG_MOTION_OUT_MASK                     UINT16_C(0x3000)
#define BMI3_SIG_MOTION_OUT_POS                      UINT8_C(12)

/*! Map tilt output to either INT1 or INT2 or IBI */
#define BMI3_TILT_OUT_MASK                           UINT16_C(0xC000)
#define BMI3_TILT_OUT_POS                            UINT8_C(14)

/*! Map tap output to either INT1 or INT2 or IBI */
#define BMI3_TAP_OUT_MASK                            UINT16_C(0x0003)
#define BMI3_TAP_OUT_POS                             UINT8_C(0)

/*! Map i3c output to either INT1 or INT2 or IBI */
#define BMI3_I3C_OUT_MASK                            UINT16_C(0x000C)
#define BMI3_I3C_OUT_POS                             UINT8_C(2)

/*! Map feature engine's error or status change to either INT1 or INT2 or IBI */
#define BMI3_ERR_STATUS_MASK                         UINT16_C(0x0030)
#define BMI3_ERR_STATUS_POS                          UINT8_C(4)

/*! Map temperature data ready interrupt to either INT1 or INT2 or IBI */
#define BMI3_TEMP_DRDY_INT_MASK                      UINT16_C(0x00C0)
#define BMI3_TEMP_DRDY_INT_POS                       UINT8_C(6)

/*! Map gyro data ready interrupt to either INT1 or INT2 or IBI */
#define BMI3_GYR_DRDY_INT_MASK                       UINT16_C(0x0300)
#define BMI3_GYR_DRDY_INT_POS                        UINT8_C(8)

/*! Map accel data ready interrupt to either INT1 or INT2 or IBI */
#define BMI3_ACC_DRDY_INT_MASK                       UINT16_C(0x0C00)
#define BMI3_ACC_DRDY_INT_POS                        UINT8_C(10)

/*! Map FIFO watermark interrupt to either INT1 or INT2 or IBI */
#define BMI3_FIFO_WATERMARK_INT_MASK                 UINT16_C(0x3000)
#define BMI3_FIFO_WATERMARK_INT_POS                  UINT8_C(12)

/*! Map FIFO full interrupt to either INT1 or INT2 or IBI */
#define BMI3_FIFO_FULL_INT_MASK                      UINT16_C(0xC000)
#define BMI3_FIFO_FULL_INT_POS                       UINT8_C(14)

/*! Enable or disable the feature engine. Note: a soft-reset is required to re-enable the feature engine. */
#define BMI3_ENGINE_EN_MASK                          UINT16_C(0x0001)

/*! Start address for the feature data, that is feature configurations and extended feature output. */
#define BMI3_DATA_ADDRESS_MASK                       UINT16_C(0x07FF)

/*! Data port for DMA transfers. */
#define BMI3_DATA_TX_VALUE_MASK                      UINT16_C(0xFFFF)

/*! Out of bounds error. Cleared on next TX. */
#define BMI3_DATA_OUTOFBOUND_ERR_MASK                UINT16_C(0x0001)

/*! DMA is ready to use. If this bit is 0, DMA access will not work. */
#define BMI3_DATA_TX_READY_MASK                      UINT16_C(0x0002)
#define BMI3_DATA_TX_READY_POS                       UINT8_C(1)

/*! Feature engine is in sleep/halt state (will be reset after read) */
#define BMI3_SLEEP_MASK                              UINT16_C(0x0001)

/*! Transfer of data to or from the feature engine is ongoing. */
#define BMI3_OVERLOAD_MASK                           UINT16_C(0x0002)
#define BMI3_OVERLOAD_POS                            UINT8_C(1)

/*! DMA controller has started DMA and DMA transactions are ongoing */
#define BMI3_DATA_TX_ACTIVE_MASK                     UINT16_C(0x0008)
#define BMI3_DATA_TX_ACTIVE_POS                      UINT8_C(3)

/*! Feature engine was disabled by the host. Perform a soft-reset to re-enable the feature engine. */
#define BMI3_DISABLED_BY_HOST_MASK                   UINT16_C(0x0010)
#define BMI3_DISABLED_BY_HOST_POS                    UINT8_C(4)

/*! The feature engine did not acknowledge its internal watchdog in time. Perform a soft-reset to re-enable the feature
 * engine. */
#define BMI3_WATCHDOG_NOT_ACK_MASK                   UINT16_C(0x0020)
#define BMI3_WATCHDOG_NOT_ACK_POS                    UINT8_C(5)

/*! Output value of the orientation detection feature. Value after device initialization is 0b00 i.e. Portrait upright
 * */
#define BMI3_ORIENTATION_PORTRAIT_LANDSCAPE_MASK     UINT16_C(0x0003)

/*! Output value of face down face up orientation (only if ud_en is enabled). Value after device initialization is 0b0
 * i.e. Face up */
#define BMI3_ORIENTATION_FACEUP_DOWN_MASK            UINT16_C(0x0004)
#define BMI3_ORIENTATION_FACEUP_DOWN_POS             UINT8_C(2)

/*! Single tap detected */
#define BMI3_S_TAP_MASK                              UINT16_C(0x0008)
#define BMI3_S_TAP_POS                               UINT8_C(3)

/*! Double tap detected */
#define BMI3_D_TAP_MASK                              UINT16_C(0x0010)
#define BMI3_D_TAP_POS                               UINT8_C(4)

/*! Triple tap detected */
#define BMI3_T_TAP_MASK                              UINT16_C(0x0020)
#define BMI3_T_TAP_POS                               UINT8_C(5)

/*! Pull down behavior control */
#define BMI3_ANAIO_PDN_DIS                           UINT16_C(0x0001)

/*! Mask definitions for SPI read/write address */
#define BMI3_SPI_RD_MASK                             UINT16_C(0x80)
#define BMI3_SPI_WR_MASK                             UINT16_C(0x7F)

/*! Enable SPI PIN3 mode. Default is PIN4 mode. */
#define BMI3_SPI3_EN_MASK                            UINT16_C(0x0001)

/*! Generic output pad drive strength primary interface, 0: weakest; 7: strongest */
#define BMI3_IF_DRV_MASK                             UINT16_C(0x0007)

/*! SDX I2C control bit - increase drive strength */
#define BMI3_IF_I2C_BOOST_MASK                       UINT16_C(0x0008)
#define BMI3_IF_I2C_BOOST_POS                        UINT8_C(3)

/*! Select timer period for I2C Watchdog */
#define BMI3_WATCHDOG_TIMER_SEL_MASK                 UINT16_C(0x0001)

/*! I2C Watchdog at the SDI pin in I2C interface mode */
#define BMI3_WATCHDOG_TIMER_EN_MASK                  UINT16_C(0x0002)
#define BMI3_WATCHDOG_TIMER_EN_POS                   UINT8_C(1)

/*! ODR clock deviation */
#define BMI3_ODR_DEVIATION_MASK                      UINT16_C(0x001F)

/*! Data path register for the temperature independent accelerometer re-scale of axis z */
#define BMI3_ACC_DP_DGAIN_X_MASK                     UINT16_C(0x00FF)

/*! Data path register for the temperature independent accelerometer re-scale of axis z */
#define BMI3_ACC_DP_DGAIN_Y_MASK                     UINT16_C(0x00FF)

/*! Data path register for the temperature independent accelerometer re-scale of axis z */
#define BMI3_ACC_DP_DGAIN_Z_MASK                     UINT16_C(0x00FF)

/*! Data path register for the temperature independent accelerometer offset of axis x */
#define BMI3_GYR_DP_OFF_X_MASK                       UINT16_C(0x03FF)

/*! Data path register for the temperature independent accelerometer offset of axis y */
#define BMI3_GYR_DP_DGAIN_X_MASK                     UINT16_C(0x007F)

/*! Data path register for the temperature independent accelerometer offset of axis y */
#define BMI3_GYR_DP_OFF_Y_MASK                       UINT16_C(0x03FF)

/*! Data path register for the temperature independent accelerometer re-scale of axis z */
#define BMI3_GYR_DP_DGAIN_Y_MASK                     UINT16_C(0x007F)

/*! Data path register for the temperature independent accelerometer offset of axis z */
#define BMI3_GYR_DP_OFF_Z_MASK                       UINT16_C(0x03FF)

/*! Data path register for the temperature independent accelerometer re-scale of axis z */
#define BMI3_GYR_DP_DGAIN_Z_MASK                     UINT16_C(0x007F)

/*! I3C Timing Control Sync TPH Register */
#define BMI3_I3C_TC_SYNC_TPH_MASK                    UINT16_C(0xFFFF)

/*! I3C Timing Control Sync TU Register */
#define BMI3_I3C_TC_SYNC_TU_MASK                     UINT16_C(0x00FF)

/*! I3C Timing Control Sync ODR Register */
#define BMI3_I3C_TC_SYNC_ODR_MASK                    UINT16_C(0x00FF)

/*! Available commands (Note: Register will always return 0x00 as read result) */
#define BMI3_CMD_MASK                                UINT16_C(0xFFFF)

/*! Value one address mask and bit position */
#define BMI3_VALUE_1_MASK                            UINT16_C(0x001F)

/*! Value two address mask and bit position */
#define BMI3_VALUE_2_MASK                            UINT16_C(0xC000)
#define BMI3_VALUE_2_POS                             UINT8_C(14)

/*! Feature engine enable mask */
#define BMI3_FEATURE_ENGINE_ENABLE_MASK              UINT16_C(0X0001)

#define BMI3_SC_ST_STATUS_MASK                       UINT8_C(0x10)
#define BMI3_SC_ST_RESULT_MASK                       UINT8_C(0x40)

#define BMI3_ST_ACC_X_OK_MASK                        UINT8_C(0x01)
#define BMI3_ST_ACC_Y_OK_MASK                        UINT8_C(0x02)
#define BMI3_ST_ACC_Z_OK_MASK                        UINT8_C(0x04)
#define BMI3_ST_GYR_X_OK_MASK                        UINT8_C(0x08)
#define BMI3_ST_GYR_Y_OK_MASK                        UINT8_C(0x10)
#define BMI3_ST_GYR_Z_OK_MASK                        UINT8_C(0x20)
#define BMI3_ST_GYR_DRIVE_OK_MASK                    UINT8_C(0x40)

#define BMI3_ST_ACC_X_OK_POS                         UINT8_C(0)
#define BMI3_ST_ACC_Y_OK_POS                         UINT8_C(1)
#define BMI3_ST_ACC_Z_OK_POS                         UINT8_C(2)
#define BMI3_ST_GYR_X_OK_POS                         UINT8_C(3)
#define BMI3_ST_GYR_Y_OK_POS                         UINT8_C(4)
#define BMI3_ST_GYR_Z_OK_POS                         UINT8_C(5)
#define BMI3_ST_GYR_DRIVE_OK_POS                     UINT8_C(6)

/*! Macros to define values of BMI3 axis and its sign for re-map settings */
#define BMI3_MAP_XYZ_AXIS                            UINT8_C(0x00)
#define BMI3_MAP_YXZ_AXIS                            UINT8_C(0x01)
#define BMI3_MAP_XZY_AXIS                            UINT8_C(0x02)
#define BMI3_MAP_ZXY_AXIS                            UINT8_C(0x03)
#define BMI3_MAP_YZX_AXIS                            UINT8_C(0x04)
#define BMI3_MAP_ZYX_AXIS                            UINT8_C(0x05)
#define BMI3_MAP_POSITIVE                            UINT8_C(0x00)
#define BMI3_MAP_NEGATIVE                            UINT8_C(0x01)

/*! Remap Axes */
#define BMI3_XYZ_AXIS_MASK                           UINT8_C(0x07)
#define BMI3_X_AXIS_SIGN_MASK                        UINT8_C(0x08)
#define BMI3_Y_AXIS_SIGN_MASK                        UINT8_C(0x10)
#define BMI3_Z_AXIS_SIGN_MASK                        UINT8_C(0x20)

/*! Bit position definitions of BMI3 axis re-mapping */
#define BMI3_X_AXIS_SIGN_POS                         UINT8_C(3)
#define BMI3_Y_AXIS_SIGN_POS                         UINT8_C(4)
#define BMI3_Z_AXIS_SIGN_POS                         UINT8_C(5)

/*! Feature interrupt status bit values */
#define BMI3_INT_STATUS_NO_MOTION                    UINT16_C(0x0001)
#define BMI3_INT_STATUS_ANY_MOTION                   UINT16_C(0x0002)
#define BMI3_INT_STATUS_FLAT                         UINT16_C(0x0004)
#define BMI3_INT_STATUS_ORIENTATION                  UINT16_C(0x0008)
#define BMI3_INT_STATUS_STEP_DETECTOR                UINT16_C(0x0010)
#define BMI3_INT_STATUS_STEP_COUNTER                 UINT16_C(0x0020)
#define BMI3_INT_STATUS_SIG_MOTION                   UINT16_C(0x0040)
#define BMI3_INT_STATUS_TILT                         UINT16_C(0x0080)
#define BMI3_INT_STATUS_TAP                          UINT16_C(0x0100)
#define BMI3_INT_STATUS_I3C                          UINT16_C(0x0200)
#define BMI3_INT_STATUS_ERR                          UINT16_C(0x0400)
#define BMI3_INT_STATUS_TEMP_DRDY                    UINT16_C(0x0800)
#define BMI3_INT_STATUS_GYR_DRDY                     UINT16_C(0x1000)
#define BMI3_INT_STATUS_ACC_DRDY                     UINT16_C(0x2000)
#define BMI3_INT_STATUS_FWM                          UINT16_C(0x4000)
#define BMI3_INT_STATUS_FFULL                        UINT16_C(0x8000)

/*! IBI status bit values */
#define BMI3_IBI_STATUS_NO_MOTION                    UINT16_C(0x0001)
#define BMI3_IBI_STATUS_ANY_MOTION                   UINT16_C(0x0002)
#define BMI3_IBI_STATUS_FLAT                         UINT16_C(0x0004)
#define BMI3_IBI_STATUS_ORIENTATION                  UINT16_C(0x0008)
#define BMI3_IBI_STATUS_STEP_DETECTOR                UINT16_C(0x0010)
#define BMI3_IBI_STATUS_STEP_COUNTER                 UINT16_C(0x0020)
#define BMI3_IBI_STATUS_SIG_MOTION                   UINT16_C(0x0040)
#define BMI3_IBI_STATUS_TILT                         UINT16_C(0x0080)
#define BMI3_IBI_STATUS_TAP                          UINT16_C(0x0100)
#define BMI3_IBI_STATUS_I3C                          UINT16_C(0x0200)
#define BMI3_IBI_STATUS_ERR_STATUS                   UINT16_C(0x0400)
#define BMI3_IBI_STATUS_TEMP_DRDY                    UINT16_C(0x0800)
#define BMI3_IBI_STATUS_GYR_DRDY                     UINT16_C(0x1000)
#define BMI3_IBI_STATUS_ACC_DRDY                     UINT16_C(0x2000)
#define BMI3_IBI_STATUS_FWM                          UINT16_C(0x4000)
#define BMI3_IBI_STATUS_FFULL                        UINT16_C(0x8000)

/******************************************************************************/
/*!  Mask definitions for feature interrupts configuration  */
/******************************************************************************/
#define BMI3_ANY_NO_SLOPE_THRESHOLD_MASK             UINT16_C(0x0FFF)

#define BMI3_ANY_NO_ACC_REF_UP_MASK                  UINT16_C(0x1000)
#define BMI3_ANY_NO_ACC_REF_UP_POS                   UINT8_C(12)

#define BMI3_ANY_NO_HYSTERESIS_MASK                  UINT16_C(0x03FF)

#define BMI3_ANY_NO_DURATION_MASK                    UINT16_C(0x1FFF)

#define BMI3_ANY_NO_WAIT_TIME_MASK                   UINT16_C(0xE000)
#define BMI3_ANY_NO_WAIT_TIME_POS                    UINT8_C(13)

/*! Bit mask definitions for BMI3 flat feature configuration */
#define BMI3_FLAT_THETA_MASK                         UINT16_C(0x003F)
#define BMI3_FLAT_BLOCKING_MASK                      UINT16_C(0x00C0)
#define BMI3_FLAT_HOLD_TIME_MASK                     UINT16_C(0xFF00)
#define BMI3_FLAT_SLOPE_THRES_MASK                   UINT16_C(0x00FF)
#define BMI3_FLAT_HYST_MASK                          UINT16_C(0XFF00)

/*! Bit position definitions for BMI3 flat feature configuration */
#define BMI3_FLAT_BLOCKING_POS                       UINT8_C(0x06)
#define BMI3_FLAT_HOLD_TIME_POS                      UINT8_C(0x08)
#define BMI3_FLAT_HYST_POS                           UINT8_C(0x08)

/*! Bit mask definitions for BMI3 significant motion feature configuration */
#define BMI3_SIG_BLOCK_SIZE_MASK                     UINT16_C(0xFFFF)

#define BMI3_SIG_P2P_MIN_MASK                        UINT16_C(0x03FF)

#define BMI3_SIG_MCR_MIN_MASK                        UINT16_C(0xFC00)
#define BMI3_SIG_MCR_MIN_POS                         UINT8_C(10)

#define BMI3_SIG_P2P_MAX_MASK                        UINT16_C(0x03FF)

#define BMI3_MCR_MAX_MASK                            UINT16_C(0xFC00)
#define BMI3_MCR_MAX_POS                             UINT8_C(10)

/*! Bit mask definitions for BMI3 tilt feature configuration */
#define BMI3_TILT_SEGMENT_SIZE_MASK                  UINT16_C(0x00FF)

#define BMI3_TILT_MIN_TILT_ANGLE_MASK                UINT16_C(0xFF00)
#define BMI3_TILT_MIN_TILT_ANGLE_POS                 UINT8_C(8)

#define BMI3_TILT_BETA_ACC_MEAN_MASK                 UINT16_C(0xFFFF)

/*! Bit mask definitions for BMI3 orientation feature configuration */
#define BMI3_ORIENT_UD_EN_MASK                       UINT16_C(0x0001)
#define BMI3_ORIENT_MODE_MASK                        UINT16_C(0x0006)
#define BMI3_ORIENT_BLOCKING_MASK                    UINT16_C(0x0018)
#define BMI3_ORIENT_THETA_MASK                       UINT16_C(0x07E0)
#define BMI3_ORIENT_HOLD_TIME_MASK                   UINT16_C(0XF800)
#define BMI3_ORIENT_SLOPE_THRES_MASK                 UINT16_C(0X00FF)
#define BMI3_ORIENT_HYST_MASK                        UINT16_C(0XFF00)

/*! Bit position definitions for BMI3 orientation feature configuration */
#define BMI3_ORIENT_MODE_POS                         UINT8_C(1)
#define BMI3_ORIENT_BLOCKING_POS                     UINT8_C(3)
#define BMI3_ORIENT_THETA_POS                        UINT8_C(5)
#define BMI3_ORIENT_HOLD_TIME_POS                    UINT8_C(11)
#define BMI3_ORIENT_HYST_POS                         UINT8_C(8)

/*! Bit position definitions for BMI3 step counter feature configuration */
#define BMI3_STEP_WATERMARK_MASK                     UINT16_C(0x3FF)

#define BMI3_STEP_RESET_COUNTER_MASK                 UINT16_C(0x0400)
#define BMI3_STEP_RESET_COUNTER_POS                  UINT8_C(10)

#define BMI3_STEP_ENV_MIN_DIST_UP_MASK               UINT16_C(0xFFFF)

#define BMI3_STEP_ENV_COEF_UP_MASK                   UINT16_C(0xFFFF)

#define BMI3_STEP_ENV_MIN_DIST_DOWN_MASK             UINT16_C(0xFFFF)

#define BMI3_STEP_ENV_COEF_DOWN_MASK                 UINT16_C(0xFFFF)

#define BMI3_STEP_MEAN_VAL_DECAY_MASK                UINT16_C(0xFFFF)

#define BMI3_STEP_MEAN_STEP_DUR_MASK                 UINT16_C(0xFFFF)

#define BMI3_STEP_BUFFER_SIZE_MASK                   UINT16_C(0x000F)

#define BMI3_STEP_FILTER_CASCADE_ENABLED_MASK        UINT16_C(0x0010)
#define BMI3_STEP_FILTER_CASCADE_ENABLED_POS         UINT8_C(4)

#define BMI3_STEP_COUNTER_INCREMENT_MASK             UINT16_C(0xFFE0)
#define BMI3_STEP_COUNTER_INCREMENT_POS              UINT8_C(5)

#define BMI3_STEP_PEAK_DURATION_MIN_WALKING_MASK     UINT16_C(0x00FF)

#define BMI3_STEP_PEAK_DURATION_MIN_RUNNING_MASK     UINT16_C(0xFF00)
#define BMI3_STEP_PEAK_DURATION_MIN_RUNNING_POS      UINT8_C(8)

#define BMI3_STEP_ACTIVITY_DETECTION_FACTOR_MASK     UINT16_C(0x000F)

#define BMI3_STEP_ACTIVITY_DETECTION_THRESHOLD_MASK  UINT16_C(0xFFF0)
#define BMI3_STEP_ACTIVITY_DETECTION_THRESHOLD_POS   UINT8_C(4)

#define BMI3_STEP_DURATION_MAX_MASK                  UINT16_C(0x00FF)

#define BMI3_STEP_DURATION_WINDOW_MASK               UINT16_C(0xFF00)
#define BMI3_STEP_DURATION_WINDOW_POS                UINT8_C(8)

#define BMI3_STEP_DURATION_PP_ENABLED_MASK           UINT16_C(0x0001)

#define BMI3_STEP_DURATION_THRESHOLD_MASK            UINT16_C(0x000E)
#define BMI3_STEP_DURATION_THRESHOLD_POS             UINT8_C(1)

#define BMI3_STEP_MEAN_CROSSING_PP_ENABLED_MASK      UINT16_C(0x0010)
#define BMI3_STEP_MEAN_CROSSING_PP_ENABLED_POS       UINT8_C(4)

#define BMI3_STEP_MCR_THRESHOLD_MASK                 UINT16_C(0x03E0)
#define BMI3_STEP_MCR_THRESHOLD_POS                  UINT8_C(5)

#define BMI3_STEP_SC_12_RES_MASK                     UINT16_C(0x0C00)
#define BMI3_STEP_SC_12_RES_POS                      UINT8_C(10)

/*! Bit mask definitions for BMI3 tap feature configuration */
#define BMI3_TAP_AXIS_SEL_MASK                       UINT16_C(0x0003)
#define BMI3_TAP_WAIT_FR_TIME_OUT_MASK               UINT16_C(0x0004)
#define BMI3_TAP_MAX_PEAKS_MASK                      UINT16_C(0x0038)
#define BMI3_TAP_MODE_MASK                           UINT16_C(0x00C0)
#define BMI3_TAP_PEAK_THRES_MASK                     UINT16_C(0X03FF)
#define BMI3_TAP_MAX_GEST_DUR_MASK                   UINT16_C(0XFC00)
#define BMI3_TAP_MAX_DUR_BW_PEAKS_MASK               UINT16_C(0X000F)
#define BMI3_TAP_SHOCK_SETT_DUR_MASK                 UINT16_C(0X00F0)
#define BMI3_TAP_MIN_QUITE_DUR_BW_TAPS_MASK          UINT16_C(0X0F00)
#define BMI3_TAP_QUITE_TIME_AFTR_GEST_MASK           UINT16_C(0XF000)

/*! Bit position definitions for BMI3 tap feature configuration */
#define BMI3_TAP_WAIT_FR_TIME_OUT_POS                UINT8_C(0x02)
#define BMI3_TAP_MAX_PEAKS_POS                       UINT8_C(0x03)
#define BMI3_TAP_MODE_POS                            UINT8_C(0x06)
#define BMI3_TAP_MAX_GEST_DUR_POS                    UINT8_C(0x0A)
#define BMI3_TAP_SHOCK_SETT_DUR_POS                  UINT8_C(0x04)
#define BMI3_TAP_MIN_QUITE_DUR_BW_TAPS_POS           UINT8_C(0x08)
#define BMI3_TAP_QUITE_TIME_AFTR_GEST_POS            UINT8_C(0x0C)

#define BMI3_TAP_DET_STATUS_SINGLE                   UINT16_C(0X0008)
#define BMI3_TAP_DET_STATUS_DOUBLE                   UINT16_C(0X0010)
#define BMI3_TAP_DET_STATUS_TRIPLE                   UINT16_C(0X0020)

/*! Bit mask definitions for BMI3 accel gyro user gain and offset */
#define BMI3_ACC_OFF_GAIN_RESET_MASK                 UINT16_C(0x0001)
#define BMI3_GYR_OFF_GAIN_RESET_MASK                 UINT16_C(0x0002)
#define BMI3_ACC_USR_OFF_X_MASK                      UINT16_C(0x3FFF)
#define BMI3_ACC_USR_OFF_Y_MASK                      UINT16_C(0x3FFF)
#define BMI3_ACC_USR_OFF_Z_MASK                      UINT16_C(0x3FFF)
#define BMI3_ACC_USR_GAIN_X_MASK                     UINT16_C(0x00FF)
#define BMI3_ACC_USR_GAIN_Y_MASK                     UINT16_C(0x00FF)
#define BMI3_ACC_USR_GAIN_Z_MASK                     UINT16_C(0x00FF)
#define BMI3_GYR_USR_OFF_X_MASK                      UINT16_C(0x03FF)
#define BMI3_GYR_USR_OFF_Y_MASK                      UINT16_C(0x03FF)
#define BMI3_GYR_USR_OFF_Z_MASK                      UINT16_C(0x03FF)
#define BMI3_GYR_USR_GAIN_X_MASK                     UINT16_C(0x007F)
#define BMI3_GYR_USR_GAIN_Y_MASK                     UINT16_C(0x007F)
#define BMI3_GYR_USR_GAIN_Z_MASK                     UINT16_C(0x007F)

/*! Data path register for the temperature independent accelerometer offset of axis x */
#define BMI3_ACC_DP_OFF_XYZ_13_BIT_MASK              UINT16_C(0x1FFF)
#define BMI3_ACC_DP_OFF_XYZ_14_BIT_MASK              UINT16_C(0x3FFF)

/*! Bit position definitions for BMI3 accel gyro user gain and offset */
#define BMI3_GYR_OFF_GAIN_RESET_POS                  UINT8_C(1)

/******************************************************************************/
/*! BMI3 sensor data bytes */
/******************************************************************************/
#define BMI3_ACC_NUM_BYTES                           UINT8_C(20)
#define BMI3_GYR_NUM_BYTES                           UINT8_C(14)
#define BMI3_CRT_CONFIG_FILE_SIZE                    UINT16_C(2048)
#define BMI3_FEAT_SIZE_IN_BYTES                      UINT8_C(16)
#define BMI3_ACC_CONFIG_LENGTH                       UINT8_C(2)
#define BMI3_NUM_BYTES_I3C_SYNC_ACC                  UINT8_C(16)
#define BMI3_NUM_BYTES_I3C_SYNC_GYR                  UINT8_C(10)
#define BMI3_NUM_BYTES_I3C_SYNC_TEMP                 UINT8_C(4)

/******************************************************************************/
/*!        Accelerometer Macro Definitions               */
/******************************************************************************/
/*!  Accelerometer Bandwidth parameters */
#define BMI3_ACC_AVG1                                UINT8_C(0x00)
#define BMI3_ACC_AVG2                                UINT8_C(0x01)
#define BMI3_ACC_AVG4                                UINT8_C(0x02)
#define BMI3_ACC_AVG8                                UINT8_C(0x03)
#define BMI3_ACC_AVG16                               UINT8_C(0x04)
#define BMI3_ACC_AVG32                               UINT8_C(0x05)
#define BMI3_ACC_AVG64                               UINT8_C(0x06)

/*! Accelerometer Output Data Rate */
#define BMI3_ACC_ODR_0_78HZ                          UINT8_C(0x01)
#define BMI3_ACC_ODR_1_56HZ                          UINT8_C(0x02)
#define BMI3_ACC_ODR_3_125HZ                         UINT8_C(0x03)
#define BMI3_ACC_ODR_6_25HZ                          UINT8_C(0x04)
#define BMI3_ACC_ODR_12_5HZ                          UINT8_C(0x05)
#define BMI3_ACC_ODR_25HZ                            UINT8_C(0x06)
#define BMI3_ACC_ODR_50HZ                            UINT8_C(0x07)
#define BMI3_ACC_ODR_100HZ                           UINT8_C(0x08)
#define BMI3_ACC_ODR_200HZ                           UINT8_C(0x09)
#define BMI3_ACC_ODR_400HZ                           UINT8_C(0x0A)
#define BMI3_ACC_ODR_800HZ                           UINT8_C(0x0B)
#define BMI3_ACC_ODR_1600HZ                          UINT8_C(0x0C)
#define BMI3_ACC_ODR_3200HZ                          UINT8_C(0x0D)
#define BMI3_ACC_ODR_6400HZ                          UINT8_C(0x0E)

/*! Accelerometer G Range */
#define BMI3_ACC_RANGE_2G                            UINT8_C(0x00)
#define BMI3_ACC_RANGE_4G                            UINT8_C(0x01)
#define BMI3_ACC_RANGE_8G                            UINT8_C(0x02)
#define BMI3_ACC_RANGE_16G                           UINT8_C(0x03)

/*! Accelerometer mode */
#define BMI3_ACC_MODE_DISABLE                        UINT8_C(0x00)
#define BMI3_ACC_MODE_LOW_PWR                        UINT8_C(0x03)
#define BMI3_ACC_MODE_NORMAL                         UINT8_C(0X04)
#define BMI3_ACC_MODE_HIGH_PERF                      UINT8_C(0x07)

/*! Accelerometer bandwidth */
#define BMI3_ACC_BW_ODR_HALF                         UINT8_C(0)
#define BMI3_ACC_BW_ODR_QUARTER                      UINT8_C(1)

/******************************************************************************/
/*!       Gyroscope Macro Definitions               */
/******************************************************************************/
/*!  Gyroscope Bandwidth parameters */
#define BMI3_GYR_AVG1                                UINT8_C(0x00)
#define BMI3_GYR_AVG2                                UINT8_C(0x01)
#define BMI3_GYR_AVG4                                UINT8_C(0x02)
#define BMI3_GYR_AVG8                                UINT8_C(0x03)
#define BMI3_GYR_AVG16                               UINT8_C(0x04)
#define BMI3_GYR_AVG32                               UINT8_C(0x05)
#define BMI3_GYR_AVG64                               UINT8_C(0x06)

/*! Gyroscope Output Data Rate */
#define BMI3_GYR_ODR_0_78HZ                          UINT8_C(0x01)
#define BMI3_GYR_ODR_1_56HZ                          UINT8_C(0x02)
#define BMI3_GYR_ODR_3_125HZ                         UINT8_C(0x03)
#define BMI3_GYR_ODR_6_25HZ                          UINT8_C(0x04)
#define BMI3_GYR_ODR_12_5HZ                          UINT8_C(0x05)
#define BMI3_GYR_ODR_25HZ                            UINT8_C(0x06)
#define BMI3_GYR_ODR_50HZ                            UINT8_C(0x07)
#define BMI3_GYR_ODR_100HZ                           UINT8_C(0x08)
#define BMI3_GYR_ODR_200HZ                           UINT8_C(0x09)
#define BMI3_GYR_ODR_400HZ                           UINT8_C(0x0A)
#define BMI3_GYR_ODR_800HZ                           UINT8_C(0x0B)
#define BMI3_GYR_ODR_1600HZ                          UINT8_C(0x0C)
#define BMI3_GYR_ODR_3200HZ                          UINT8_C(0x0D)
#define BMI3_GYR_ODR_6400HZ                          UINT8_C(0x0E)

/*! Gyroscope DPS Range */
#define BMI3_GYR_RANGE_125DPS                        UINT8_C(0x00)
#define BMI3_GYR_RANGE_250DPS                        UINT8_C(0x01)
#define BMI3_GYR_RANGE_500DPS                        UINT8_C(0x02)
#define BMI3_GYR_RANGE_1000DPS                       UINT8_C(0x03)
#define BMI3_GYR_RANGE_2000DPS                       UINT8_C(0x04)

/*! Gyroscope mode */
#define BMI3_GYR_MODE_DISABLE                        UINT8_C(0x00)
#define BMI3_GYR_MODE_SUSPEND                        UINT8_C(0X01)
#define BMI3_GYR_MODE_LOW_PWR                        UINT8_C(0x03)
#define BMI3_GYR_MODE_NORMAL                         UINT8_C(0X04)
#define BMI3_GYR_MODE_HIGH_PERF                      UINT8_C(0x07)

/*! Gyroscope bandwidth */
#define BMI3_GYR_BW_ODR_HALF                         UINT8_C(0)
#define BMI3_GYR_BW_ODR_QUARTER                      UINT8_C(1)

/******************************************************************************/
/*!        Alternate Accelerometer Macro Definitions               */
/******************************************************************************/
/*!  Alternate Accelerometer Bandwidth parameters */
#define BMI3_ALT_ACC_AVG1                            UINT8_C(0x00)
#define BMI3_ALT_ACC_AVG2                            UINT8_C(0x01)
#define BMI3_ALT_ACC_AVG4                            UINT8_C(0x02)
#define BMI3_ALT_ACC_AVG8                            UINT8_C(0x03)
#define BMI3_ALT_ACC_AVG16                           UINT8_C(0x04)
#define BMI3_ALT_ACC_AVG32                           UINT8_C(0x05)
#define BMI3_ALT_ACC_AVG64                           UINT8_C(0x06)

/*! Alternate Accelerometer Output Data Rate */
#define BMI3_ALT_ACC_ODR_0_78HZ                      UINT8_C(0x01)
#define BMI3_ALT_ACC_ODR_1_56HZ                      UINT8_C(0x02)
#define BMI3_ALT_ACC_ODR_3_125HZ                     UINT8_C(0x03)
#define BMI3_ALT_ACC_ODR_6_25HZ                      UINT8_C(0x04)
#define BMI3_ALT_ACC_ODR_12_5HZ                      UINT8_C(0x05)
#define BMI3_ALT_ACC_ODR_25HZ                        UINT8_C(0x06)
#define BMI3_ALT_ACC_ODR_50HZ                        UINT8_C(0x07)
#define BMI3_ALT_ACC_ODR_100HZ                       UINT8_C(0x08)
#define BMI3_ALT_ACC_ODR_200HZ                       UINT8_C(0x09)
#define BMI3_ALT_ACC_ODR_400HZ                       UINT8_C(0x0A)
#define BMI3_ALT_ACC_ODR_800HZ                       UINT8_C(0x0B)
#define BMI3_ALT_ACC_ODR_1600HZ                      UINT8_C(0x0C)
#define BMI3_ALT_ACC_ODR_3200HZ                      UINT8_C(0x0D)
#define BMI3_ALT_ACC_ODR_6400HZ                      UINT8_C(0x0E)

/*! Alternate Accelerometer mode */
#define BMI3_ALT_ACC_MODE_DISABLE                    UINT8_C(0x00)
#define BMI3_ALT_ACC_MODE_LOW_PWR                    UINT8_C(0x03)
#define BMI3_ALT_ACC_MODE_NORMAL                     UINT8_C(0X04)
#define BMI3_ALT_ACC_MODE_HIGH_PERF                  UINT8_C(0x07)

/******************************************************************************/
/*!      Alternate Gyroscope Macro Definitions               */
/******************************************************************************/
/*!  Alternate Gyroscope Bandwidth parameters */
#define BMI3_ALT_GYR_AVG1                            UINT8_C(0x00)
#define BMI3_ALT_GYR_AVG2                            UINT8_C(0x01)
#define BMI3_ALT_GYR_AVG4                            UINT8_C(0x02)
#define BMI3_ALT_GYR_AVG8                            UINT8_C(0x03)
#define BMI3_ALT_GYR_AVG16                           UINT8_C(0x04)
#define BMI3_ALT_GYR_AVG32                           UINT8_C(0x05)
#define BMI3_ALT_GYR_AVG64                           UINT8_C(0x06)

/*! Alternate Gyroscope Output Data Rate */
#define BMI3_ALT_GYR_ODR_0_78HZ                      UINT8_C(0x01)
#define BMI3_ALT_GYR_ODR_1_56HZ                      UINT8_C(0x02)
#define BMI3_ALT_GYR_ODR_3_125HZ                     UINT8_C(0x03)
#define BMI3_ALT_GYR_ODR_6_25HZ                      UINT8_C(0x04)
#define BMI3_ALT_GYR_ODR_12_5HZ                      UINT8_C(0x05)
#define BMI3_ALT_GYR_ODR_25HZ                        UINT8_C(0x06)
#define BMI3_ALT_GYR_ODR_50HZ                        UINT8_C(0x07)
#define BMI3_ALT_GYR_ODR_100HZ                       UINT8_C(0x08)
#define BMI3_ALT_GYR_ODR_200HZ                       UINT8_C(0x09)
#define BMI3_ALT_GYR_ODR_400HZ                       UINT8_C(0x0A)
#define BMI3_ALT_GYR_ODR_800HZ                       UINT8_C(0x0B)
#define BMI3_ALT_GYR_ODR_1600HZ                      UINT8_C(0x0C)
#define BMI3_ALT_GYR_ODR_3200HZ                      UINT8_C(0x0D)
#define BMI3_ALT_GYR_ODR_6400HZ                      UINT8_C(0x0E)

/*! Alternate Gyroscope mode */
#define BMI3_ALT_GYR_MODE_DISABLE                    UINT8_C(0x00)
#define BMI3_ALT_GYR_MODE_SUSPEND                    UINT8_C(0X01)
#define BMI3_ALT_GYR_MODE_LOW_PWR                    UINT8_C(0x03)
#define BMI3_ALT_GYR_MODE_NORMAL                     UINT8_C(0X04)
#define BMI3_ALT_GYR_MODE_HIGH_PERF                  UINT8_C(0x07)

/******************************************************************************/
/*!       I3C Macro Definitions               */
/******************************************************************************/

/*! I3C sync ODR */
#define BMI3_I3C_SYNC_ODR_6_25HZ                     UINT8_C(0x04)
#define BMI3_I3C_SYNC_ODR_12_5HZ                     UINT8_C(0x05)
#define BMI3_I3C_SYNC_ODR_25HZ                       UINT8_C(0x06)
#define BMI3_I3C_SYNC_ODR_50HZ                       UINT8_C(0x07)
#define BMI3_I3C_SYNC_ODR_100HZ                      UINT8_C(0x08)
#define BMI3_I3C_SYNC_ODR_200HZ                      UINT8_C(0x09)
#define BMI3_I3C_SYNC_ODR_400HZ                      UINT8_C(0x0A)
#define BMI3_I3C_SYNC_ODR_800HZ                      UINT8_C(0x0B)

/*! I3C sync division factor */
#define BMI3_I3C_SYNC_DIVISION_FACTOR_11             UINT8_C(0)
#define BMI3_I3C_SYNC_DIVISION_FACTOR_12             UINT8_C(1)
#define BMI3_I3C_SYNC_DIVISION_FACTOR_13             UINT8_C(2)
#define BMI3_I3C_SYNC_DIVISION_FACTOR_14             UINT8_C(3)

/******************************************************************************/
/*!       Feature interrupts base address definitions               */
/******************************************************************************/

#define BMI3_BASE_ADDR_CONFIG_VERSION                UINT8_C(0x00)
#define BMI3_BASE_ADDR_AXIS_REMAP                    UINT8_C(0x03)
#define BMI3_BASE_ADDR_ANY_MOTION                    UINT8_C(0x05)
#define BMI3_BASE_ADDR_NO_MOTION                     UINT8_C(0x08)
#define BMI3_BASE_ADDR_FLAT                          UINT8_C(0x0B)
#define BMI3_BASE_ADDR_SIG_MOTION                    UINT8_C(0x0D)
#define BMI3_BASE_ADDR_STEP_CNT                      UINT8_C(0x10)
#define BMI3_BASE_ADDR_ORIENT                        UINT8_C(0x1C)
#define BMI3_BASE_ADDR_TAP                           UINT8_C(0x1E)
#define BMI3_BASE_ADDR_TILT                          UINT8_C(0x21)
#define BMI3_BASE_ADDR_ALT_AUTO_CONFIG               UINT8_C(0X23)
#define BMI3_BASE_ADDR_ST_RESULT                     UINT8_C(0x24)
#define BMI3_BASE_ADDR_ST_SELECT                     UINT8_C(0x25)
#define BMI3_BASE_ADDR_GYRO_SC_SELECT                UINT8_C(0x26)
#define BMI3_BASE_ADDR_GYRO_SC_ST_CONF               UINT8_C(0x27)
#define BMI3_BASE_ADDR_GYRO_SC_ST_COEFFICIENTS       UINT8_C(0x28)
#define BMI3_BASE_ADDR_I3C_SYNC                      UINT8_C(0x36)
#define BMI3_BASE_ADDR_I3C_SYNC_ACC                  UINT8_C(0x37)
#define BMI3_BASE_ADDR_I3C_SYNC_GYR                  UINT8_C(0x3A)
#define BMI3_BASE_ADDR_I3C_SYNC_TEMP                 UINT8_C(0x3D)
#define BMI3_BASE_ADDR_I3C_SYNC_TIME                 UINT8_C(0x3E)
#define BMI3_BASE_ADDR_ACC_GYR_OFFSET_GAIN_RESET     UINT8_C(0x3F)
#define BMI3_BASE_ADDR_ACC_OFFSET_GAIN               UINT8_C(0x40)
#define BMI3_BASE_ADDR_GYRO_OFFSET_GAIN              UINT8_C(0x46)

/******************************************************************************/
/*! @name BMI3 Interrupt Modes */
/******************************************************************************/
/*! Non latched */
#define BMI3_INT_NON_LATCH                           UINT8_C(0)

#define BMI3_INT_LATCH_EN                            UINT8_C(1)
#define BMI3_INT_LATCH_DISABLE                       UINT8_C(0)

/*! BMI3 Interrupt Pin Behavior */
#define BMI3_INT_PUSH_PULL                           UINT8_C(0)
#define BMI3_INT_OPEN_DRAIN                          UINT8_C(1)

/*! BMI3 Interrupt Pin Level */
#define BMI3_INT_ACTIVE_LOW                          UINT8_C(0)
#define BMI3_INT_ACTIVE_HIGH                         UINT8_C(1)

/*! BMI3 Interrupt Output Enable */
#define BMI3_INT_OUTPUT_DISABLE                      UINT8_C(0)
#define BMI3_INT_OUTPUT_ENABLE                       UINT8_C(1)

/*! Orientation output macros */
#define BMI3_FACE_UP                                 UINT8_C(0x00)
#define BMI3_FACE_DOWN                               UINT8_C(0x01)

#define BMI3_PORTRAIT_UP_RIGHT                       UINT8_C(0x00)
#define BMI3_LANDSCAPE_LEFT                          UINT8_C(0x01)
#define BMI3_PORTRAIT_UP_DOWN                        UINT8_C(0x02)
#define BMI3_LANDSCAPE_RIGHT                         UINT8_C(0x03)

/******************************************************************************/
/*! @name       FIFO Macro Definitions                                        */
/******************************************************************************/

/*! Mask definitions for FIFO frame content configuration */
#define BMI3_FIFO_STOP_ON_FULL                       UINT16_C(0x0001)
#define BMI3_FIFO_TIME_EN                            UINT16_C(0x0100)
#define BMI3_FIFO_ACC_EN                             UINT16_C(0x0200)
#define BMI3_FIFO_GYR_EN                             UINT16_C(0x0400)
#define BMI3_FIFO_TEMP_EN                            UINT16_C(0x0800)
#define BMI3_FIFO_ALL_EN                             UINT16_C(0x0F00)

/*! FIFO sensor data lengths */
#define BMI3_LENGTH_FIFO_ACC                         UINT8_C(6)
#define BMI3_LENGTH_FIFO_GYR                         UINT8_C(6)
#define BMI3_LENGTH_TEMPERATURE                      UINT8_C(2)
#define BMI3_LENGTH_SENSOR_TIME                      UINT8_C(2)
#define BMI3_LENGTH_FIFO_CONFIG                      UINT8_C(2)
#define BMI3_LENGTH_FIFO_WM                          UINT8_C(2)
#define BMI3_LENGTH_MAX_FIFO_FILTER                  UINT8_C(1)
#define BMI3_LENGTH_FIFO_DATA                        UINT8_C(2)
#define BMI3_LENGTH_FIFO_MSB_BYTE                    UINT8_C(1)

/*! BMI3 Mask definitions of FIFO configuration registers */
#define BMI3_FIFO_CONFIG_MASK                        UINT16_C(0x0F01)

/*! BMI3 sensor selection for header-less frames  */
#define BMI3_FIFO_HEAD_LESS_ACC_FRM                  UINT16_C(0x0200)
#define BMI3_FIFO_HEAD_LESS_GYR_FRM                  UINT16_C(0x0400)
#define BMI3_FIFO_HEAD_LESS_SENS_TIME_FRM            UINT16_C(0x0100)
#define BMI3_FIFO_HEAD_LESS_TEMP_FRM                 UINT16_C(0x0800)
#define BMI3_FIFO_HEAD_LESS_ALL_FRM                  UINT16_C(0x0F00)

/******************************************************************************/
/*! @name       CFG RES Macro Definitions                                     */
/******************************************************************************/

#define BMI3_CFG_RES_VALUE_ONE                       UINT8_C(0x07)
#define BMI3_CFG_RES_MASK                            UINT8_C(0x80)

/******************************************************************************/
/*! @name       Alternate configuration macros                                */
/******************************************************************************/

/*! Enables switching possibility to alternate configuration for accel */
#define BMI3_ALT_ACC_ENABLE                          UINT8_C(0x01)

/*! Enables switching possibility to alternate configuration for gyro */
#define BMI3_ALT_GYR_ENABLE                          UINT8_C(0x10)

#define BMI3_ALT_CONF_ALT_SWITCH_MASK                UINT8_C(0x0F)

#define BMI3_ALT_CONF_USER_SWITCH_MASK               UINT8_C(0xF0)
#define BMI3_ALT_CONF_USER_SWITCH_POS                UINT8_C(4)

#define BMI3_ALT_CONF_RESET_ON                       UINT8_C(1)
#define BMI3_ALT_CONF_RESET_OFF                      UINT8_C(0)

#define BMI3_ALT_NO_MOTION                           UINT8_C(1)
#define BMI3_ALT_ANY_MOTION                          UINT8_C(2)
#define BMI3_ALT_FLAT                                UINT8_C(3)
#define BMI3_ALT_ORIENT                              UINT8_C(4)
#define BMI3_ALT_STEP_DETECTOR                       UINT8_C(5)
#define BMI3_ALT_STEP_COUNTER                        UINT8_C(6)
#define BMI3_ALT_SIG_MOTION                          UINT8_C(7)
#define BMI3_ALT_TILT                                UINT8_C(8)
#define BMI3_ALT_TAP                                 UINT8_C(9)

#define BMI3_ALT_ACCEL_STATUS_MASK                   UINT8_C(0x01)

#define BMI3_ALT_GYRO_STATUS_MASK                    UINT8_C(0x10)
#define BMI3_ALT_GYRO_STATUS_POS                     UINT8_C(4)

/******************************************************************************/
/*! @name       Status macros                                                 */
/******************************************************************************/
#define BMI3_STATUS_POR                              UINT8_C(0x01)
#define BMI3_STATUS_DRDY_TEMP                        UINT8_C(0x20)
#define BMI3_STATUS_DRDY_GYR                         UINT8_C(0x40)
#define BMI3_STATUS_DRDY_ACC                         UINT8_C(0x80)

/******************************************************************************/
/*! @name       FOC macros                                                    */
/******************************************************************************/

/* Reference value with positive and negative noise range in lsb */

/*
 * As per datasheet, Zero-g offset : +/- 50mg
 *
 * In range 2G,  1G is 16384. so, 16384 x 50 x (10 ^ -3) = 819
 * In range 4G,  1G is 8192.  so,  8192 x 50 x (10 ^ -3) = 410
 * In range 8G,  1G is 4096.  so,  4096 x 50 x (10 ^ -3) = 205
 * In range 16G, 1G is 2048.  so,  2048 x 50 x (10 ^ -3) = 102
 */
#define BMI3_ACC_FOC_2G_REF           UINT16_C(16384)
#define BMI3_ACC_FOC_4G_REF           UINT16_C(8192)
#define BMI3_ACC_FOC_8G_REF           UINT16_C(4096)
#define BMI3_ACC_FOC_16G_REF          UINT16_C(2048)

#define BMI3_ACC_FOC_2G_OFFSET        UINT16_C(819)
#define BMI3_ACC_FOC_4G_OFFSET        UINT16_C(410)
#define BMI3_ACC_FOC_8G_OFFSET        UINT16_C(205)
#define BMI3_ACC_FOC_16G_OFFSET       UINT16_C(102)

#define BMI3_FOC_SAMPLE_LIMIT         UINT8_C(128)

#define BMI3_ACC_2G_MAX_NOISE_LIMIT   (BMI3_ACC_FOC_2G_REF + BMI3_ACC_FOC_2G_OFFSET)
#define BMI3_ACC_2G_MIN_NOISE_LIMIT   (BMI3_ACC_FOC_2G_REF - BMI3_ACC_FOC_2G_OFFSET)
#define BMI3_ACC_4G_MAX_NOISE_LIMIT   (BMI3_ACC_FOC_4G_REF + BMI3_ACC_FOC_4G_OFFSET)
#define BMI3_ACC_4G_MIN_NOISE_LIMIT   (BMI3_ACC_FOC_4G_REF - BMI3_ACC_FOC_4G_OFFSET)
#define BMI3_ACC_8G_MAX_NOISE_LIMIT   (BMI3_ACC_FOC_8G_REF + BMI3_ACC_FOC_8G_OFFSET)
#define BMI3_ACC_8G_MIN_NOISE_LIMIT   (BMI3_ACC_FOC_8G_REF - BMI3_ACC_FOC_8G_OFFSET)
#define BMI3_ACC_16G_MAX_NOISE_LIMIT  (BMI3_ACC_FOC_16G_REF + BMI3_ACC_FOC_16G_OFFSET)
#define BMI3_ACC_16G_MIN_NOISE_LIMIT  (BMI3_ACC_FOC_16G_REF - BMI3_ACC_FOC_16G_OFFSET)

/*! Macro to define accelerometer configuration value for FOC */
#define BMI3_FOC_ACC_CONF_VAL_LSB     UINT8_C(0xB7)
#define BMI3_FOC_ACC_CONF_VAL_MSB     UINT8_C(0x40)

/*! Macro to define X Y and Z axis for an array */
#define BMI3_X_AXIS                   UINT8_C(0)
#define BMI3_Y_AXIS                   UINT8_C(1)
#define BMI3_Z_AXIS                   UINT8_C(2)

#define BMI3_FOC_INVERT_VALUE         INT8_C(-1)

/*! For defining absolute values */
#define BMI3_ABS(a)                   ((a) > 0 ? (a) : -(a))

/*! Sensortime resolution in seconds */
#define BMI3_SENSORTIME_RESOLUTION    0.0000390625f

/*! Maximum number of interrupt pins */
#define BMI3_INT_PIN_MAX_NUM          UINT8_C(2)

/*! Maximum available register length */
#define BMI3_MAX_LEN                  UINT8_C(128)

#define BMI3_ACC_2G                   UINT8_C(2)
#define BMI3_ACC_4G                   UINT8_C(4)
#define BMI3_ACC_8G                   UINT8_C(8)
#define BMI3_ACC_16G                  UINT8_C(16)

#define BMI3_ACC_2G_BIT_POS           UINT8_C(1)
#define BMI3_ACC_4G_BIT_POS           UINT8_C(2)
#define BMI3_ACC_8G_BIT_POS           UINT8_C(3)
#define BMI3_ACC_16G_BIT_POS          UINT8_C(4)

/******************************************************************************/
/*! @name       Gyro self-calibration/self-test coefficient macros  */
/******************************************************************************/
#define BMI3_SC_ST_VALUE_0            UINT16_C(0x5A2E)
#define BMI3_SC_ST_VALUE_1            UINT16_C(0x9219)
#define BMI3_SC_ST_VALUE_2            UINT16_C(0x5637)
#define BMI3_SC_ST_VALUE_3            UINT16_C(0xFFE8)
#define BMI3_SC_ST_VALUE_4            UINT16_C(0xFFEF)
#define BMI3_SC_ST_VALUE_5            UINT16_C(0x000D)
#define BMI3_SC_ST_VALUE_6            UINT16_C(0x07CA)
#define BMI3_SC_ST_VALUE_7            UINT16_C(0xFFCD)
#define BMI3_SC_ST_VALUE_8            UINT16_C(0xEF6C)

#define BMI3_SC_SENSITIVITY_EN        UINT8_C(1)
#define BMI3_SC_OFFSET_EN             UINT8_C(2)

/*! Self-calibration enable disable macros */
#define BMI3_SC_APPLY_CORR_DIS        UINT8_C(0)
#define BMI3_SC_APPLY_CORR_EN         UINT8_C(4)

/********************************************************* */
/*!               Function Pointers                       */
/********************************************************* */

/*!
 * @brief Bus communication function pointer which should be mapped to
 * the platform specific read functions of the user
 *
 * @param[in]     reg_addr : 8bit register address of the sensor
 * @param[out]    reg_data : Data from the specified address
 * @param[in]     length   : Length of the reg_data array
 * @param[in,out] intf_ptr : Void pointer that can enable the linking of descriptors
 *                           for interface related callbacks
 * @retval 0 for Success
 * @retval Non-zero for Failure
 */
typedef BMI3_INTF_RET_TYPE (*bmi3_read_fptr_t)(uint8_t reg_addr, uint8_t *reg_data, uint32_t length, void *intf_ptr);

/*!
 * @brief Bus communication function pointer which should be mapped to
 * the platform specific write functions of the user
 *
 * @param[in]     reg_addr : 8bit register address of the sensor
 * @param[in]     reg_data : Data to the specified address
 * @param[in]     length   : Length of the reg_data array
 * @param[in,out] intf_ptr : Void pointer that can enable the linking of descriptors
 *                           for interface related callbacks
 * @retval 0 for Success
 * @retval Non-zero for Failure
 *
 */
typedef BMI3_INTF_RET_TYPE (*bmi3_write_fptr_t)(uint8_t reg_addr, const uint8_t *reg_data, uint32_t length,
                                                void *intf_ptr);

/*!
 * @brief Delay function pointer which should be mapped to
 * delay function of the user
 *
 * @param[in] period       : The time period in microseconds
 * @param[in,out] intf_ptr : Void pointer that can enable the linking of descriptors
 *                           for interface related callbacks
 */
typedef void (*bmi3_delay_us_fptr_t)(uint32_t period, void *intf_ptr);

/********************************************************* */
/*!                  Enumerators                          */
/********************************************************* */

/*!
 * @name Enumerator describing interfaces
 */
enum bmi3_intf {
    /*! SPI interface */
    BMI3_SPI_INTF = 0,
    /*! I2C interface */
    BMI3_I2C_INTF,
    /*! I3C interface */
    BMI3_I3C_INTF
};

/*!
 * @name Enum to define interrupt lines
 */
enum bmi3_hw_int_pin {
    BMI3_INT_NONE,
    BMI3_INT1,
    BMI3_INT2,
    BMI3_I3C_INT,
    BMI3_INT_PIN_MAX
};

/********************************************************* */
/*!                      Structures                       */
/********************************************************* */

/*!
 * @brief Structure to store the local copy of the re-mapped axis and
 * the value of its sign for register settings
 */
struct bmi3_axes_remap
{
    /*! Re-map x, y and z axis */
    uint8_t axis_map;

    /*! Re-mapped x-axis sign */
    uint8_t invert_x;

    /*! Re-mapped y-axis sign */
    uint8_t invert_y;

    /*! Re-mapped z-axis sign */
    uint8_t invert_z;
};

/*!
 * @brief Structure to define FIFO frame configuration
 */
struct bmi3_fifo_frame
{
    /*! Pointer to FIFO data */
    uint8_t *data;

    /*! Number of user defined bytes of FIFO to be read */
    uint16_t length;

    /*! Enables type of data to be streamed - accelerometer,
     *  gyroscope and temperature
     */
    uint16_t available_fifo_sens;

    /*! Water-mark level for water-mark interrupt */
    uint16_t wm_lvl;

    /*! Available fifo length in words */
    uint16_t available_fifo_len;

    /*! To store available fifo accel frames */
    uint16_t avail_fifo_accel_frames;

    /*! Available fifo sensor time frames */
    uint8_t avail_fifo_sens_time_frames;

    /*! To store available fifo gyro frames */
    uint16_t avail_fifo_gyro_frames;

    /*! To store available fifo temperature frames */
    uint16_t avail_fifo_temp_frames;
};

/*!
 * @brief Primary device structure
 */
struct bmi3_dev
{
    /*! Chip id of BMI3 */
    uint8_t chip_id;

    /*!
     * The interface pointer is used to enable the user
     * to link their interface descriptors for reference during the
     * implementation of the read and write interfaces to the
     * hardware.
     */
    void *intf_ptr;

    /*!
     * To store information during boundary check conditions
     * If minimum value is stored, update info with BMI3_I_MIN_VALUE
     * If maximum value is stored, update info with BMI3_I_MAX_VALUE
     */
    uint8_t info;

    /*! Type of Interface  */
    enum bmi3_intf intf;

    /*! To store interface pointer error */
    BMI3_INTF_RET_TYPE intf_rslt;

    /*! For switching from I2C to SPI */
    uint8_t dummy_byte;

    /*! Resolution for FOC */
    uint8_t resolution;

    /*! User set read/write length */
    uint16_t read_write_len;

    /*! Read function pointer */
    bmi3_read_fptr_t read;

    /*! Write function pointer */
    bmi3_write_fptr_t write;

    /*! Delay function pointer */
    bmi3_delay_us_fptr_t delay_us;

    /*! Accel bit width */
    uint16_t accel_bit_width;
};

/*!
 * @brief Structure to define Interrupt pin configuration
 */
struct bmi3_int_pin_cfg
{
    /*! Configure level of interrupt pin */
    uint8_t lvl;

    /*! Configure behavior of interrupt pin */
    uint8_t od;

    /*! Output enable for interrupt pin */
    uint8_t output_en;
};

/*!
 * @brief Structure to define interrupt pin type, mode and configurations
 */
struct bmi3_int_pin_config
{
    /*! Interrupt pin type: INT1 or INT2 or BOTH */
    uint8_t pin_type;

    /*! Latched or non-latched mode */
    uint8_t int_latch;

    /*! Structure to define Interrupt pin configuration */
    struct bmi3_int_pin_cfg pin_cfg[BMI3_INT_PIN_MAX_NUM];
};

/*!
 * @brief Structure to define accelerometer and gyroscope sensor axes and
 * sensor time for virtual frames
 */
struct bmi3_sens_axes_data
{
    /*! Data in x-axis */
    int16_t x;

    /*! Data in y-axis */
    int16_t y;

    /*! Data in z-axis */
    int16_t z;

    /*! Sensor time for frames */
    uint32_t sens_time;

    /*! Saturation flag status for X axis */
    uint8_t sat_x : 1;

    /*! Saturation flag status for Y axis */
    uint8_t sat_y : 1;

    /*! Saturation flag status for Z axis */
    uint8_t sat_z : 1;
};

/*!
 * @brief Structure to define accelerometer and gyroscope sensor axes and
 * sensor time for virtual frames
 */
struct bmi3_i3c_sync_data
{
    /*! Data in x-axis */
    uint16_t sync_x;

    /*! Data in y-axis */
    uint16_t sync_y;

    /*! Data in z-axis */
    uint16_t sync_z;

    /*! Temperature data */
    uint16_t sync_temp;

    /*! Sensor time for frames */
    uint16_t sync_time;
};

/*!
 * @brief Structure to define FIFO accel, gyro x, y and z axis and
 * sensor time
 */
struct bmi3_fifo_sens_axes_data
{
    /*! Data in x-axis */
    int16_t x;

    /*! Data in y-axis */
    int16_t y;

    /*! Data in z-axis */
    int16_t z;

    /*! Sensor time data */
    uint16_t sensor_time;
};

/*!
 * @brief Structure to define FIFO temperature and sensor time
 */
struct bmi3_fifo_temperature_data
{
    /*! Temperature data */
    uint16_t temp_data;

    /*! Sensor time data */
    uint16_t sensor_time;
};

/*!
 * @brief Structure to define orientation output
 */
struct bmi3_orientation_output
{
    /*! Orientation portrait landscape */
    uint8_t orientation_portrait_landscape;

    /*! Orientation face-up down  */
    uint8_t orientation_faceup_down;
};

/*!
 * @brief Structure to define gyroscope saturation status of user gain
 */
struct bmi3_gyr_user_gain_status
{
    /*! Status in x-axis */
    uint8_t sat_x;

    /*! Status in y-axis */
    uint8_t sat_y;

    /*! Status in z-axis */
    uint8_t sat_z;

    /*! G trigger status */
    uint8_t g_trigger_status;
};

/*!
 * @brief Structure to define accelerometer and gyroscope self test feature status
 */
struct bmi3_st_result
{
    /*! Self test completed */
    uint8_t self_test_rslt;

    /*! Bit is set to 1 when accelerometer X-axis test passed */
    uint8_t acc_sens_x_ok;

    /*! Bit is set to 1 when accelerometer y-axis test passed */
    uint8_t acc_sens_y_ok;

    /*! Bit is set to 1 when accelerometer z-axis test passed */
    uint8_t acc_sens_z_ok;

    /*! Bit is set to 1 when gyroscope X-axis test passed */
    uint8_t gyr_sens_x_ok;

    /*! Bit is set to 1 when gyroscope y-axis test passed */
    uint8_t gyr_sens_y_ok;

    /*! Bit is set to 1 when gyroscope z-axis test passed */
    uint8_t gyr_sens_z_ok;

    /*! Bit is set to 1 when gyroscope drive test passed */
    uint8_t gyr_drive_ok;

    /*! Stores the self-test error code result */
    uint8_t self_test_err_rslt;
};

/*!
 * @brief Union to define BMI3 sensor data
 */
union bmi3_sens_data
{
    /*! Accelerometer axes data */
    struct bmi3_sens_axes_data acc;

    /*! Gyroscope axes data */
    struct bmi3_sens_axes_data gyr;

    /*! Step counter output */
    uint32_t step_counter_output;

    /*! Orientation output */
    struct bmi3_orientation_output orient_output;

    /*! Gyroscope user gain saturation status */
    struct bmi3_gyr_user_gain_status gyro_user_gain_status;

    /*! I3C sync data */
    struct bmi3_i3c_sync_data i3c_sync;
};

/*!
 * @brief Structure to define type of sensor and their respective data
 */
struct bmi3_sensor_data
{
    /*! Defines the type of sensor */
    uint8_t type;

    /*! Defines various sensor data */
    union bmi3_sens_data sens_data;
};

/*!
 * @brief Structure to define accelerometer configuration
 */
struct bmi3_accel_config
{
    /*! Output data rate in Hz */
    uint8_t odr;

    /*! Bandwidth parameter */
    uint8_t bwp;

    /*! Filter accel mode */
    uint8_t acc_mode;

    /*! Gravity range */
    uint8_t range;

    /*! Defines the number of samples to be averaged */
    uint8_t avg_num;
};

/*!
 * @brief Structure to define gyroscope configuration
 */
struct bmi3_gyro_config
{
    /*! Output data rate in Hz */
    uint8_t odr;

    /*! Bandwidth parameter */
    uint8_t bwp;

    /*! Filter gyro mode */
    uint8_t gyr_mode;

    /*! Gyroscope Range */
    uint8_t range;

    /*! Defines the number of samples to be averaged */
    uint8_t avg_num;
};

/*!
 * @brief Structure to define any-motion configuration
 */
struct bmi3_any_motion_config
{
    /*! Duration in 50Hz samples(20msec) */
    uint16_t duration;

    /*! Acceleration slope threshold */
    uint16_t slope_thres;

    /*! Mode of accel reference update */
    uint8_t acc_ref_up;

    /*! Hysteresis for the slope of the acceleration signal */
    uint16_t hysteresis;

    /*! Wait time for clearing the event after slope is below threshold */
    uint16_t wait_time;
};

/*!
 * @brief Structure to define no-motion configuration
 */
struct bmi3_no_motion_config
{
    /*! Duration in 50Hz samples(20msec) */
    uint16_t duration;

    /*! Acceleration slope threshold */
    uint16_t slope_thres;

    /*! Mode of accel reference update */
    uint8_t acc_ref_up;

    /*! Hysteresis for the slope of the acceleration signal */
    uint16_t hysteresis;

    /*! Wait time for clearing the event after slope is below threshold */
    uint16_t wait_time;
};

/*!
 * @brief Structure to define sig-motion configuration
 */
struct bmi3_sig_motion_config
{
    /*! Block size */
    uint16_t block_size;

    /*! Minimum value of the peak to peak acceleration magnitude */
    uint16_t peak_2_peak_min;

    /*! Minimum number of mean crossing per second in acceleration magnitude */
    uint8_t mcr_min;

    /*! Maximum value of the peak to peak acceleration magnitude */
    uint16_t peak_2_peak_max;

    /*! MAximum number of mean crossing per second in acceleration magnitude */
    uint8_t mcr_max;
};

/*!
 * @brief Structure to define step counter configuration
 */
struct bmi3_step_counter_config
{
    /*! Water-mark level */
    uint16_t watermark_level;

    /*! Reset counter */
    uint16_t reset_counter;

    /*! Step Counter param 1 */
    uint16_t env_min_dist_up;

    /*! Step Counter param 2 */
    uint16_t env_coef_up;

    /*! Step Counter param 3 */
    uint16_t env_min_dist_down;

    /*! Step Counter param 4 */
    uint16_t env_coef_down;

    /*! Step Counter param 5 */
    uint16_t mean_val_decay;

    /*! Step Counter param 6 */
    uint16_t mean_step_dur;

    /*! Step Counter param 7 */
    uint16_t step_buffer_size;

    /*! Step Counter param 8 */
    uint16_t filter_cascade_enabled;

    /*! Step Counter param 9 */
    uint16_t step_counter_increment;

    /*! Step Counter param 10 */
    uint16_t peak_duration_min_walking;

    /*! Step Counter param 11 */
    uint16_t peak_duration_min_running;

    /*! Step Counter param 12 */
    uint16_t activity_detection_factor;

    /*! Step Counter param 13 */
    uint16_t activity_detection_thres;

    /*! Step Counter param 14 */
    uint16_t step_duration_max;

    /*! Step Counter param 15 */
    uint16_t step_duration_window;

    /*! Step Counter param 16 */
    uint16_t step_duration_pp_enabled;

    /*! Step Counter param 17 */
    uint16_t step_duration_thres;

    /*! Step Counter param 18 */
    uint16_t mean_crossing_pp_enabled;

    /*! Step Counter param 19 */
    uint16_t mcr_threshold;

    /*! Step Counter param 20 */
    uint16_t sc_12_res;
};

/*!
 * @brief Structure to define gyroscope user gain configuration
 */
struct bmi3_gyro_user_gain_config
{
    /*! Gain update value for x-axis */
    uint16_t ratio_x;

    /*! Gain update value for y-axis */
    uint16_t ratio_y;

    /*! Gain update value for z-axis */
    uint16_t ratio_z;
};

/*!
 * @brief Structure to define tilt configuration
 */
struct bmi3_tilt_config
{
    /*! Duration for which the acceleration vector is averaged to be reference vector */
    uint16_t segment_size;

    /*! Minimum tilt angle */
    uint16_t min_tilt_angle;

    /*! Mean of acceleration vector */
    uint16_t beta_acc_mean;
};

/*!
 * @brief Structure to define orientation configuration
 */
struct bmi3_orientation_config
{
    /*! Upside/down detection */
    uint8_t ud_en;

    /*! Symmetrical, high or low Symmetrical */
    uint8_t mode;

    /*! Blocking mode */
    uint8_t blocking;

    /*! Threshold angle */
    uint8_t theta;

    /*! Hold time of device */
    uint8_t hold_time;

    /*! Acceleration hysteresis for orientation detection */
    uint8_t hysteresis;

    /*! Slope threshold */
    uint8_t slope_thres;
};

/*!
 * @brief Structure to define flat configuration
 */
struct bmi3_flat_config
{
    /*! Theta angle for flat detection */
    uint16_t theta;

    /*! Blocking mode */
    uint16_t blocking;

    /*! Hysteresis for theta flat detection */
    uint16_t hysteresis;

    /*! Holds the duration in 50Hz samples(20msec) */
    uint16_t hold_time;

    /*! Minimum slope between consecutive acceleration samples to pervent the
     * change of flat status during large movement */
    uint16_t slope_thres;
};

/*!
 * @brief Structure to define tap configuration
 */
struct bmi3_tap_detector_config
{
    /*! Axis selection */
    uint8_t axis_sel;

    /*! Wait time */
    uint8_t wait_for_timeout;

    /*! Maximum number of zero crossing expected around a tap */
    uint8_t max_peaks_for_tap;

    /*! Mode for detection of tap gesture */
    uint8_t mode;

    /*! Minimum threshold for peak resulting from the tap */
    uint16_t tap_peak_thres;

    /*! Maximum duration between each taps */
    uint8_t max_gest_dur;

    /*! Maximum duration between positive and negative peaks to tap */
    uint8_t max_dur_between_peaks;

    /*! Maximum duration for which tap impact is observed */
    uint8_t tap_shock_settling_dur;

    /*! Minimum duration between two tap impact */
    uint8_t min_quite_dur_between_taps;

    /*! Minimum quite time between the two gesture detection */
    uint8_t quite_time_after_gest;
};

/*!
 * @brief Structure to define alternate accel configuration
 */
struct bmi3_alt_accel_config
{
    /*! ODR in Hz */
    uint8_t alt_acc_odr;

    /*! Filter accel mode */
    uint8_t alt_acc_mode;

    /*! Defines the number of samples to be averaged */
    uint8_t alt_acc_avg_num;
};

/*!
 * @brief Structure to define alternate gyro configuration
 */
struct bmi3_alt_gyro_config
{
    /*! ODR in Hz */
    uint8_t alt_gyro_odr;

    /*! Filter gyro mode */
    uint8_t alt_gyro_mode;

    /*! Defines the number of samples to be averaged */
    uint8_t alt_gyro_avg_num;
};

/*!
 * @brief Structure to define alternate auto configuration
 */
struct bmi3_auto_config_change
{
    /*! Mode to set features on alternate configurations */
    uint8_t alt_conf_alt_switch_src_select;

    /*! Mode to switch from alternate configurations to user configurations */
    uint8_t alt_conf_user_switch_src_select;
};

/*!
 * @brief Union to define the sensor configurations
 */
union bmi3_sens_config_types
{
    /*! Accelerometer configuration */
    struct bmi3_accel_config acc;

    /*! Gyroscope configuration */
    struct bmi3_gyro_config gyr;

    /*! Any-motion configuration */
    struct bmi3_any_motion_config any_motion;

    /*! No-motion configuration */
    struct bmi3_no_motion_config no_motion;

    /*! Sig_motion configuration */
    struct bmi3_sig_motion_config sig_motion;

    /*! Step counter configuration */
    struct bmi3_step_counter_config step_counter;

    /*! Gyroscope user gain configuration */
    struct bmi3_gyro_user_gain_config gyro_gain_update;

    /*! Tilt configuration */
    struct bmi3_tilt_config tilt;

    /*! Orientation configuration */
    struct bmi3_orientation_config orientation;

    /*! Flat configuration */
    struct bmi3_flat_config flat;

    /*! Tap configuration */
    struct bmi3_tap_detector_config tap;

    /*! Alternate accelerometer configuration */
    struct bmi3_alt_accel_config alt_acc;

    /*! Alternate gyroscope configuration */
    struct bmi3_alt_gyro_config alt_gyr;

    /*! Alternate auto configuration */
    struct bmi3_auto_config_change alt_auto_cfg;
};

/*!
 * @brief Structure to define the type of the sensor and its configurations
 */
struct bmi3_sens_config
{
    /*! Defines the type of sensor */
    uint8_t type;

    /*! Defines various sensor configurations */
    union bmi3_sens_config_types cfg;
};

/*!
 * @brief Error Status structure
 */
struct bmi3_err_reg
{
    /*! Indicates fatal error */
    uint8_t fatal_err;

    /*! Overload of the feature engine detected. */
    uint8_t feat_eng_ovrld;

    /*! Watchdog timer of the feature engine triggered. */
    uint8_t feat_eng_wd;

    /*! Indicates accel configuration error */
    uint8_t acc_conf_err;

    /*! Indicates gyro configuration error */
    uint8_t gyr_conf_err;

    /*! Indicates SDR parity error */
    uint8_t i3c_error0;

    /*! Indicates I3C error */
    uint8_t i3c_error3;
};

/*!
 * @brief Structure to store feature enable
 */
struct bmi3_feature_enable
{
    /*! Enables no-motion feature for X-axis */
    uint8_t no_motion_x_en;

    /*! Enables no-motion feature for Y-axis */
    uint8_t no_motion_y_en;

    /*! Enables no-motion feature for Z-axis */
    uint8_t no_motion_z_en;

    /*! Enables any-motion feature for X-axis */
    uint8_t any_motion_x_en;

    /*! Enables any-motion feature for Y-axis */
    uint8_t any_motion_y_en;

    /*! Enables any-motion feature for Z-axis */
    uint8_t any_motion_z_en;

    /*! Enables flat feature */
    uint8_t flat_en;

    /*! Enables orientation feature */
    uint8_t orientation_en;

    /*! Enables step detector feature */
    uint8_t step_detector_en;

    /*! Enables step counter feature */
    uint8_t step_counter_en;

    /*! Enables significant motion feature */
    uint8_t sig_motion_en;

    /*! Enables tilt feature */
    uint8_t tilt_en;

    /*! Enables single tap feature */
    uint8_t tap_detector_s_tap_en;

    /*! Enables double tap feature */
    uint8_t tap_detector_d_tap_en;

    /*! Enables triple tap feature */
    uint8_t tap_detector_t_tap_en;

    /*! Enables I3C TC-sync feature */
    uint8_t i3c_sync_en;
};

/*!
 * @brief Structure to map interrupt
 */
struct bmi3_map_int
{
    /*! Map interrupt output to either INT1 or INT2 or IBI
     *  Value   Name        Description
     *   00   DISABLED   Interrupt disabled
     *   01   MAP_INT1     Mapped to INT1
     *   10   MAP_INT2     Mapped to INT2
     *   11   MAP_IBI     Mapped to I3C IBI
     */

    /*! Maps no-motion output to either INT1 or INT2 or IBI */
    uint8_t no_motion_out;

    /*! Maps any-motion output to either INT1 or INT2 or IBI */
    uint8_t any_motion_out;

    /*! Maps flat output to either INT1 or INT2 or IBI */
    uint8_t flat_out;

    /*! Maps orientation output to either INT1 or INT2 or IBI */
    uint8_t orientation_out;

    /*! Maps step detector output to either INT1 or INT2 or IBI */
    uint8_t step_detector_out;

    /*! Maps step counter output to either INT1 or INT2 or IBI */
    uint8_t step_counter_out;

    /*! Maps significant motion output to either INT1 or INT2 or IBI */
    uint8_t sig_motion_out;

    /*! Maps tilt output to either INT1 or INT2 or IBI */
    uint8_t tilt_out;

    /*! Maps tap output to either INT1 or INT2 or IBI */
    uint8_t tap_out;

    /*! Maps i3c output to either INT1 or INT2 or IBI  */
    uint8_t i3c_out;

    /*! Maps feature engine's error or status change to either INT1 or INT2 or IBI */
    uint8_t err_status;

    /*! Maps temperature data ready interrupt to either INT1 or INT2 or IBI */
    uint8_t temp_drdy_int;

    /*! Maps gyro data ready interrupt to either INT1 or INT2 or IBI */
    uint8_t gyr_drdy_int;

    /*! Maps accel data ready interrupt to either INT1 or INT2 or IBI */
    uint8_t acc_drdy_int;

    /*! Maps FIFO watermark interrupt to either INT1 or INT2 or IBI */
    uint8_t fifo_watermark_int;

    /*! Maps FIFO full interrupt to either INT1 or INT2 or IBI */
    uint8_t fifo_full_int;
};

/*!
 * @brief Structure to store config version
 */
struct bmi3_config_version
{
    /*! Maps config1 major version */
    uint16_t config1_major_version;

    /*! Maps config1 minor version */
    uint8_t config1_minor_version;

    /*! Maps config2 major version */
    uint16_t config2_major_version;

    /*! Maps config2 minor version */
    uint8_t config2_minor_version;
};

/*!
 * @brief Structure to store self calibration result
 */
struct bmi3_self_calib_rslt
{
    /*! Stores the self-calibration result */
    uint8_t gyro_sc_rslt;

    /*! Stores the self-calibration error codes result */
    uint8_t sc_error_rslt;
};

/*!
 * @brief Structure to store alternate status
 */
struct bmi3_alt_status
{
    /*! Stores alternate accel status */
    uint8_t alt_accel_status;

    /*! Stores alternate gyro status */
    uint8_t alt_gyro_status;
};

/*!
 * @brief Structure to store accel dp gain offset values
 */
struct bmi3_acc_dp_gain_offset
{
    /*! Accel dp offset x-axis */
    uint16_t acc_dp_off_x;

    /*! Accel dp offset y-axis */
    uint16_t acc_dp_off_y;

    /*! Accel dp offset z-axis */
    uint16_t acc_dp_off_z;

    /*! Accel dp gain x-axis */
    uint8_t acc_dp_dgain_x;

    /*! Accel dp gain y-axis */
    uint8_t acc_dp_dgain_y;

    /*! Accel dp gain z-axis */
    uint8_t acc_dp_dgain_z;
};

/*!
 * @brief Structure to store gyro dp gain offset values
 */
struct bmi3_gyr_dp_gain_offset
{
    /*! Gyro dp offset x-axis */
    uint16_t gyr_dp_off_x;

    /*! Gyro dp offset y-axis */
    uint16_t gyr_dp_off_y;

    /*! Gyro dp offset z-axis */
    uint16_t gyr_dp_off_z;

    /*! Gyro dp gain x-axis */
    uint8_t gyr_dp_dgain_x;

    /*! Gyro dp gain y-axis */
    uint8_t gyr_dp_dgain_y;

    /*! Gyro dp gain z-axis */
    uint8_t gyr_dp_dgain_z;
};

/*!
 * @brief Structure to store accel user gain offset values
 */
struct bmi3_acc_usr_gain_offset
{
    /*! Accel user offset x-axis */
    uint16_t acc_usr_off_x;

    /*! Accel user offset y-axis */
    uint16_t acc_usr_off_y;

    /*! Accel user offset z-axis */
    uint16_t acc_usr_off_z;

    /*! Accel user gain x-axis */
    uint8_t acc_usr_gain_x;

    /*! Accel user gain y-axis */
    uint8_t acc_usr_gain_y;

    /*! Accel user gain z-axis */
    uint8_t acc_usr_gain_z;
};

/*!
 * @brief Structure to store gyro user gain offset values
 */
struct bmi3_gyr_usr_gain_offset
{
    /*! Gyro user offset x-axis */
    uint16_t gyr_usr_off_x;

    /*! Gyro user offset y-axis */
    uint16_t gyr_usr_off_y;

    /*! Gyro user offset z-axis */
    uint16_t gyr_usr_off_z;

    /*! Gyro user gain x-axis */
    uint8_t gyr_usr_gain_x;

    /*! Gyro user gain y-axis */
    uint8_t gyr_usr_gain_y;

    /*! Gyro user gain z-axis */
    uint8_t gyr_usr_gain_z;
};

/*!
 * @brief Structure to enable an accel axis for FOC
 */
struct bmi3_accel_foc_g_value
{
    /*! '0' to disable x axis and '1' to enable x axis */
    uint8_t x;

    /*! '0' to disable y axis and '1' to enable y axis */
    uint8_t y;

    /*! '0' to disable z axis and '1' to enable z axis */
    uint8_t z;

    /*! '0' for positive input and '1' for negative input */
    uint8_t sign;
};

/*!
 * @brief Structure to store temporary accelerometer values
 */
struct bmi3_foc_temp_value
{
    /*! X data */
    int32_t x;

    /*! Y data */
    int32_t y;

    /*! Z data */
    int32_t z;
};

/*!
 * @brief Structure to store accelerometer data deviation from ideal value
 */
struct bmi3_offset_delta
{
    /*! X axis */
    int16_t x;

    /*! Y axis */
    int16_t y;

    /*! Z axis */
    int16_t z;
};

#endif /* _BMI3_DEFS_H */
