roboryman/EchoCore/PinOutPlanning_RETS/Core/Inc/main.h

#define ADC_INT_Pin GPIO_PIN_1
#define ADC_INT_GPIO_Port GPIOB
#define ADC_INT_EXTI_IRQn EXTI0_1_IRQn
#define IMU_INT1_Pin GPIO_PIN_12
#define IMU_INT1_GPIO_Port GPIOB
#define IMU_INT1_EXTI_IRQn EXTI4_15_IRQn
#define IMU_INT2_Pin GPIO_PIN_9
#define IMU_INT2_GPIO_Port GPIOA
#define IMU_INT2_EXTI_IRQn EXTI4_15_IRQn
#define SPI2_CS_Pin GPIO_PIN_9
#define SPI2_CS_GPIO_Port GPIOB
