roboryman/EchoCore/PinOutPlanning_RETS/Core/Src/bmi3.c

/**
* Copyright (c) 2023 Bosch Sensortec GmbH. All rights reserved.
*
* BSD-3-Clause
*
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
* 1. Redistributions of source code must retain the above copyright
*    notice, this list of conditions and the following disclaimer.
*
* 2. Redistributions in binary form must reproduce the above copyright
*    notice, this list of conditions and the following disclaimer in the
*    documentation and/or other materials provided with the distribution.
*
* 3. Neither the name of the copyright holder nor the names of its
*    contributors may be used to endorse or promote products derived from
*    this software without specific prior written permission.
*
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
* @file       bmi3.c
* @date       2023-02-17
* @version    v2.1.0
*
*/

/******************************************************************************/

/*!  @name          Header Files                                  */
/******************************************************************************/
#include "bmi3.h"
#include "stdio.h"

/***************************************************************************/

/*!              Static Variable
 ****************************************************************************/

/*! Array to store config array code */
static uint8_t bmi3_config_array_code[] = {
    0x48, 0x02, 0x94, 0x01, 0x01, 0x2e, 0xa0, 0xf2, 0x09, 0xbc, 0x20, 0x50, 0x0d, 0xb8, 0x03, 0x2e, 0xd0, 0x03, 0x01,
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
    0xb9, 0xf3, 0x6f, 0x4a, 0x0a, 0xc1, 0x42, 0x00, 0x2e, 0xbb, 0x6f, 0xb0, 0x5f, 0xb8, 0x2e, 0x20, 0x50, 0x01, 0x2e,
    0xda, 0x03, 0xf3, 0x7f, 0x00, 0xb2, 0xeb, 0x7f, 0xa3, 0x32, 0x0e, 0x2f, 0x01, 0x90, 0x0a, 0x2f, 0x24, 0x25, 0x07,
    0x2e, 0xdb, 0x03, 0xf4, 0x6f, 0xa1, 0x32, 0x98, 0x2e, 0x80, 0x03, 0x00, 0x30, 0x21, 0x2e, 0xda, 0x03, 0x0b, 0x2d,
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
};

/*! Array to store config array table */
static uint8_t bmi3_config_array_table[] = {
    0x05, 0x02, 0x0c, 0x00, 0x99, 0x02, 0x97, 0x02, 0x8f, 0x02, 0x6e, 0x02, 0x00, 0x00, 0x80, 0x02, 0xaf, 0x02, 0xea,
    0x02, 0x00, 0x00, 0x00, 0x00, 0x00, 0x00, 0x81, 0x02
};

/*! Array to store config version */
static uint8_t bmi3_config_version[] = {
    0xad, 0x00, 0x01, 0x00, 0x08, 0x08
};

/******************************************************************************/

/*!         Local Function Prototypes
 ******************************************************************************/

/*!
 * @brief This internal API sets accelerometer configurations like ODR, accel mode,
 * bandwidth, averaging samples and range.
 *
 * @param[in,out] config    : Structure instance of bmi3_accel_config.
 * @param[in,out] dev       : Structure instance of bmi3_dev.
 *
 * @return Result of API execution status
 *
 * @return 0 -> Success
 * @return < 0 -> Fail
 *
 */
static int8_t set_accel_config(struct bmi3_accel_config *config, struct bmi3_dev *dev);

/*!
 * @brief This internal API validates bandwidth and averaging samples of the
 * accelerometer set by the user.
 *
 * @param[in, out] bandwidth : Pointer to bandwidth value set by the user.
 * @param[in, out] acc_mode  : Pointer to accel mode set by the user.
 * @param[in, out] avg_num   : Pointer to average samples set by the user.
 * @param[in, out] dev       : Structure instance of bmi3_dev.
 *
 * @return Result of API execution status
 *
 * @note dev->info contains two warnings: BMI3_I_MIN_VALUE and BMI3_I_MAX_VALUE
 *
 * @return 0 -> Success
 * @return < 0 -> Fail
 * @return > 0 -> Warning
 *
 */
static int8_t validate_bw_avg_acc_mode(uint8_t *bandwidth, uint8_t *acc_mode, uint8_t *avg_num, struct bmi3_dev *dev);

/*!
 * @brief This internal API validates ODR and range of the accelerometer set by
 * the user.
 *
 * @param[in, out] odr    : Pointer to ODR value set by the user.
 * @param[in, out] range  : Pointer to range value set by the user.
 * @param[in, out] dev    : Structure instance of bmi3_dev.
 *
 * @return Result of API execution status
 *
 * @note dev->info contains two warnings: BMI3_I_MIN_VALUE and BMI3_I_MAX_VALUE
 *
 * @return 0 -> Success
 * @return < 0 -> Fail
 * @return > 0 -> Warning
 */
static int8_t validate_acc_odr_range(uint8_t *odr, uint8_t *range, struct bmi3_dev *dev);

/*!
 * @brief This internal API is used to check the boundary conditions.
 *
 * @param[in,out] val    : Pointer to the value to be validated.
 * @param[in]     min    : Minimum value.
 * @param[in]     max    : Maximum value.
 * @param[in]     dev    : Structure instance of bmi3_dev.
 *
 * @return Result of API execution status
 *
 * @return 0 -> Success
 * @return < 0 -> Fail
 *
 */
static int8_t check_boundary_val(uint8_t *val, uint8_t min, uint8_t max, struct bmi3_dev *dev);

/*!
 * @brief This internal API gets accelerometer configurations like ODR, accel mode,
 * bandwidth, averaging samples and range.
 *
 * @param[out] config    : Structure instance of bmi3_accel_config.
 * @param[in]  dev       : Structure instance of bmi3_dev.
 *
 * @return Result of API execution status
 *
 * @return 0 -> Success
 * @return < 0 -> Fail
 *
 */
static int8_t get_accel_config(struct bmi3_accel_config *config, struct bmi3_dev *dev);

/*!
 * @brief This internal API gets the accelerometer data from the register.
 *
 * @param[out] data         : Structure instance of sensor_data.
 * @param[in]  reg_addr     : Register address where data is stored.
 * @param[in]  dev          : Structure instance of bmi3_dev.
 *
 * @return Result of API execution status
 *
 * @return 0 -> Success
 * @return < 0 -> Fail
 *
 */
static int8_t get_accel_sensor_data(struct bmi3_sens_axes_data *data, uint8_t reg_addr, struct bmi3_dev *dev);

/*!
 * @brief This internal API sets gyroscope configurations like ODR, gyro mode,
 * bandwidth, averaging samples and range.
 *
 * @param[in] config    : Structure instance of bmi3_gyro_config.
 * @param[in, out] dev  : Structure instance of bmi3_dev.
 *
 * @return Result of API execution status
 *
 * @return 0 -> Success
 * @return < 0 -> Fail
 *
 */
static int8_t set_gyro_config(struct bmi3_gyro_config *config, struct bmi3_dev *dev);

/*!
 * @brief This internal API validates bandwidth and averaging samples of the
 * gyroscope set by the user.
 *
 * @param[in, out] bandwidth : Pointer to bandwidth value set by the user.
 * @param[in, out] gyr_mode  : Pointer to gyro mode set by the user.
 * @param[in, out] avg_num   : Pointer to average samples set by the user.
 * @param[in, out] dev       : Structure instance of bmi3_dev.
 *
 * @return Result of API execution status
 *
 * @note dev->info contains two warnings: BMI3_I_MIN_VALUE and BMI3_I_MAX_VALUE
 *
 * @return 0 -> Success
 * @return < 0 -> Fail
 *
 */
static int8_t validate_bw_avg_gyr_mode(uint8_t *bandwidth,
                                       uint8_t *gyr_mode,
                                       const uint8_t *avg_num,
                                       struct bmi3_dev *dev);

/*!
 * @brief This internal API validates ODR and range of the gyroscope set by
 * the user.
 *
 * @param[in, out] odr    : Pointer to ODR value set by the user.
 * @param[in, out] range  : Pointer to range value set by the user.
 * @param[in, out] dev    : Structure instance of bmi3_dev.
 *
 * @return Result of API execution status
 *
 * @note dev->info contains two warnings: BMI3_I_MIN_VALUE and BMI3_I_MAX_VALUE
 *
 * @return 0 -> Success
 * @return < 0 -> Fail
 *
 */
static int8_t validate_gyr_odr_range(uint8_t *odr, uint8_t *range, struct bmi3_dev *dev);

/*!
 * @brief This internal API gets the gyroscope data from the register.
 *
 * @param[out] data         : Structure instance of bmi3_sens_axes_data.
 * @param[in]  reg_addr     : Register address where data is stored.
 * @param[in]  dev          : Structure instance of bmi3_dev.
 *
 * @return Result of API execution status
 *
 * @return 0 -> Success
 * @return < 0 -> Fail
 *
 */
static int8_t get_gyro_sensor_data(struct bmi3_sens_axes_data *data, uint8_t reg_addr, struct bmi3_dev *dev);

/*!
 * @brief This internal API gets the step counter data from the register.
 *
 * @param[out] step_count   : Variable to get step counter data.
 * @param[in]  reg_addr     : Register address where data is stored.
 * @param[in]  dev          : Structure instance of bmi3_dev.
 *
 * @return Result of API execution status
 *
 * @return 0 -> Success
 * @return < 0 -> Fail
 *
 */
static int8_t get_step_counter_sensor_data(uint32_t *step_count, uint8_t reg_addr, struct bmi3_dev *dev);

/*!
 * @brief This internal API gets the orientation output data from the register.
 *
 * @param[out] orient_out   : Structure instance of bmi3_orientation_output.
 * @param[in]  reg_addr     : Register address where data is stored.
 * @param[in]  dev          : Structure instance of bmi3_dev.
 *
 * @return Result of API execution status
 *
 * @return 0 -> Success
 * @return < 0 -> Fail
 *
 */
static int8_t get_orient_output_data(struct bmi3_orientation_output *orient_out, uint8_t reg_addr,
                                     struct bmi3_dev *dev);

/*!
 * @brief This internal API gets gyroscope configurations like ODR, gyro mode,
 * bandwidth, averaging samples and range.
 *
 * @param[out] config    : Structure instance of bmi3_gyro_config.
 * @param[in]  dev       : Structure instance of bmi3_dev.
 *
 * @return Result of API execution status
 *
 * @return 0 -> Success
 * @return < 0 -> Fail
 *
 */
static int8_t get_gyro_config(struct bmi3_gyro_config *config, struct bmi3_dev *dev);

/*!
 * @brief This internal API gets the accelerometer data.
 *
 * @param[out] data         : Structure instance of bmi3_sens_axes_data.
 * @param[in]  reg_data     : Data stored in the register.
 *
 * @return None
 *
 * @retval None
 */
static void get_acc_data(struct bmi3_sens_axes_data *data, const uint16_t *reg_data);

/*!
 * @brief This internal API gets the gyroscope data.
 *
 * @param[out] data         : Structure instance of bmi3_sens_axes_data.
 * @param[in]  reg_data     : Data stored in the register.
 *
 * @return None
 *
 * @retval None
 */
static void get_gyr_data(struct bmi3_sens_axes_data *data, const uint16_t *reg_data);

/*!
 * @brief This internal API is used to validate the device pointer for
 * null conditions.
 *
 * @param[in] dev : Structure instance of bmi3_dev.
 *
 * @return Result of API execution status
 *
 * @return 0 -> Success
 * @return < 0 -> Fail
 *
 */
static int8_t null_ptr_check(const struct bmi3_dev *dev);

/*!
 * @brief This internal API is used to set the feature.
 *
 * @param[in] dev    : Structure instance of bmi3_dev.
 * @param[in] enable : Structure instance of bmi3_feature_enable.
 *
 * @return Result of API execution status
 *
 * @return 0 -> Success
 * @return < 0 -> Fail
 *
 */
static int8_t set_feature_enable(const struct bmi3_feature_enable *enable, struct bmi3_dev *dev);

/*!
 * @brief This internal API is used to get the feature.
 *
 * @param[in] dev    : Structure instance of bmi3_dev.
 * @param[in] enable : Structure instance of bmi3_feature_enable.
 *
 * @return Result of API execution status
 *
 * @return 0 -> Success
 * @return < 0 -> Fail
 *
 */
static int8_t get_feature_enable(struct bmi3_feature_enable *enable, struct bmi3_dev *dev);

/*!
 * @brief This internal API gets any-motion configurations like slope_thres,
 * duration, hysteresis, accel ref up and wait time.
 *
 * @param[out]      config     : Structure instance of bmi3_any_motion_config.
 * @param[in, out] dev         : Structure instance of bmi3_dev.
 *
 * @verbatim
 *----------------------------------------------------------------------------
 *  bmi3_any_motion_config  |
 *  Structure parameters    |                   Description
 *--------------------------|--------------------------------------------------
 *                          | Minimum slope of acceleration signal for
 *                          | motion detection.
 *   slope_thres            | Default value = 10, Range = 0 to 4095, Unit = 1.953mg.
 *                          |
 * -------------------------|---------------------------------------------------
 *   accel reference up     |  Mode of the acceleration reference update
 * -------------------------|---------------------------------------------------
 *                          | Hysteresis for the slope of the acceleration
 *   hysteresis             | signal. Default value = 2, Range = 0 to 1023,
 *                          | Unit = 1.953mg.
 * -------------------------|---------------------------------------------------
 *                          | Defines the number of  consecutive data points for
 *                          | which the threshold condition must be respected,
 *                          | for interrupt assertion.
 *   duration               | unit is 20ms, range
 *                          | Default value is 10 = 2000ms.
 * -------------------------|---------------------------------------------------
 *                          |
 *   wait time              | Wait time for clearing the event after slope
 *                          | is below threshold. Default value = 3, Range = 0 to 7, Unit =
 *                          | 20ms.
 * -----------------------------------------------------------------------------
 *
 * @endverbatim
 *
 * @return Result of API execution status
 *
 * @return 0 -> Success
 * @return < 0 -> Fail
 *
 */
static int8_t get_any_motion_config(struct bmi3_any_motion_config *config, struct bmi3_dev *dev);

/*!
 * @brief This internal API sets any-motion configurations like slope threshold,
 * duration, hysteresis, accel ref up and wait time.
 *
 * @param[in]      config      : Structure instance of bmi3_any_motion_config.
 * @param[in, out] dev         : Structure instance of bmi3_dev.
 *
 * @verbatim
 *----------------------------------------------------------------------------
 *  bmi3_any_motion_config  |
 *  Structure parameters    |                   Description
 *--------------------------|--------------------------------------------------
 *                          | Minimum slope of acceleration signal for
 *                          | motion detection.
 *   slope_thres            | Default value = 10, Range = 0 to 4095, Unit = 1.953mg.
 *                          |
 * -------------------------|---------------------------------------------------
 *   accel reference up     |  Mode of the acceleration reference update
 * -------------------------|---------------------------------------------------
 *                          | Hysteresis for the slope of the acceleration
 *   hysteresis             | signal. Default value = 2, Range = 0 to 1023,
 *                          | Unit = 1.953mg.
 * -------------------------|---------------------------------------------------
 *                          | Defines the number of  consecutive data points for
 *                          | which the threshold condition must be respected,
 *                          | for interrupt assertion.
 *   duration               | unit is 20ms, range
 *                          | Default value is 10 = 2000ms.
 * -------------------------|---------------------------------------------------
 *                          |
 *   wait time              | Wait time for clearing the event after slope
 *                          | is below threshold. Default value = 3, Range = 0 to 7, Unit =
 *                          | 20ms.
 * -----------------------------------------------------------------------------
 *
 * @endverbatim
 *
 * @return Result of API execution status
 *
 * @return 0 -> Success
 * @return < 0 -> Fail
 *
 */
static int8_t set_any_motion_config(const struct bmi3_any_motion_config *config, struct bmi3_dev *dev);

/*!
 * @brief This internal API gets no-motion configurations like slope threshold,
 * duration, hysteresis, accel ref up and wait time.
 *
 * @param[out]      config     : Structure instance of bmi3_no_motion_config.
 * @param[in, out] dev         : Structure instance of bmi3_dev.
 *
 * @verbatim
 *----------------------------------------------------------------------------
 *  bmi3_no_motion_config   |
 *  Structure parameters    |                   Description
 *--------------------------|--------------------------------------------------
 *                          | Minimum slope of acceleration signal for
 *                          | motion detection.
 *   slope_thres            | Default value = 10, Range = 0 to 4095, Unit = 1.953mg.
 *                          |
 * -------------------------|---------------------------------------------------
 *   accel reference up     |  Mode of the acceleration reference update
 * -------------------------|---------------------------------------------------
 *                          | Hysteresis for the slope of the acceleration
 *   hysteresis             | signal. Default value = 2, Range = 0 to 1023,
 *                          | Unit = 1.953mg.
 * -------------------------|---------------------------------------------------
 *                          | Defines the number of  consecutive data points for
 *                          | which the threshold condition must be respected,
 *                          | for interrupt assertion.
 *   duration               | unit is 20ms, range
 *                          | Default value is 10 = 2000ms.
 * -------------------------|---------------------------------------------------
 *                          |
 *   wait time              | Wait time for clearing the event after slope
 *                          | is below threshold. Default value = 3, Range = 0 to 7, Unit =
 *                          | 20ms.
 * -----------------------------------------------------------------------------
 *
 * @endverbatim
 *
 * @return Result of API execution status
 *
 * @return 0 -> Success
 * @return < 0 -> Fail
 *
 */
static int8_t get_no_motion_config(struct bmi3_no_motion_config *config, struct bmi3_dev *dev);

/*!
 * @brief This internal API sets no-motion configurations like slope threshold,
 * duration, hysteresis, accel ref up and wait time.
 *
 * @param[in]      config      : Structure instance of bmi3_no_motion_config.
 * @param[in, out] dev         : Structure instance of bmi3_dev.
 *
 * @verbatim
 *----------------------------------------------------------------------------
 *  bmi3_no_motion_config   |
 *  Structure parameters    |                   Description
 *--------------------------|--------------------------------------------------
 *                          | Minimum slope of acceleration signal for
 *                          | motion detection.
 *   slope_thres            | Default value = 10, Range = 0 to 4095, Unit = 1.953mg.
 *                          |
 * -------------------------|---------------------------------------------------
 *   accel reference up     |  Mode of the acceleration reference update
 * -------------------------|---------------------------------------------------
 *                          | Hysteresis for the slope of the acceleration
 *   hysteresis             | signal. Default value = 2, Range = 0 to 1023,
 *                          | Unit = 1.953mg.
 * -------------------------|---------------------------------------------------
 *                          | Defines the number of  consecutive data points for
 *                          | which the threshold condition must be respected,
 *                          | for interrupt assertion.
 *   duration               | unit is 20ms, range
 *                          | Default value is 10 = 2000ms.
 * -------------------------|---------------------------------------------------
 *                          |
 *   wait time              | Wait time for clearing the event after slope
 *                          | is below threshold. Default value = 3, Range = 0 to 7, Unit =
 *                          | 20ms.
 * -----------------------------------------------------------------------------
 *
 * @endverbatim
 *
 * @return Result of API execution status
 *
 * @return 0 -> Success
 * @return < 0 -> Fail
 *
 */
static int8_t set_no_motion_config(const struct bmi3_no_motion_config *config, struct bmi3_dev *dev);

/*!
 * @brief This internal API gets flat configurations like theta, blocking,
 * hold-time, hysteresis, and slope threshold.
 *
 * @param[out]     config           : Structure instance of bmi3_flat_config.
 * @param[in, out] dev              : Structure instance of bmi3_dev.
 *
 * @verbatim
 *----------------------------------------------------------------------------
 *      bmi3_flat_config    |
 *      Structure parameters|               Description
 *--------------------------|--------------------------------------------------
 *                          | Theta angle, used for detecting flat
 *                          | position.
 *      theta               | Theta = 64 * (tan(angle)^2);
 *                          | Default value is 8, equivalent to 20 degrees angle
 * -------------------------|---------------------------------------------------
 *                          | Hysteresis for Theta Flat detection.
 *      hysteresis          | Default value is 9 = 2.5 degrees, corresponding
 *                          | to the default Theta angle of 20 degrees.
 * -------------------------|---------------------------------------------------
 *                          | Sets the blocking mode. If blocking is set, no
 *                          | Flat interrupt will be triggered.
 *      blocking            | Default value is 2, the most restrictive blocking
 *                          | mode.
 * -------------------------|---------------------------------------------------
 *                          | Holds the duration in 50Hz samples for which the
 *                          | condition has to be respected.
 *      hold-time           | Default value is 32 = 640 m-sec.
 *                          | Range is 0 to 5.1 sec.
 * -------------------------|---------------------------------------------------
 *                          | Minimum slope between consecutive acceleration
 *      slope_thres         | samples to prevent the change of flat status during
 *                          | large movement. Default value is 0xcd = 400.365mg,
 *                          | Range = 498.015mg, Unit = 1.953mg.
 * -------------------------|---------------------------------------------------
 * @endverbatim
 *
 * @return Result of API execution status
 *
 * @return 0 -> Success
 * @return < 0 -> Fail
 *
 */
static int8_t get_flat_config(struct bmi3_flat_config *config, struct bmi3_dev *dev);

/*!
 * @brief This internal API sets flat configurations like theta, blocking,
 * hold-time, hysteresis, and slope threshold.
 *
 * @param[in]     config           : Structure instance of bmi3_flat_config.
 * @param[in, out] dev             : Structure instance of bmi3_dev.
 *
 * @verbatim
 *----------------------------------------------------------------------------
 *      bmi3_flat_config    |
 *      Structure parameters|               Description
 *--------------------------|--------------------------------------------------
 *                          | Theta angle, used for detecting flat
 *                          | position.
 *      theta               | Theta = 64 * (tan(angle)^2);
 *                          | Default value is 8, equivalent to 20 degrees angle
 * -------------------------|---------------------------------------------------
 *                          | Hysteresis for Theta Flat detection.
 *      hysteresis          | Default value is 9 = 2.5 degrees, corresponding
 *                          | to the default Theta angle of 20 degrees.
 * -------------------------|---------------------------------------------------
 *                          | Sets the blocking mode. If blocking is set, no
 *                          | Flat interrupt will be triggered.
 *      blocking            | Default value is 2, the most restrictive blocking
 *                          | mode.
 * -------------------------|---------------------------------------------------
 *                          | Holds the duration in 50Hz samples for which the
 *                          | condition has to be respected.
 *      hold-time           | Default value is 32 = 640 m-sec.
 *                          | Range is 0 to 5.1 sec.
 * -------------------------|---------------------------------------------------
 *                          | Minimum slope between consecutive acceleration
 *      slope_threshold     | samples to prevent the change of flat status during
 *                          | large movement. Default value is 0xcd = 400.365mg,
 *                          | Range = 498.015mg, Unit = 1.953mg.
 * -------------------------|---------------------------------------------------
 * @endverbatim
 *
 * @return Result of API execution status
 *
 * @return 0 -> Success
 * @return < 0 -> Fail
 *
 */
static int8_t set_flat_config(const struct bmi3_flat_config *config, struct bmi3_dev *dev);

/*!
 * @brief This internal API gets sig-motion configurations like block-size,
 * peak_2_peak_min, mcr_min, peak_2_peak_max and mcr_max parameters.
 *
 * @param[out]      config    : Structure instance of bmi3_sig_motion_config.
 * @param[in, out]  dev       : Structure instance of bmi3_dev.
 *
 *----------------------------------------------------------------------------
 *  bmi3_sig_motion_config  |
 *  Structure parameters    |                   Description
 * -------------------------|---------------------------------------------------
 *                          | Defines the duration after which the significant
 *  block_size              | motion interrupt is triggered. It is expressed in
 *                          | 50 Hz samples (20 ms). Default value is 0xFA=5sec.
 *--------------------------|---------------------------------------------------
 *                          | Minimum value of the peak to peak acceleration
 *  peak_2_peak_min         | magnitude. Default value 0x26 = 74.214mg, Range = 0 to 1023,
 *                          | Unit = 1.953mg
 *--------------------------|---------------------------------------------------
 *                          | Minimum number of mean crossing per second in accel
 *  mcr_min                 | magnitude. Default value = 17, Range = 0 to 63.
 *--------------------------|---------------------------------------------------
 *                          | Maximum value of the peak to peak acceleration
 *  peak_2_peak_max         | magnitude. Default value 0x253 = 1162.035mg, Range = 0 to 1023,
 *                          | Unit = 1.953mg
 *--------------------------|---------------------------------------------------
 *                          | Maximum number of mean crossing per second in accel
 *  mcr_max                 | magnitude. Default value = 17, Range = 0 to 63.
 *--------------------------|---------------------------------------------------
 *
 * @return Result of API execution status
 *
 * @return 0 -> Success
 * @return < 0 -> Fail
 *
 */
static int8_t get_sig_motion_config(struct bmi3_sig_motion_config *config, struct bmi3_dev *dev);

/*!
 * @brief This internal API sets sig-motion configurations like block-size,
 * peak_2_peak_min, mcr_min, peak_2_peak_max and mcr_max parameters.
 *
 * @param[in]      config    : Structure instance of bmi3_sig_motion_config.
 * @param[in, out]  dev      : Structure instance of bmi3_dev.
 *
 *----------------------------------------------------------------------------
 *  bmi3_sig_motion_config  |
 *  Structure parameters    |                   Description
 * -------------------------|---------------------------------------------------
 *                          | Defines the duration after which the significant
 *  block_size              | motion interrupt is triggered. It is expressed in
 *                          | 50 Hz samples (20 ms). Default value is 0xFA=5sec.
 *--------------------------|---------------------------------------------------
 *                          | Minimum value of the peak to peak acceleration
 *  peak_2_peak_min         | magnitude. Default value 0x26 = 74.214mg, Range = 0 to 1023,
 *                          | Unit = 1.953mg
 *--------------------------|---------------------------------------------------
 *                          | Minimum number of mean crossing per second in accel
 *  mcr_min                 | magnitude. Default value = 17, Range = 0 to 63.
 *--------------------------|---------------------------------------------------
 *                          | Maximum value of the peak to peak acceleration
 *  peak_2_peak_max         | magnitude. Default value 0x253 = 1162.035mg, Range = 0 to 1023,
 *                          | Unit = 1.953mg
 *--------------------------|---------------------------------------------------
 *                          | Maximum number of mean crossing per second in accel
 *  mcr_max                 | magnitude. Default value = 17, Range = 0 to 63.
 *--------------------------|---------------------------------------------------
 *
 * @return Result of API execution status
 *
 * @return 0 -> Success
 * @return < 0 -> Fail
 *
 */
static int8_t set_sig_motion_config(const struct bmi3_sig_motion_config *config, struct bmi3_dev *dev);

/*!
 * @brief This internal API gets the latch mode from register address
 *
 * @param[out]      int_cfg   : Structure instance of bmi3_int_pin_config.
 * @param[in, out]  dev       : Structure instance of bmi3_dev.
 *
 *
 * @return Result of API execution status
 *
 * @return 0 -> Success
 * @return < 0 -> Fail
 *
 */
static int8_t get_latch_mode(struct bmi3_int_pin_config *int_cfg, struct bmi3_dev *dev);

/*!
 * @brief This internal API sets the latch mode to register address
 *
 * @param[out]      int_cfg   : Structure instance of bmi3_int_pin_config.
 * @param[in, out]  dev       : Structure instance of bmi3_dev.
 *
 *
 * @return Result of API execution status
 *
 * @return 0 -> Success
 * @return < 0 -> Fail
 *
 */
static int8_t set_latch_mode(const struct bmi3_int_pin_config *int_cfg, struct bmi3_dev *dev);

/*!
 * @brief This internal API gets tilt configurations like segment size, minimum tilt angle
 * and beta accel mean.
 *
 * @param[out]      config        : Structure instance of bmi3_tilt_config.
 * @param[in, out] dev            : Structure instance of bmi3_dev.
 *
 * @verbatim
 *----------------------------------------------------------------------------
 *  bmi3_tilt_config        |
 *  Structure parameters    |                   Description
 *------------------------- |--------------------------------------------------
 *                          | Duration for which the acceleration vector is
 *                          | averaged to be reference vector. Default value = 100, Range = 0
 *   segment size           | to 255, Unit = 20ms.
 * ------------------------ |---------------------------------------------------
 *                          | Minimum angle by which the device shall be
 *                          | tilted for event detection.
 *  minimum tilt angle      | Angle is computed as 256 * cos(angle).
 *                          | Default value = 210, Range = 0 to 255.
 * ------------------------ |---------------------------------------------------
 *                          | Exponential smoothing coefficient for
 *  beta accel mean         | computing low-pass mean of acceleration vector.
 *                          | Coefficient is computed as beta * 65536.
 *                          | Default value = 61545, Range = 0 to 65535.
 * ------------------------ |---------------------------------------------------
 * @endverbatim
 *
 * @return Result of API execution status
 *
 * @return 0 -> Success
 * @return < 0 -> Fail
 *
 */
static int8_t get_tilt_config(struct bmi3_tilt_config *config, struct bmi3_dev *dev);

/*!
 * @brief This internal API sets tilt configurations like segment size, minimum tilt angle
 * and beta accel mean.
 *
 * @param[in]      config         : Structure instance of bmi3_tilt_config.
 * @param[in, out] dev            : Structure instance of bmi3_dev.
 *
 * @verbatim
 *----------------------------------------------------------------------------
 *  bmi3_tilt_config        |
 *  Structure parameters    |                   Description
 *------------------------- |--------------------------------------------------
 *                          | Duration for which the acceleration vector is
 *                          | averaged to be reference vector. Default value = 100, Range = 0
 *   segment size           | to 255, Unit = 20ms.
 * ------------------------ |---------------------------------------------------
 *                          | Minimum angle by which the device shall be
 *                          | tilted for event detection.
 *  minimum tilt angle      | Angle is computed as 256 * cos(angle).
 *                          | Default value = 210, Range = 0 to 255.
 * ------------------------ |---------------------------------------------------
 *                          | Exponential smoothing coefficient for
 *  beta accel mean         | computing low-pass mean of acceleration vector.
 *                          | Coefficient is computed as beta * 65536.
 *                          | Default value = 61545, Range = 0 to 65535.
 * ------------------------ |---------------------------------------------------
 * @endverbatim
 *
 * @return Result of API execution status
 *
 * @return 0 -> Success
 * @return < 0 -> Fail
 *
 */
static int8_t set_tilt_config(const struct bmi3_tilt_config *config, struct bmi3_dev *dev);

/*!
 * @brief This internal API gets orientation configurations like upside/down
 * enable, symmetrical modes, blocking mode, theta, hysteresis, slope threshold and
 * hold time configuration.
 *
 * @param[out]      config        : Structure instance of bmi3_orientation_config.
 * @param[in, out] dev            : Structure instance of bmi3_dev.
 *
 * @verbatim
 *-----------------------------------------------------------------------------
 *   bmi3_orientation_config|
 *   Structure parameters   |               Description
 *--------------------------|--------------------------------------------------
 *  upside/down             |  Enables upside/down detection, if set to 1.
 *  detection               |
 * -------------------------|---------------------------------------------------
 *                          | Sets the mode:
 *  mode                    | Values 0 or 3 - symmetrical.
 *                          | Value 1       - high asymmetrical
 *                          | Value 2       - low asymmetrical
 * -------------------------|---------------------------------------------------
 *                          | Enable - no orientation interrupt will be set.
 *  blocking                | Default value: 3, the most restrictive blocking.
 * -------------------------|---------------------------------------------------
 *                          | Threshold angle used in blocking mode.
 *  theta                   | Theta = 64 * (tan(angle)^2)
 *                          | Default value: 39, range 0 to 63.
 * -------------------------|---------------------------------------------------
 *                          | Hysteresis of acceleration in orientation change
 *  hysteresis              | change detection.
 *                          | Default value = 32, range 0 to 255, unit = 1.93mg.
 * -------------------------|---------------------------------------------------
 *                          | Minimum duration the device shall be in new orientation
 *  hold_time               | for change detection. default value = 5, range 0 to 255,
 *                          | unit = 20ms.
 * -------------------------|---------------------------------------------------
 *                          | Minimum slope between consecutive acceleration samples to
 *  slope_thres             | prevent the change of orientation during large movement.
 *                          | Default value = 205, range = 0 t0 255, uint = 1.953mg.
 * -------------------------|---------------------------------------------------
 *
 * @endverbatim
 *
 * @return Result of API execution status
 *
 * @return 0 -> Success
 * @return < 0 -> Fail
 *
 */
static int8_t get_orientation_config(struct bmi3_orientation_config *config, struct bmi3_dev *dev);

/*!
 * @brief This internal API sets orientation configurations like upside/down
 * enable, symmetrical modes, blocking mode, theta, hysteresis, slope threshold and
 * hold time configuration.
 *
 * @param[in]      config         : Structure instance of bmi3_orientation_config.
 * @param[in, out] dev            : Structure instance of bmi3_dev.
 *
 * @verbatim
 *-----------------------------------------------------------------------------
 *   bmi3_orientation_config|
 *   Structure parameters   |               Description
 *--------------------------|--------------------------------------------------
 *  upside/down             |  Enables upside/down detection, if set to 1.
 *  detection               |
 * -------------------------|---------------------------------------------------
 *                          | Sets the mode:
 *  mode                    | Values 0 or 3 - symmetrical.
 *                          | Value 1       - high asymmetrical
 *                          | Value 2       - low asymmetrical
 * -------------------------|---------------------------------------------------
 *                          | Enable - no orientation interrupt will be set.
 *  blocking                | Default value: 3, the most restrictive blocking.
 * -------------------------|---------------------------------------------------
 *                          | Threshold angle used in blocking mode.
 *  theta                   | Theta = 64 * (tan(angle)^2)
 *                          | Default value: 39, range 0 to 63.
 * -------------------------|---------------------------------------------------
 *                          | Hysteresis of acceleration in orientation change
 *  hysteresis              | change detection.
 *                          | Default value = 32, range 0 to 255, unit = 1.93mg.
 * -------------------------|---------------------------------------------------
 *                          | Minimum duration the device shall be in new orientation
 *  hold_time               | for change detection. default value = 5, range 0 to 255,
 *                          | unit = 20ms.
 * -------------------------|---------------------------------------------------
 *                          | Minimum slope between consecutive acceleration samples to
 *  slope_thres             | prevent the change of orientation during large movement.
 *                          | Default value = 205, range = 0 t0 255, uint = 1.953mg.
 * -------------------------|---------------------------------------------------
 *
 * @endverbatim
 *
 * @return Result of API execution status
 *
 * @return 0 -> Success
 * @return < 0 -> Fail
 *
 */
static int8_t set_orientation_config(const struct bmi3_orientation_config *config, struct bmi3_dev *dev);

/*!
 * @brief This internal API gets step counter/detector/activity configurations.
 *
 * @param[out] config     : Structure instance of bmi3_step_counter_config.
 * @param[in] dev         : Structure instance of bmi3_dev.
 *
 *---------------------------------------------------------------------------
 *  bmi3_step_counter_config|
 *  Structure parameters    |                 Description
 *--------------------------|--------------------------------------------------
 *                          | The Step-counter will trigger output every time
 *                          | the number of steps are counted. Holds implicitly
 *  water-mark level        | a 20x factor, so the range is 0 to 20460,
 *                          | with resolution of 20 steps. If 0 output disabled.
 * -------------------------|---------------------------------------------------
 *  reset counter           | Flag to reset the counted steps.
 * -------------------------|---------------------------------------------------
 *  step_counter_params     | 1 - 19 step_counter parameters for different settings.
 * -------------------------|---------------------------------------------------
 *                          | Switch between the devices.
 *                          | value 0 = Smart phone
 *  sc_12_res               | value 1 = Wrist wearable
 *                          | value 2 = Hearable
 * -------------------------|---------------------------------------------------
 * @endverbatim
 *
 * @return Result of API execution status
 *
 * @return 0 -> Success
 * @return < 0 -> Fail
 *
 */
static int8_t get_step_config(struct bmi3_step_counter_config *config, struct bmi3_dev *dev);

/*!
 * @brief This internal API sets step counter/detector/activity configurations.
 *
 * @param[in] config      : Structure instance of bmi3_step_counter_config.
 * @param[in] dev         : Structure instance of bmi3_dev.
 *
 *---------------------------------------------------------------------------
 *  bmi3_step_counter_config|
 *  Structure parameters    |                 Description
 *--------------------------|--------------------------------------------------
 *                          | The Step-counter will trigger output every time
 *                          | the number of steps are counted. Holds implicitly
 *  water-mark level        | a 20x factor, so the range is 0 to 20460,
 *                          | with resolution of 20 steps. If 0 output disabled.
 * -------------------------|---------------------------------------------------
 *  reset counter           | Flag to reset the counted steps.
 * -------------------------|---------------------------------------------------
 *  step_counter_params     | 1 - 19 step_counter parameters for different settings.
 * -------------------------|---------------------------------------------------
 *                          | Switch between the devices.
 *                          | value 0 = Smart phone
 *  sc_12_res               | value 1 = Wrist wearable
 *                          | value 2 = Hearable
 * -------------------------|---------------------------------------------------
 * @endverbatim
 *
 * @return Result of API execution status
 *
 * @return 0 -> Success
 * @return < 0 -> Fail
 *
 */
static int8_t set_step_config(const struct bmi3_step_counter_config *config, struct bmi3_dev *dev);

/*!
 * @brief This internal API gets wake-up configurations like axis sel, wait for time out,
 * max peaks for tap, mode, tap peaks threshold, max gesture duration, max dur between peaks,
 * tap_shock_settling_dur, min_quite_dur_between_taps, quite_time_after_gesture.
 *
 * @param[out]      config    : Structure instance of bmi3_tap_detector_config.
 * @param[in, out]  dev       : Structure instance of bmi3_dev.
 *
 * @verbatim
 *-----------------------------|------------------------------------------------
 *  bmi3_tap_detector_config   |
 *  Structure parameters       |               Description
 *-----------------------------|--------------------------------------------------
 *                             | Accelerometer sensing axis selection for tap
 *                             | detection. Default value = 2 (z-axis)
 *  axis_sel                   | Value  Name    Description
 *                             | 00    axis_x   Use x-axis for tap detection
 *                             | 01    axis_y   Use y-axis for tap detection
 *                             | 10    axis_z   Use z-axis for tap detection
 * ----------------------------|---------------------------------------------------
 *                             | Perform gesture confirmation with wait time
 *  wait_for_time_out          | set by max_gesture_dur. Default value = 1 (Enabled)
 * ----------------------------|---------------------------------------------------
 *                             | Maximum number of zero crossing expected
 *  max_peaks_for_tap          | around a tap. Default value = 6, Range = 0 to 7
 *                             |
 * ----------------------------|---------------------------------------------------
 *                             | Mode for detection of tap gesture. Default value = Normal.
 *  mode                       | In stable position of device, to improve detection accuracy,
 *                             | sensitive mode can be used.
 *                             | Under noisy scenarios, the false detection can be suppressed with Robust mode.
 *                             | Value    Name        Description
 *                             |  00     sensitive  Sensitive detection mode
 *                             |  01     normal     Normal detection mode
 *                             |  10     robust     Robust detection mode
 * ----------------------------|---------------------------------------------------
 *                             | Minimum threshold for peak resulting from the tap.
 *  tap_peak_threshold         | Default value 2d = 87.885mg, Range = 1997.919mg, Resolution = 1.953mg
 * ----------------------------|---------------------------------------------------
 *                             | Maximum duration from first tap within the
 *  max_gest_duration          | second and/or third tap is expected to happen.
 *                             | Default value = 16(640ms), Range = 2.520s Resolution = 40ms
 * ----------------------------|---------------------------------------------------
 *                             | Maximum duration between positive and negative peaks to tap.
 *  max_dur_between_peaks      |  Default value = 4(20ms), Range = 75ms, Resolution = 5ms
 * ----------------------------|---------------------------------------------------
 *                             | Maximum duration for which tap impact is observed.
 *  tap_shock_settling_dur     | Default value = 6(30ms), Range = 75ms, Resolution = 5ms
 * ----------------------------|---------------------------------------------------
 *                             | Minimum duration between two tap impact.
 *  min_quite_dur_between_taps | Default value = 8(40ms), Range = 1.2s, Resolution = 5ms.
 * ----------------------------|---------------------------------------------------
 *                             | Minimum quite duration between two gestures.
 *  quite_time_after_gesture   | Default value = 6(240ms), Range = 600ms , Resolution = 40ms.
 * ----------------------------|---------------------------------------------------
 *
 * @endverbatim
 *
 * @return Result of API execution status
 *
 * @return 0 -> Success
 * @return < 0 -> Fail
 *
 */
static int8_t get_tap_config(struct bmi3_tap_detector_config *config, struct bmi3_dev *dev);

/*!
 * @brief This internal API sets wake-up configurations like axis sel, wait for time out,
 * max peaks for tap, mode, tap peaks threshold, max gesture duration, max dur between peaks,
 * tap_shock_settling_dur, min_quite_dur_between_taps, quite_time_after_gesture.
 *
 * @param[in]      config    : Structure instance of bmi3_tap_detector_config.
 * @param[in, out]  dev      : Structure instance of bmi3_dev.
 *
 * @verbatim
 *-----------------------------|------------------------------------------------
 *  bmi3_tap_detector_config   |
 *  Structure parameters       |               Description
 *-----------------------------|--------------------------------------------------
 *                             | Accelerometer sensing axis selection for tap
 *                             | detection. Default value = 2 (z-axis)
 *  axis_sel                   | Value  Name    Description
 *                             | 00    axis_x   Use x-axis for tap detection
 *                             | 01    axis_y   Use y-axis for tap detection
 *                             | 10    axis_z   Use z-axis for tap detection
 * ----------------------------|---------------------------------------------------
 *                             | Perform gesture confirmation with wait time
 *  wait_for_time_out          | set by max_gesture_dur. Default value = 1 (Enabled)
 * ----------------------------|---------------------------------------------------
 *                             | Maximum number of zero crossing expected
 *  max_peaks_for_tap          | around a tap. Default value = 6, Range = 0 to 7
 *                             |
 * ----------------------------|---------------------------------------------------
 *                             | Mode for detection of tap gesture. Default value = Normal.
 *  mode                       | In stable position of device, to improve detection accuracy,
 *                             | sensitive mode can be used.
 *                             | Under noisy scenarios, the false detection can be suppressed with Robust mode.
 *                             | Value    Name        Description
 *                             |  00     sensitive  Sensitive detection mode
 *                             |  01     normal     Normal detection mode
 *                             |  10     robust     Robust detection mode
 * ----------------------------|---------------------------------------------------
 *                             | Minimum threshold for peak resulting from the tap.
 *  tap_peak_threshold         | Default value 2d = 87.885mg, Range = 1997.919mg, Resolution = 1.953mg
 * ----------------------------|---------------------------------------------------
 *                             | Maximum duration from first tap within the
 *  max_gest_duration          | second and/or third tap is expected to happen.
 *                             | Default value = 16(640ms), Range = 2.520s Resolution = 40ms
 * ----------------------------|---------------------------------------------------
 *                             | Maximum duration between positive and negative peaks to tap.
 *  max_dur_between_peaks      |  Default value = 4(20ms), Range = 75ms, Resolution = 5ms
 * ----------------------------|---------------------------------------------------
 *                             | Maximum duration for which tap impact is observed.
 *  tap_shock_settling_dur     | Default value = 6(30ms), Range = 75ms, Resolution = 5ms
 * ----------------------------|---------------------------------------------------
 *                             | Minimum duration between two tap impact.
 *  min_quite_dur_between_taps | Default value = 8(40ms), Range = 1.2s, Resolution = 5ms.
 * ----------------------------|---------------------------------------------------
 *                             | Minimum quite duration between two gestures.
 *  quite_time_after_gesture   | Default value = 6(240ms), Range = 600ms , Resolution = 40ms.
 * ----------------------------|---------------------------------------------------
 *
 * @endverbatim
 *
 * @return Result of API execution status
 *
 * @return 0 -> Success
 * @return < 0 -> Fail
 *
 */
static int8_t set_tap_config(const struct bmi3_tap_detector_config *config, struct bmi3_dev *dev);

/*!
 * @brief This internal API is used to parse accelerometer data from the FIFO
 * data.
 *
 * @param[out] acc              : Structure instance of bmi3_fifo_sens_axes_data
 *                                where the parsed data bytes are stored.
 * @param[in]  data_start_index : Index value of the accelerometer data bytes
 *                                which is to be parsed from the FIFO data.
 * @param[in]  fifo             : Structure instance of bmi3_fifo_frame.
 *
 * @return 0 -> Success
 * @return < 0 -> Fail
 */
static int8_t unpack_accel_data(struct bmi3_fifo_sens_axes_data *acc,
                                uint16_t data_start_index,
                                const struct bmi3_fifo_frame *fifo);

/*!
 * @brief This internal API is used to parse temperature data from the FIFO
 * data.
 *
 * @param[out] temp              : Structure instance of bmi3_fifo_temperature_data
 *                                 where the parsed data bytes are stored.
 * @param[in]  data_start_index  : Index value of the temperature data bytes
 *                                 which is to be parsed from the FIFO data.
 * @param[in]  fifo              : Structure instance of bmi3_fifo_frame.
 *
 * @return 0 -> Success
 * @return < 0 -> Fail
 */
static int8_t unpack_temperature_data(struct bmi3_fifo_temperature_data *temp,
                                      uint16_t data_start_index,
                                      const struct bmi3_fifo_frame *fifo);

/*!
 * @brief This internal API is used to parse gyroscope data from the FIFO
 * data.
 *
 * @param[out] gyro              : Structure instance of bmi3_fifo_sens_axes_data
 *                                 where the parsed data bytes are stored.
 * @param[in]  data_start_index  : Index value of the gyro data bytes
 *                                 which is to be parsed from the FIFO data.
 * @param[in]  fifo              : Structure instance of bmi3_fifo_frame.
 *
 * @return 0 -> Success
 * @return < 0 -> Fail
 */
static int8_t unpack_gyro_data(struct bmi3_fifo_sens_axes_data *gyro,
                               uint16_t data_start_index,
                               const struct bmi3_fifo_frame *fifo);

/*!
 * @brief This internal API is used to parse the accel, gyro, temperature and sensortime data from the
 * FIFO data in header-less mode. It updates the current data byte to be parsed.
 *
 * @param[in,out] fifo_data       : Void pointer where accel, gyro and temperature parsed data
 *                                  data bytes are stored.
 * @param[in,out] idx             : Index value of number of bytes parsed.
 * @param[in,out] updated_frm_idx : Index value of accel, gyro, temperature data (x,y,z axes)
 *                                  frame to be parsed.
 * @param[in]     frame           : Data is enabled by user.
 *
 * @param[in]     fifo            : Structure instance of bmi3_fifo_frame.
 *
 * @return Result of API execution status
 *
 * @return 0 -> Success
 * @return < 0 -> Fail
 *
 */
static int8_t unpack_fifo_data_frame(void *fifo_data,
                                     uint16_t *idx,
                                     uint16_t *updated_frm_idx,
                                     uint16_t frame,
                                     const struct bmi3_fifo_frame *fifo);

/*!
 * @brief This internal API is used to update data index based on the frame length
 *
 * @param[in,out] idx             : Index value of number of bytes parsed.
 * @param[in,out] updated_frm_idx : Index value of accel, gyro, temperature data (x,y,z axes)
 *                                  frame to be parsed.
 * @param[in]     len             : Length of the frame
 *
 * @param[in]     rslt            : Result value after unpacking frames
 *
 * @return Result of API execution status
 *
 * @return  None
 */
static void update_data_index(uint16_t *idx, uint16_t *updated_frm_idx, uint8_t len, int8_t rslt);

/*!
 * @brief This internal API sets the precondition settings such as alternate accelerometer and
 * gyroscope enable bits, accelerometer mode and output data rate.
 *
 *
 * @param[in] st_select : Variable denoting the self-test mode.
 * @param[in] dev       : Structure instance of bmi3_dev.
 *
 * @return Result of API execution status
 *
 * @return 0 -> Success
 * @return < 0 -> Fail
 *
 */
static int8_t st_precondition(uint8_t st_select, struct bmi3_dev *dev);

/*!
 * @brief This internal API gets and sets the self-test mode given
 *  by the user in the self-test dma register.
 *
 * @param[in] st_selection : Variable denoting the self-test mode.
 * @param[out] dev         : Structure instance of bmi3_dev.
 *
 * @return Result of API execution status
 *
 * @return 0 -> Success
 * @return < 0 -> Fail
 *
 */
static int8_t get_set_st_dma(uint8_t st_selection, struct bmi3_dev *dev);

/*!
 * @brief This internal API sets the self-test preconditions, individual gyroscope
 * filter coefficients and triggers the self-test in the command register.
 *
 * @param[in] st_selection : Variable denoting the self-test mode.
 * @param[in] dev          : Structure instance of bmi3_dev.
 *
 * @return Result of API execution status
 *
 * @return 0 -> Success
 * @return < 0 -> Fail
 *
 */
static int8_t self_test_conditions(uint8_t st_selection, struct bmi3_dev *dev);

/*!
 * @brief This internal API is used to disable alternate config accel and gyro mode for self-test precondition.
 *
 * @param[in] dev          : Structure instance of bmi3_dev.
 *
 * @return Result of API execution status
 *
 * @return 0 -> Success
 * @return < 0 -> Fail
 *
 */
static int8_t disable_alt_conf_acc_gyr_mode(struct bmi3_dev *dev);

/*!
 * @brief This internal API gets status of self-test and the result of self-test along with
 * the feature engine error status.
 *
 * @param[in] st_selection     : Variable denoting the self-test mode.
 * @param[in] st_result_status : Structure instance of bmi3_st_result.
 * @param[out] dev             : Structure instance of bmi3_dev.
 *
 * @return Result of API execution status
 *
 * @return 0 -> Success
 * @return < 0 -> Fail
 *
 */
static int8_t get_st_status_rslt(uint8_t st_selection, struct bmi3_st_result *st_result_status, struct bmi3_dev *dev);

/*!
 * @brief This internal API gets status of self-calibration and the result of self-calibration along with the feature
 * engine error status.
 *
 * @param[in] sc_rslt : Structure instance of bmi3_self_calib_rslt.
 * @param[out] dev    : Structure instance of bmi3_dev.
 *
 * @return Result of API execution status
 *
 * @return 0 -> Success
 * @return < 0 -> Fail
 *
 */
static int8_t get_sc_gyro_rslt(struct bmi3_self_calib_rslt *sc_rslt, struct bmi3_dev *dev);

/*!
 * @brief This internal API gets and sets the self-calibration mode given
 *  by the user in the self-calibration dma register.
 *
 * @param[in] sc_selection : Variable denoting the self-calibration mode.
 * @param[in] apply_corr   : Variable choosing to apply correction.
 * @param[out] dev         : Structure instance of bmi3_dev.
 *
 * @return Result of API execution status
 *
 * @return 0 -> Success
 * @return < 0 -> Fail
 *
 */
static int8_t get_set_sc_dma(uint8_t sc_selection, uint8_t apply_corr, struct bmi3_dev *dev);

/*!
 * @brief This internal API gets the i3c sync accelerometer data from the register.
 *
 * @param[out] data         : Structure instance of bmi3_i3c_sync_data.
 * @param[out]  dev         : Structure instance of bmi3_dev.
 *
 * @return Result of API execution status
 *
 * @return 0 -> Success
 * @return < 0 -> Fail
 *
 */

static int8_t get_i3c_sync_accel_sensor_data(struct bmi3_i3c_sync_data *data, struct bmi3_dev *dev);

/*!
 * @brief This internal API gets the i3c sync gyroscope data from the register.
 *
 * @param[out] data         : Structure instance of bmi3_i3c_sync_data.
 * @param[out]  dev         : Structure instance of bmi3_dev.
 *
 * @return Result of API execution status
 *
 * @return 0 -> Success
 * @return < 0 -> Fail
 *
 */

static int8_t get_i3c_sync_gyro_sensor_data(struct bmi3_i3c_sync_data *data, struct bmi3_dev *dev);

/*!
 * @brief This internal API gets the i3c sync temperature data from the register and can be
 * converted into degree celsius using the below formula.
 * Formula: temperature_value = (float)(((float)((int16_t)temperature_data)) / 512.0) + 23.0
 * @param[out] data         : Structure instance of bmi3_i3c_sync_data.
 * @param[in]  dev          : Structure instance of bmi3_dev.
 *
 * @return Result of API execution status
 *
 * @return 0 -> Success
 * @return < 0 -> Fail
 *
 */
static int8_t get_i3c_sync_temp_data(struct bmi3_i3c_sync_data *data, struct bmi3_dev *dev);

/*!
 * @brief This internal API sets alternate accelerometer configurations like ODR,
 * accel mode and average number of samples.
 *
 * @param[out] config    : Structure instance of bmi3_alt_accel_config.
 * @param[in]  dev       : Structure instance of bmi3_dev.
 *
 * @return Result of API execution status
 *
 * @return 0 -> Success
 * @return < 0 -> Fail
 *
 */
static int8_t set_alternate_accel_config(const struct bmi3_alt_accel_config *config, struct bmi3_dev *dev);

/*!
 * @brief This internal API gets alternate accelerometer configurations like ODR,
 * accel mode and average number of samples.
 *
 * @param[out] config    : Structure instance of bmi3_alt_accel_config.
 * @param[in]  dev       : Structure instance of bmi3_dev.
 *
 * @return Result of API execution status
 *
 * @return 0 -> Success
 * @return < 0 -> Fail
 *
 */
static int8_t get_alternate_accel_config(struct bmi3_alt_accel_config *config, struct bmi3_dev *dev);

/*!
 * @brief This internal API sets alternate gyro configurations like ODR,
 * gyro mode and average number of samples.
 *
 * @param[out] config    : Structure instance of bmi3_alt_gyro_config.
 * @param[in]  dev       : Structure instance of bmi3_dev.
 *
 * @return Result of API execution status
 *
 * @return 0 -> Success
 * @return < 0 -> Fail
 *
 */
static int8_t set_alternate_gyro_config(const struct bmi3_alt_gyro_config *config, struct bmi3_dev *dev);

/*!
 * @brief This internal API gets alternate gyro configurations like ODR,
 * gyro mode and average number of samples.
 *
 * @param[out] config    : Structure instance of bmi3_alt_gyro_config.
 * @param[out]  dev      : Structure instance of bmi3_dev.
 *
 * @return Result of API execution status
 *
 * @return 0 -> Success
 * @return < 0 -> Fail
 *
 */
static int8_t get_alternate_gyro_config(struct bmi3_alt_gyro_config *config, struct bmi3_dev *dev);

/*!
 * @brief This internal API gets alternate auto configurations for feature interrupts
 *
 * @param[out] config    : Structure instance of bmi3_auto_config_change.
 * @param[out]  dev      : Structure instance of bmi3_dev.
 *
 * @return Result of API execution status
 *
 * @return 0 -> Success
 * @return < 0 -> Fail
 *
 */
static int8_t get_alternate_auto_config(struct bmi3_auto_config_change *config, struct bmi3_dev *dev);

/*!
 * @brief This internal API sets alternate auto configurations for feature interrupts.
 *
 * @param[out] config    : Structure instance of bmi3_auto_config_change.
 * @param[in]  dev       : Structure instance of bmi3_dev.
 *
 * @return Result of API execution status
 *
 * @return 0 -> Success
 * @return < 0 -> Fail
 *
 */
static int8_t set_alternate_auto_config(const struct bmi3_auto_config_change *config, struct bmi3_dev *dev);

/*!
 * @brief This internal API is used to monitor the accel power mode during the axis remap.
 *
 * @param[in] config       : Structure instance of bmi3_sens_config.
 * @param[in] dev          : Structure instance of bmi3_dev.
 *
 * @return Result of API execution status
 *
 * @return 0 -> Success
 * @return < 0 -> Fail
 *
 */
static int8_t axes_remap_acc_power_mode_status(struct bmi3_sens_config config, struct bmi3_dev *dev);

/*!
 * @brief This internal API is used to verify the right position of the sensor before doing accel FOC
 *
 * @param[in] sens_list     : Sensor type
 * @param[in] accel_g_axis  : Accel Foc axis and sign input
 * @param[in] dev           : Structure instance of bmi3_dev
 *
 * @return Result of API execution status
 *
 * @return 0 -> Success
 * @return < 0 -> Fail
 */
static int8_t verify_foc_position(uint8_t sens_list,
                                  const struct bmi3_accel_foc_g_value *accel_g_axis,
                                  struct bmi3_dev *dev);

/*!
 * @brief This internal API reads and provides average for 128 samples of sensor data for accel FOC.
 *
 * @param[in] sens_list     : Sensor type.
 * @param[in] temp_foc_data : To store data samples
 * @param[in] dev           : Structure instance of bmi3_dev.
 *
 * @return Result of API execution status
 *
 * @return 0 -> Success
 * @return < 0 -> Fail
 */
static int8_t get_average_of_sensor_data(uint8_t sens_list,
                                         struct bmi3_foc_temp_value *temp_foc_data,
                                         struct bmi3_dev *dev);

/*!
 * @brief This internal API validates accel FOC position as per the range
 *
 * @param[in] sens_list     : Sensor type
 * @param[in] accel_g_axis  : Accel axis to FOC.
 * @param[in] avg_foc_data  : Average value of sensor sample datas
 * @param[in] dev           : Structure instance of bmi3_dev.
 *
 * @return Result of API execution status
 *
 * @return 0 -> Success
 * @return < 0 -> Fail
 */
static int8_t validate_foc_position(uint8_t sens_list,
                                    const struct bmi3_accel_foc_g_value *accel_g_axis,
                                    struct bmi3_sens_axes_data avg_foc_data,
                                    struct bmi3_dev *dev);

/*!
 * @brief This internal API validates accel FOC axis given as input
 *
 * @param[in] avg_foc_data : Average value of sensor sample datas
 * @param[in] dev          : Structure instance of bmi2_dev.
 *
 * @return Result of API execution status
 *
 * @return 0 -> Success
 * @return < 0 -> Fail
 */
static int8_t validate_foc_accel_axis(int16_t avg_foc_data, struct bmi3_dev *dev);

/*!
 * @brief This internal API sets configurations for performing accelerometer FOC.
 *
 * @param[in] dev       : Structure instance of bmi3_dev
 *
 * @return Result of API execution status
 *
 * @return 0 -> Success
 * @return < 0 -> Fail
 */
static int8_t set_accel_foc_config(struct bmi3_dev *dev);

/*!
 * @brief This internal API performs Fast Offset Compensation for accelerometer.
 *
 * @param[in] accel_g_value : This parameter selects the accel FOC
 * axis to be performed
 *
 * Input format is {x, y, z, sign}. '1' to enable. '0' to disable
 *
 * Eg: To choose x axis  {1, 0, 0, 0}
 * Eg: To choose -x axis {1, 0, 0, 1}
 *
 * @param[in] acc_cfg       : Accelerometer configuration value
 * @param[in] dev           : Structure instance of bmi3_dev.
 *
 * @return Result of API execution status
 *
 * @return 0 -> Success
 * @return < 0 -> Fail
 */
static int8_t perform_accel_foc(const struct bmi3_accel_foc_g_value *accel_g_value,
                                struct bmi3_accel_config *acc_cfg,
                                struct bmi3_dev *dev);

/*!
 * @brief This internal API converts the range value into accelerometer
 * corresponding integer value.
 *
 * @param[in] range_in      : Input range value.
 * @param[out] range_out    : Stores the integer value of range.
 *
 * @return None
 * @retval None
 */
static void map_accel_range(uint8_t range_in, uint8_t *range_out);

/*!
 * @brief This internal API compensate the accelerometer data against gravity.
 *
 * @param[in] lsb_per_g     : LSB value per 1g.
 * @param[in] g_val         : Gravity reference value of all axis.
 * @param[in] data          : Accelerometer data
 * @param[out] comp_data    : Stores the data that is compensated by taking the
 *                            difference in accelerometer data and lsb_per_g
 *                            value.
 *
 * @return None
 * @retval None
 */
static void comp_for_gravity(uint16_t lsb_per_g,
                             const struct bmi3_accel_foc_g_value *g_val,
                             const struct bmi3_sens_axes_data *data,
                             struct bmi3_offset_delta *comp_data);

/*!
 * @brief This internal API scales the compensated accelerometer data according
 * to the offset register resolution.
 *
 * @param[in] range         : Gravity range of the accelerometer.
 * @param[out] comp_data    : Data that is compensated by taking the
 *                            difference in accelerometer data and lsb_per_g
 *                            value.
 * @param[out] data         : Stores accel offset data
 * @param[in] dev           : Structure instance of bmi3_dev.
 *
 * @return None
 * @retval None
 */
static void scale_accel_offset(uint8_t range,
                               const struct bmi3_offset_delta *comp_data,
                               struct bmi3_acc_dp_gain_offset *data,
                               const struct bmi3_dev *dev);

/*!
 * @brief This internal API inverts the accelerometer offset data.
 *
 * @param[out] offset_data  : Stores the inverted offset data
 *
 * @return None
 * @retval None
 */
static void invert_accel_offset(struct bmi3_acc_dp_gain_offset *offset_data);

/*!
 * @brief This internal API is used to calculate the power of a value.
 *
 * @param[in] base          : Base for power calculation.
 * @param[in] resolution    : Exponent for power calculation.
 *
 * @return the calculated power
 * @retval the power value
 */
static int32_t power(int16_t base, uint8_t resolution);

/*!
 * @brief This internal API sets the individual gyroscope
 * filter coefficients in the respective dma registers.
 *
 * @param[in] dev          : Structure instance of bmi3_dev.
 *
 * @return Result of API execution status
 *
 * @return 0 -> Success
 * @return < 0 -> Fail
 *
 */
static int8_t set_gyro_filter_coefficients(struct bmi3_dev *dev);

/*!
 * @brief This internal API check the data index for the fifo
 * data processing.
 *
 * @param[in] data_index   : Variable for data index
 * @param[in] fifo         : Structure instance of fifo frame
 *
 * @return Result of API execution status
 *
 * @return 0 -> Success
 * @return < 0 -> Fail
 *
 */
static int8_t check_data_index(uint16_t data_index, const struct bmi3_fifo_frame *fifo);

/*!
 * @brief This internal API is used to validate ODR and AVG combinations for accel
 *
 * @param[in] acc_odr   : Variable to store accel ODR
 * @param[in] acc_avg   : Variable to store accel AVG
 *
 * @return Result of API execution status
 *
 * @return 0 -> Success
 * @return < 0 -> Fail
 *
 */
static int8_t validate_acc_odr_avg(uint8_t acc_odr, uint8_t acc_avg);

/*!
 * @brief This internal API is used to check skipped samples for accel
 *
 * @param[in] odr   : Variable to store accel ODR
 * @param[in] avg   : Variable to store accel AVG
 *
 * @return Result of API execution status
 *
 * @return 0 -> Success
 * @return < 0 -> Fail
 *
 */
static int8_t accel_skipped_samples_check(float odr, float avg);

/*!
 * @brief This internal API is used to validate ODR and AVG combinations for gyro
 *
 * @param[in] gyr_odr   : Variable to store gyro ODR
 * @param[in] gyr_avg   : Variable to store gyro AVG
 *
 * @return Result of API execution status
 *
 * @return 0 -> Success
 * @return < 0 -> Fail
 *
 */
static int8_t validate_gyr_odr_avg(uint8_t gyr_odr, uint8_t gyr_avg);

/*!
 * @brief This internal API is used to check skipped samples for gyro
 *
 * @param[in] odr   : Variable to store gyro ODR
 * @param[in] avg   : Variable to store gyro AVG
 *
 * @return Result of API execution status
 *
 * @return 0 -> Success
 * @return < 0 -> Fail
 *
 */
static int8_t gyro_skipped_samples_check(float odr, float avg);

/*!
 * @brief This internal API writes the command register value to enable cfg res.
 *
 * @param[in,out] dev       : Structure instance of bmi3_dev.
 *
 * @return Result of API execution status
 *
 * @return 0 -> Success
 * @return < 0 -> Fail
 *
 */
static int8_t config_array_set_command(struct bmi3_dev *dev);

/*!
 * @brief This internal API sets the value_one to feature engine in cfg res.
 *
 * @param[in,out] dev       : Structure instance of bmi3_dev.
 *
 * @return Result of API execution status
 *
 * @return 0 -> Success
 * @return < 0 -> Fail
 *
 */
static int8_t config_array_set_value_one_page(struct bmi3_dev *dev);

/*!
 * @brief This internal API writes the config array in cfg res.
 *
 * @param[in,out] dev       : Structure instance of bmi3_dev.
 *
 * @return Result of API execution status
 *
 * @return 0 -> Success
 * @return < 0 -> Fail
 *
 */
static int8_t write_config_array(struct bmi3_dev *dev);

/*!
 * @brief This internal API writes config array.
 *
 * @param[in] config_array  : Pointer variable to store config array.
 * @param[in] config_size   : Variable to store size of config array.
 * @param[in,out] dev       : Structure instance of bmi3_dev.
 *
 * @return Result of API execution status
 *
 * @return 0 -> Success
 * @return < 0 -> Fail
 *
 */
static int8_t load_config_array(const uint8_t *config_array, uint16_t config_size, struct bmi3_dev *dev);

/*!
 * @brief This internal API writes config array.
 *
 * @param[in] config_array  : Pointer variable to store config array.
 * @param[in] config_size   : Variable to store size of config array.
 * @param[in,out] dev       : Structure instance of bmi3_dev.
 *
 * @return Result of API execution status
 *
 * @return 0 -> Success
 * @return < 0 -> Fail
 *
 */
static int8_t upload_file(uint16_t config_base_addr, const uint8_t *config_array, uint16_t indx, struct bmi3_dev *dev);

/*!
 * @brief This internal API writes config version array to feature engine register.
 *
 * @param[in,out] dev       : Structure instance of bmi3_dev.
 *
 * @return Result of API execution status
 *
 * @return 0 -> Success
 * @return < 0 -> Fail
 *
 */
static int8_t write_config_version(struct bmi3_dev *dev);

/******************************************************************************/
/*!  @name      User Interface Definitions                            */
/******************************************************************************/

/*!
 * @brief This API is the entry point for bmi3 sensor. It reads and validates the
 * chip-id of the sensor.
 */
int8_t bmi3_init(struct bmi3_dev *dev)
{
    /* Variable to store result of API */
    int8_t rslt;

    /* Variable to assign chip id */
    uint8_t chip_id[2] = { 0 };

    /* Null-pointer check */
    rslt = null_ptr_check(dev);

    if (rslt == BMI3_OK)
    {
        dev->chip_id = 0;

        /* An extra dummy byte is read during SPI read */
        if (dev->intf == BMI3_SPI_INTF)
        {
            dev->dummy_byte = 1;
        }
        else
        {
            dev->dummy_byte = 2;
        }
    }

    if (rslt == BMI3_OK)
    {
        /* Perform soft-reset to bring all register values to their default values */
        rslt = bmi3_soft_reset(dev);

        if (rslt == BMI3_OK)
        {
            /* Read chip-id of the BMI3 sensor */
            rslt = bmi3_get_regs(BMI3_REG_CHIP_ID, chip_id, 2, dev);

            if (rslt == BMI3_OK)
            {
                dev->chip_id = chip_id[0];
            }
        }
    }

    if (rslt == BMI3_OK)
    {
        if (((chip_id[1] & BMI3_REV_ID_MASK) >> BMI3_REV_ID_POS) == BMI3_ENABLE)
        {
            dev->accel_bit_width = BMI3_ACC_DP_OFF_XYZ_14_BIT_MASK;
        }
        else
        {
            dev->accel_bit_width = BMI3_ACC_DP_OFF_XYZ_13_BIT_MASK;
        }
    }

    return rslt;
}

/*!
 * @brief This API reads the data from the given register address of bmi3
 * sensor.
 *
 * @note For most of the registers auto address increment applies, with the
 * exception of a few special registers, which trap the address. For e.g.,
 * Register address - 0x03.
 */
int8_t bmi3_get_regs(uint8_t reg_addr, uint8_t *data, uint16_t len, struct bmi3_dev *dev)
{
    /* Variable to store result of API */
    int8_t rslt;

    /* Variable to define temporary buffer */
    uint8_t temp_buf[BMI3_MAX_LEN];

    /* Variable to define loop */
    uint16_t index = 0;

    /* Null-pointer check */
    rslt = null_ptr_check(dev);

    if ((rslt == BMI3_OK) && (data != NULL))
    {
        /* Configuring reg_addr for SPI Interface */
        if (dev->intf == BMI3_SPI_INTF)
        {
            reg_addr = (reg_addr | BMI3_SPI_RD_MASK);
        }

        dev->intf_rslt = dev->read(reg_addr, temp_buf, len + dev->dummy_byte, dev->intf_ptr);
        dev->delay_us(2, dev->intf_ptr);

        if (dev->intf_rslt == BMI3_INTF_RET_SUCCESS)
        {
            /* Read the data from the position next to dummy byte */
            while (index < len)
            {
                data[index] = temp_buf[index + dev->dummy_byte];
                index++;
            }
        }
        else
        {
            rslt = BMI3_E_COM_FAIL;
        }
    }
    else
    {
        rslt = BMI3_E_NULL_PTR;
    }

    return rslt;
}

/*!
 * @brief This API writes data to the given register address of bmi3 sensor.
 */
int8_t bmi3_set_regs(uint8_t reg_addr, const uint8_t *data, uint16_t len, struct bmi3_dev *dev)
{
    /* Variable to store result of API */
    int8_t rslt;

    /* Null-pointer check */
    rslt = null_ptr_check(dev);

    if ((rslt == BMI3_OK) && (data != NULL))
    {
        /* Configuring reg_addr for SPI Interface */
        if (dev->intf == BMI3_SPI_INTF)
        {
            reg_addr = (reg_addr & BMI3_SPI_WR_MASK);
        }

        dev->intf_rslt = dev->write(reg_addr, data, len, dev->intf_ptr);
        dev->delay_us(2, dev->intf_ptr);

        if (dev->intf_rslt != BMI3_INTF_RET_SUCCESS)
        {
            rslt = BMI3_E_COM_FAIL;
        }
    }
    else
    {
        rslt = BMI3_E_NULL_PTR;
    }

    return rslt;
}

/*!
 * @brief This API resets bmi3 sensor. All registers are overwritten with
 * their default values.
 */
int8_t bmi3_soft_reset(struct bmi3_dev *dev)
{
    /* Variable to store result of API */
    int8_t rslt;

    /* Variable to read the dummy byte */
    uint8_t dummy_byte[2] = { 0 };

    /* Variable to store feature data array */
    uint8_t feature_data[2] = { 0x2c, 0x01 };

    /* Variable to enable feature engine bit */
    uint8_t feature_engine_en[2] = { BMI3_ENABLE, 0 };

    /* Variable to store status value for feature engine enable */
    uint8_t reg_data[2] = { 0 };

    /* Array variable to store feature IO status */
    uint8_t feature_io_status[2] = { BMI3_ENABLE, 0 };

    uint8_t loop = 1;

    /* Null-pointer check */
    rslt = null_ptr_check(dev);

    if (rslt == BMI3_OK)
    {
        /* Reset bmi3 device */
        rslt = bmi3_set_command_register(BMI3_CMD_SOFT_RESET, dev);
        dev->delay_us(BMI3_SOFT_RESET_DELAY, dev->intf_ptr);

        /* Performing a dummy read after a soft-reset */
        if ((rslt == BMI3_OK) && (dev->intf == BMI3_SPI_INTF))
        {
            rslt = bmi3_get_regs(BMI3_REG_CHIP_ID, dummy_byte, 2, dev);
        }

        /* Enabling Feature engine */
        if (rslt == BMI3_OK)
        {
            rslt = bmi3_set_regs(BMI3_REG_FEATURE_IO2, feature_data, 2, dev);
        }

        if (rslt == BMI3_OK)
        {
            // Enabling feature status bit
            rslt = bmi3_set_regs(BMI3_REG_FEATURE_IO_STATUS, feature_io_status, 2, dev);
        }

        if (rslt == BMI3_OK)
        {
            // Enable feature engine bit
            rslt = bmi3_set_regs(BMI3_REG_FEATURE_CTRL, feature_engine_en, 2, dev);
        }

        if (rslt == BMI3_OK)
        {
            // Checking the status bit for feature engine enable
            while (loop <= 10)
            {
                dev->delay_us(100000, dev->intf_ptr);

                rslt = bmi3_get_regs(BMI3_REG_FEATURE_IO1, reg_data, 2, dev);

                if (rslt == BMI3_OK)
                {
                    if (reg_data[0] & BMI3_FEATURE_ENGINE_ENABLE_MASK)
                    {
                        rslt = BMI3_OK;

                        break;
                    }
                    else
                    {
                        rslt = BMI3_E_FEATURE_ENGINE_STATUS;
                    }
                }

                loop++;
            }
        }
    }

    return rslt;
}

/*!
 * @brief This API writes the available sensor specific commands to the sensor.
 */
int8_t bmi3_set_command_register(uint16_t command, struct bmi3_dev *dev)
{
    /* Variable to store result of API */
    int8_t rslt;

    /* Array variable to store command value */
    uint8_t reg_data[2] = { 0 };

    reg_data[0] = (uint8_t)(command & BMI3_SET_LOW_BYTE);
    reg_data[1] = (uint8_t)((command & BMI3_SET_HIGH_BYTE) >> 8);

    /* Set the command in the command register */
    rslt = bmi3_set_regs(BMI3_REG_CMD, reg_data, 2, dev);

    return rslt;
}

/*!
 * @brief This API gets the interrupt 1 status of both feature and data
 * interrupts
 */
int8_t bmi3_get_int1_status(uint16_t *int_status, struct bmi3_dev *dev)
{
    /* Variable to store result of API */
    int8_t rslt;

    /* Array to store data */
    uint8_t data_array[2] = { 0 };

    if (int_status != NULL)
    {
        /* Get the interrupt status */
        rslt = bmi3_get_regs(BMI3_REG_INT_STATUS_INT1, data_array, 2, dev);

        if (rslt == BMI3_OK)
        {
            *int_status = (uint16_t)(data_array[0] | ((uint16_t)data_array[1] << 8));
        }
    }
    else
    {
        rslt = BMI3_E_NULL_PTR;
    }

    return rslt;
}

/*!
 * @brief This API gets the interrupt 2 status of both feature and data
 * interrupts
 */
int8_t bmi3_get_int2_status(uint16_t *int_status, struct bmi3_dev *dev)
{
    /* Variable to store result of API */
    int8_t rslt;

    /* Array to store data */
    uint8_t data_array[2] = { 0 };

    if (int_status != NULL)
    {
        /* Get the interrupt status */
        rslt = bmi3_get_regs(BMI3_REG_INT_STATUS_INT2, data_array, 2, dev);

        if (rslt == BMI3_OK)
        {
            *int_status = (uint16_t)(data_array[0] | ((uint16_t)data_array[1] << 8));
        }
    }
    else
    {
        rslt = BMI3_E_NULL_PTR;
    }

    return rslt;
}

/*!
 * @brief This API gets the re-mapped x, y and z axes from the sensor and
 * updates the values in the device structure.
 *
 * @note: XYZ axis denotes x = x, y = y, z = z
 * Similarly,
 *    YXZ, x = y, y = x, z = z
 *
 */
int8_t bmi3_get_remap_axes(struct bmi3_axes_remap *remapped_axis, struct bmi3_dev *dev)
{
    /* Variable to store result of API */
    int8_t rslt;

    /* Array variable to get remapped axis data */
    uint8_t remap_data[4];

    /* Array variable to store base address of remap axis data */
    uint8_t base_addr[2] = { BMI3_BASE_ADDR_AXIS_REMAP, 0 };

    /* Variable to store axis remap data */
    uint8_t reg_data;

    if (remapped_axis != NULL)
    {
        /* Set the configuration to feature engine register */
        rslt = bmi3_set_regs(BMI3_REG_FEATURE_DATA_ADDR, base_addr, 2, dev);

        if (rslt == BMI3_OK)
        {
            /* Get the configuration from the feature engine register where axis
             * re-mapping feature resides
             */
            rslt = bmi3_get_regs(BMI3_REG_FEATURE_DATA_TX, remap_data, 4, dev);

            if (rslt == BMI3_OK)
            {
                reg_data = remap_data[0];

                /* Get the re-mapped axis */
                remapped_axis->axis_map = BMI3_GET_BIT_POS0(reg_data, BMI3_XYZ_AXIS);

                /* Get the re-mapped x-axis polarity */
                remapped_axis->invert_x = BMI3_GET_BITS(reg_data, BMI3_X_AXIS_SIGN);

                /* Get the re-mapped y-axis polarity */
                remapped_axis->invert_y = BMI3_GET_BITS(reg_data, BMI3_Y_AXIS_SIGN);

                /* Get the re-mapped z-axis polarity */
                remapped_axis->invert_z = BMI3_GET_BITS(reg_data, BMI3_Z_AXIS_SIGN);
            }
        }
    }
    else
    {
        rslt = BMI3_E_NULL_PTR;
    }

    return rslt;
}

/*!
 * @brief This API sets the re-mapped x, y and z axes to the sensor and
 * updates them in the device structure.
 */
int8_t bmi3_set_remap_axes(const struct bmi3_axes_remap remapped_axis, struct bmi3_dev *dev)
{
    /* Variable to store result of API */
    int8_t rslt;

    /* Structure instance of sensor config */
    struct bmi3_sens_config config = { 0 };

    /* Variable to set the re-mapped axes in the sensor */
    uint8_t axis_map;

    /* Variable to set the re-mapped x-axes sign in the sensor */
    uint8_t invert_x;

    /* Variable to set the re-mapped y-axes sign in the sensor */
    uint8_t invert_y;

    /* Variable to set the re-mapped z-axes sign in the sensor */
    uint8_t invert_z;

    /* Variable to define the register address */
    uint8_t base_addr[2] = { BMI3_BASE_ADDR_AXIS_REMAP, 0 };

    /* Array variable to get remapped axis data */
    uint8_t remap_data[4];

    /* Set the configuration to feature engine register */
    rslt = bmi3_set_regs(BMI3_REG_FEATURE_DATA_ADDR, base_addr, 2, dev);

    if (rslt == BMI3_OK)
    {
        /* Set the value of re-mapped axis */
        axis_map = remapped_axis.axis_map & BMI3_XYZ_AXIS_MASK;

        /* Set the value of re-mapped x-axis sign */
        invert_x = ((remapped_axis.invert_x << BMI3_X_AXIS_SIGN_POS) & BMI3_X_AXIS_SIGN_MASK);

        /* Set the value of re-mapped y-axis sign */
        invert_y = ((remapped_axis.invert_y << BMI3_Y_AXIS_SIGN_POS) & BMI3_Y_AXIS_SIGN_MASK);

        /* Set the value of re-mapped z-axis sign */
        invert_z = ((remapped_axis.invert_z << BMI3_Z_AXIS_SIGN_POS) & BMI3_Z_AXIS_SIGN_MASK);

        remap_data[0] = (axis_map | invert_x | invert_y | invert_z);

        /* Set the configuration back to the page */
        rslt = bmi3_set_regs(BMI3_REG_FEATURE_DATA_TX, remap_data, 2, dev);

        if (rslt == BMI3_OK)
        {
            rslt = axes_remap_acc_power_mode_status(config, dev);
        }
    }

    return rslt;
}

/*!
 * @brief This API sets the sensor/feature configuration.
 */
int8_t bmi3_set_sensor_config(struct bmi3_sens_config *sens_cfg, uint8_t n_sens, struct bmi3_dev *dev)
{
    /* Variable to store result of API */
    int8_t rslt;

    /* Variable to define loop */
    uint8_t loop;

    /* Null-pointer check */
    rslt = null_ptr_check(dev);

    if ((rslt == BMI3_OK) && (sens_cfg != NULL))
    {
        for (loop = 0; loop < n_sens; loop++)
        {
            switch (sens_cfg[loop].type)
            {
                case BMI3_ACCEL:
                    rslt = set_accel_config(&sens_cfg[loop].cfg.acc, dev);
                    break;

                case BMI3_GYRO:
                    rslt = set_gyro_config(&sens_cfg[loop].cfg.gyr, dev);
                    break;

                case BMI3_ANY_MOTION:
                    rslt = set_any_motion_config(&sens_cfg[loop].cfg.any_motion, dev);
                    break;

                case BMI3_NO_MOTION:
                    rslt = set_no_motion_config(&sens_cfg[loop].cfg.no_motion, dev);
                    break;

                case BMI3_SIG_MOTION:
                    rslt = set_sig_motion_config(&sens_cfg[loop].cfg.sig_motion, dev);
                    break;

                case BMI3_FLAT:
                    rslt = set_flat_config(&sens_cfg[loop].cfg.flat, dev);
                    break;

                case BMI3_TILT:
                    rslt = set_tilt_config(&sens_cfg[loop].cfg.tilt, dev);
                    break;

                case BMI3_ORIENTATION:
                    rslt = set_orientation_config(&sens_cfg[loop].cfg.orientation, dev);
                    break;

                case BMI3_STEP_COUNTER:
                    rslt = set_step_config(&sens_cfg[loop].cfg.step_counter, dev);
                    break;

                case BMI3_TAP:
                    rslt = set_tap_config(&sens_cfg[loop].cfg.tap, dev);
                    break;

                case BMI3_ALT_ACCEL:
                    rslt = set_alternate_accel_config(&sens_cfg[loop].cfg.alt_acc, dev);
                    break;

                case BMI3_ALT_GYRO:
                    rslt = set_alternate_gyro_config(&sens_cfg[loop].cfg.alt_gyr, dev);
                    break;

                case BMI3_ALT_AUTO_CONFIG:
                    rslt = set_alternate_auto_config(&sens_cfg[loop].cfg.alt_auto_cfg, dev);
                    break;

                default:
                    rslt = BMI3_E_INVALID_SENSOR;
                    break;
            }
        }
    }
    else
    {
        rslt = BMI3_E_NULL_PTR;
    }

    return rslt;
}

/*!
 * @brief This API gets the sensor/feature configuration.
 */
int8_t bmi3_get_sensor_config(struct bmi3_sens_config *sens_cfg, uint8_t n_sens, struct bmi3_dev *dev)
{
    /* Variable to store result of API */
    int8_t rslt;

    /* Variable to define loop */
    uint8_t loop = 0;

    /* Null-pointer check */
    rslt = null_ptr_check(dev);

    if ((rslt == BMI3_OK) && (sens_cfg != NULL))
    {
        for (loop = 0; loop < n_sens; loop++)
        {
            switch (sens_cfg[loop].type)
            {
                case BMI3_ACCEL:
                    rslt = get_accel_config(&sens_cfg[loop].cfg.acc, dev);
                    break;

                case BMI3_GYRO:
                    rslt = get_gyro_config(&sens_cfg[loop].cfg.gyr, dev);
                    break;

                case BMI3_ANY_MOTION:
                    rslt = get_any_motion_config(&sens_cfg[loop].cfg.any_motion, dev);
                    break;

                case BMI3_NO_MOTION:
                    rslt = get_no_motion_config(&sens_cfg[loop].cfg.no_motion, dev);
                    break;

                case BMI3_SIG_MOTION:
                    rslt = get_sig_motion_config(&sens_cfg[loop].cfg.sig_motion, dev);
                    break;

                case BMI3_FLAT:
                    rslt = get_flat_config(&sens_cfg[loop].cfg.flat, dev);
                    break;

                case BMI3_TILT:
                    rslt = get_tilt_config(&sens_cfg[loop].cfg.tilt, dev);
                    break;

                case BMI3_ORIENTATION:
                    rslt = get_orientation_config(&sens_cfg[loop].cfg.orientation, dev);
                    break;

                case BMI3_STEP_COUNTER:
                    rslt = get_step_config(&sens_cfg[loop].cfg.step_counter, dev);
                    break;

                case BMI3_TAP:
                    rslt = get_tap_config(&sens_cfg[loop].cfg.tap, dev);
                    break;

                case BMI3_ALT_ACCEL:
                    rslt = get_alternate_accel_config(&sens_cfg[loop].cfg.alt_acc, dev);
                    break;

                case BMI3_ALT_GYRO:
                    rslt = get_alternate_gyro_config(&sens_cfg[loop].cfg.alt_gyr, dev);
                    break;

                case BMI3_ALT_AUTO_CONFIG:
                    rslt = get_alternate_auto_config(&sens_cfg[loop].cfg.alt_auto_cfg, dev);
                    break;

                default:
                    rslt = BMI3_E_INVALID_SENSOR;
                    break;
            }
        }
    }
    else
    {
        rslt = BMI3_E_NULL_PTR;
    }

    return rslt;
}

/*!
 * @brief This API maps/un-maps data interrupts to that of interrupt pins.
 */
int8_t bmi3_map_interrupt(struct bmi3_map_int map_int, struct bmi3_dev *dev)
{
    /* Variable to store result of API */
    int8_t rslt;

    /* Variable to store register data */
    uint8_t reg_data[4] = { 0 };

    uint16_t no_motion_out, any_motion_out, flat_out, orientation_out, step_detector_out, step_counter_out,
             sig_motion_out, tilt_out;
    uint16_t tap_out, i3c_out, err_status, temp, gyr, acc, fwm, ffull;

    /* Read interrupt map1 and map2 and register */
    rslt = bmi3_get_regs(BMI3_REG_INT_MAP1, reg_data, 4, dev);

    if (rslt == BMI3_OK)
    {
        no_motion_out =
            (BMI3_SET_BIT_POS0(reg_data[0], BMI3_NO_MOTION_OUT, map_int.no_motion_out) & BMI3_NO_MOTION_OUT_MASK);
        any_motion_out =
            (BMI3_SET_BITS(reg_data[0], BMI3_ANY_MOTION_OUT, map_int.any_motion_out) & BMI3_ANY_MOTION_OUT_MASK);
        flat_out = (BMI3_SET_BITS(reg_data[0], BMI3_FLAT_OUT, map_int.flat_out) & BMI3_FLAT_OUT_MASK);
        orientation_out =
            (BMI3_SET_BITS(reg_data[0], BMI3_ORIENTATION_OUT, map_int.orientation_out) & BMI3_ORIENTATION_OUT_MASK);
        step_detector_out =
            (BMI3_SET_BITS(reg_data[1], BMI3_STEP_DETECTOR_OUT,
                           map_int.step_detector_out) & BMI3_STEP_DETECTOR_OUT_MASK);
        step_counter_out =
            (BMI3_SET_BITS(reg_data[1], BMI3_STEP_COUNTER_OUT, map_int.step_counter_out) & BMI3_STEP_COUNTER_OUT_MASK);
        sig_motion_out =
            (BMI3_SET_BITS(reg_data[1], BMI3_SIG_MOTION_OUT, map_int.sig_motion_out) & BMI3_SIG_MOTION_OUT_MASK);
        tilt_out = (BMI3_SET_BITS(reg_data[1], BMI3_TILT_OUT, map_int.tilt_out) & BMI3_TILT_OUT_MASK);

        reg_data[0] = (uint8_t)(no_motion_out | any_motion_out | flat_out | orientation_out);
        reg_data[1] = (uint8_t)((step_detector_out | step_counter_out | sig_motion_out | tilt_out) >> 8);

        tap_out = (BMI3_SET_BIT_POS0(reg_data[2], BMI3_TAP_OUT, map_int.tap_out) & BMI3_TAP_OUT_MASK);
        i3c_out = (BMI3_SET_BITS(reg_data[2], BMI3_I3C_OUT, map_int.i3c_out) & BMI3_I3C_OUT_MASK);
        err_status = (BMI3_SET_BITS(reg_data[2], BMI3_ERR_STATUS, map_int.err_status) & BMI3_ERR_STATUS_MASK);
        temp = (BMI3_SET_BITS(reg_data[2], BMI3_TEMP_DRDY_INT, map_int.temp_drdy_int) & BMI3_TEMP_DRDY_INT_MASK);
        gyr = (BMI3_SET_BITS(reg_data[3], BMI3_GYR_DRDY_INT, map_int.gyr_drdy_int) & BMI3_GYR_DRDY_INT_MASK);
        acc = (BMI3_SET_BITS(reg_data[3], BMI3_ACC_DRDY_INT, map_int.acc_drdy_int) & BMI3_ACC_DRDY_INT_MASK);
        fwm =
            (BMI3_SET_BITS(reg_data[3], BMI3_FIFO_WATERMARK_INT,
                           map_int.fifo_watermark_int) & BMI3_FIFO_WATERMARK_INT_MASK);
        ffull = (BMI3_SET_BITS(reg_data[3], BMI3_FIFO_FULL_INT, map_int.fifo_full_int) & BMI3_FIFO_FULL_INT_MASK);

        reg_data[2] = (uint8_t)(tap_out | i3c_out | err_status | temp);
        reg_data[3] = (uint8_t)((gyr | acc | fwm | ffull) >> 8);

        rslt = bmi3_set_regs(BMI3_REG_INT_MAP1, reg_data, 4, dev);
    }

    return rslt;
}

/*!
 * @brief This API selects the sensors/features to be enabled or disabled.
 */
int8_t bmi3_select_sensor(struct bmi3_feature_enable *enable, struct bmi3_dev *dev)
{
    /* Variable to store result of API */
    int8_t rslt;

    if (enable != NULL)
    {
        rslt = set_feature_enable(enable, dev);

        if (rslt == BMI3_OK)
        {
            rslt = get_feature_enable(enable, dev);
        }
    }
    else
    {
        rslt = BMI3_E_NULL_PTR;
    }

    return rslt;
}

/*!
 * @brief This API gets the sensor/feature data for accelerometer, gyroscope,
 * step counter, orientation, i3c sync accel, i3c sync gyro and i3c sync temperature.
 */
int8_t bmi3_get_sensor_data(struct bmi3_sensor_data *sensor_data, uint8_t n_sens, struct bmi3_dev *dev)
{
    /* Variable to store result of API */
    int8_t rslt;

    /* Variable to define loop */
    uint8_t loop;

    /* Null-pointer check */
    rslt = null_ptr_check(dev);

    if ((rslt == BMI3_OK) && (sensor_data != NULL))
    {
        for (loop = 0; loop < n_sens; loop++)
        {
            switch (sensor_data[loop].type)
            {
                case BMI3_ACCEL:
                    rslt = get_accel_sensor_data(&sensor_data[loop].sens_data.acc, BMI3_REG_ACC_DATA_X, dev);
                    break;

                case BMI3_GYRO:
                    rslt = get_gyro_sensor_data(&sensor_data[loop].sens_data.gyr, BMI3_REG_GYR_DATA_X, dev);
                    break;

                case BMI3_STEP_COUNTER:
                    rslt = get_step_counter_sensor_data(&sensor_data[loop].sens_data.step_counter_output,
                                                        BMI3_REG_FEATURE_IO2,
                                                        dev);
                    break;

                case BMI3_ORIENTATION:
                    rslt = get_orient_output_data(&sensor_data[loop].sens_data.orient_output,
                                                  BMI3_REG_FEATURE_EVENT_EXT,
                                                  dev);
                    break;

                case BMI3_I3C_SYNC_ACCEL:
                    rslt = get_i3c_sync_accel_sensor_data(&sensor_data[loop].sens_data.i3c_sync, dev);
                    break;

                case BMI3_I3C_SYNC_GYRO:
                    rslt = get_i3c_sync_gyro_sensor_data(&sensor_data[loop].sens_data.i3c_sync, dev);
                    break;

                case BMI3_I3C_SYNC_TEMP:
                    rslt = get_i3c_sync_temp_data(&sensor_data[loop].sens_data.i3c_sync, dev);
                    break;

                default:
                    rslt = BMI3_E_INVALID_SENSOR;
                    break;
            }

            /* Return error if any of the get sensor data fails */
            if (rslt != BMI3_OK)
            {
                break;
            }
        }
    }
    else
    {
        rslt = BMI3_E_NULL_PTR;
    }

    return rslt;
}

/*!
 *  @brief This API reads the error status from the sensor.
 */
int8_t bmi3_get_error_status(struct bmi3_err_reg *err_reg, struct bmi3_dev *dev)
{
    /* Variable to store result of API */
    int8_t rslt;

    /* Array variable to get error status from register */
    uint8_t data[2] = { 0 };

    uint16_t reg_data;

    if (err_reg != NULL)
    {
        /* Read the error codes */
        rslt = bmi3_get_regs(BMI3_REG_ERR_REG, data, 2, dev);

        if (rslt == BMI3_OK)
        {
            reg_data = data[0];

            /* Fatal error */
            err_reg->fatal_err = BMI3_GET_BIT_POS0(reg_data, BMI3_FATAL_ERR);

            /* Interrupt request overrun error */
            err_reg->feat_eng_ovrld = BMI3_GET_BITS(reg_data, BMI3_FEAT_ENG_OVRLD);

            /* Indicates watch cell code */
            err_reg->feat_eng_wd = BMI3_GET_BITS(reg_data, BMI3_FEAT_ENG_WD);

            /* Indicates accel configuration error */
            err_reg->acc_conf_err = BMI3_GET_BITS(reg_data, BMI3_ACC_CONF_ERR);

            /* Indicates gyro configuration error */
            err_reg->gyr_conf_err = BMI3_GET_BITS(reg_data, BMI3_GYR_CONF_ERR);

            reg_data = data[1];

            /* Indicates SDR parity error */
            err_reg->i3c_error0 = BMI3_GET_BITS(reg_data, BMI3_I3C_ERROR0);

            /* Indicates I3C error */
            err_reg->i3c_error3 = BMI3_GET_BITS(reg_data, BMI3_I3C_ERROR3);
        }
    }
    else
    {
        rslt = BMI3_E_NULL_PTR;
    }

    return rslt;
}

/*!
 *  @brief This API reads the feature engine error status from the sensor.
 */
int8_t bmi3_get_feature_engine_error_status(uint8_t *feature_engine_err_reg_lsb,
                                            uint8_t *feature_engine_err_reg_msb,
                                            struct bmi3_dev *dev)
{
    /* Variable to store result of API */
    int8_t rslt;

    /* Array variable to get error status from register */
    uint8_t data[2];

    if ((feature_engine_err_reg_lsb != NULL) && (feature_engine_err_reg_msb != NULL))
    {
        /* Read the feature engine error codes */
        rslt = bmi3_get_regs(BMI3_REG_FEATURE_IO1, data, 2, dev);

        if (rslt == BMI3_OK)
        {
            *feature_engine_err_reg_lsb = data[0];

            *feature_engine_err_reg_msb = data[1];
        }
    }
    else
    {
        rslt = BMI3_E_NULL_PTR;
    }

    return rslt;
}

/*!
 * @brief This API sets:
 *        1) The output configuration of the selected interrupt pin:
 *           INT1 or INT2.
 *        2) The interrupt mode: permanently latched or non-latched.
 */
int8_t bmi3_set_int_pin_config(const struct bmi3_int_pin_config *int_cfg, struct bmi3_dev *dev)
{
    /* Variable to store result of API */
    int8_t rslt;

    /* Variable to define data array */
    uint8_t data_array[3] = { 0 };

    /* Variable to store register data */
    uint16_t reg_data = 0;

    /* Variable to define type of interrupt pin  */
    uint8_t int_pin = 0;

    uint16_t lvl, od, output_en;

    /* Null-pointer check */
    rslt = null_ptr_check(dev);

    if ((rslt == BMI3_OK) && (int_cfg != NULL))
    {
        /* Copy the pin type to a local variable */
        int_pin = int_cfg->pin_type;

        if ((int_pin > BMI3_INT_NONE) && (int_pin < BMI3_INT_PIN_MAX))
        {
            /* Get the previous configuration data */
            rslt = bmi3_get_regs(BMI3_REG_IO_INT_CTRL, data_array, 2, dev);

            if (rslt == BMI3_OK)
            {
                /* Set interrupt pin 1 configuration */
                if (int_pin == BMI3_INT1)
                {
                    reg_data = data_array[0];

                    /* Configure active low or high */
                    lvl = BMI3_SET_BIT_POS0(reg_data, BMI3_INT1_LVL, int_cfg->pin_cfg[0].lvl);

                    /* Configure push-pull or open drain */
                    od = BMI3_SET_BITS(reg_data, BMI3_INT1_OD, int_cfg->pin_cfg[0].od);

                    /* Configure output enable */
                    output_en = BMI3_SET_BITS(reg_data, BMI3_INT1_OUTPUT_EN, int_cfg->pin_cfg[0].output_en);

                    /* Copy the data to be written in the respective array */
                    data_array[0] = (uint8_t)(lvl | od | output_en);
                }

                /* Set interrupt pin 2 configuration */
                if (int_pin == BMI3_INT2)
                {
                    reg_data = ((uint16_t)data_array[1] << 8);

                    /* Configure active low or high */
                    lvl = BMI3_SET_BITS(reg_data, BMI3_INT2_LVL, int_cfg->pin_cfg[1].lvl);

                    /* Configure push-pull or open drain */
                    od = BMI3_SET_BITS(reg_data, BMI3_INT2_OD, int_cfg->pin_cfg[1].od);

                    /* Configure output enable */
                    output_en = BMI3_SET_BITS(reg_data, BMI3_INT2_OUTPUT_EN, int_cfg->pin_cfg[1].output_en);

                    /* Copy the data to be written in the respective array */
                    data_array[1] = (uint8_t)((lvl | od | output_en) >> 8);
                }

                /* Set the configurations simultaneously as
                 * INT1_IO_CTRL, INT2_IO_CTRL, and INT_LATCH lie
                 * in consecutive addresses
                 */
                rslt = bmi3_set_regs(BMI3_REG_IO_INT_CTRL, data_array, 2, dev);

                if (rslt == BMI3_OK)
                {
                    rslt = set_latch_mode(int_cfg, dev);
                }
            }
        }
        else
        {
            rslt = BMI3_E_INVALID_INT_PIN;
        }
    }
    else
    {
        rslt = BMI3_E_NULL_PTR;
    }

    return rslt;
}

/*!
 * @brief This API gets:
 *        1) The output configuration of the selected interrupt pin:
 *           INT1 or INT2.
 *        2) The interrupt mode: permanently latched or non-latched.
 */
int8_t bmi3_get_int_pin_config(struct bmi3_int_pin_config *int_cfg, struct bmi3_dev *dev)
{
    /* Variable to store result of API */
    int8_t rslt;

    /* Variable to define data array */
    uint8_t data_array[3] = { 0 };

    /* Variable to define type of interrupt pin  */
    uint8_t int_pin = 0;

    uint16_t reg_data;

    if (int_cfg != NULL)
    {
        /* Copy the pin type to a local variable */
        int_pin = int_cfg->pin_type;

        /* Get the previous configuration data */
        rslt = bmi3_get_regs(BMI3_REG_IO_INT_CTRL, data_array, 3, dev);

        if (rslt == BMI3_OK)
        {
            /* Get interrupt pin 1 configuration */
            if (int_pin == BMI3_INT1)
            {
                /* Get active low or high */
                int_cfg->pin_cfg[0].lvl = BMI3_GET_BIT_POS0(data_array[0], BMI3_INT1_LVL);

                /* Get push-pull or open drain */
                int_cfg->pin_cfg[0].od = BMI3_GET_BITS(data_array[0], BMI3_INT1_OD);

                /* Get output enable */
                int_cfg->pin_cfg[0].output_en = BMI3_GET_BITS(data_array[0], BMI3_INT1_OUTPUT_EN);
            }

            /* Get interrupt pin 2 configuration */
            if (int_pin == BMI3_INT2)
            {
                reg_data = ((uint16_t)data_array[1] << 8);

                /* Get active low or high */
                int_cfg->pin_cfg[1].lvl = BMI3_GET_BITS(reg_data, BMI3_INT2_LVL);

                /* Get push-pull or open drain */
                int_cfg->pin_cfg[1].od = BMI3_GET_BITS(reg_data, BMI3_INT2_OD);

                /* Get output enable */
                int_cfg->pin_cfg[1].output_en = BMI3_GET_BITS(reg_data, BMI3_INT2_OUTPUT_EN);
            }

            rslt = get_latch_mode(int_cfg, dev);
        }
    }
    else
    {
        rslt = BMI3_E_NULL_PTR;
    }

    return rslt;
}

/*!
 * @brief This API is used to get the sensor time.
 */
int8_t bmi3_get_sensor_time(uint32_t *sensor_time, struct bmi3_dev *dev)
{
    /* Variable to store result of API */
    int8_t rslt;

    uint8_t reg_data[4] = { 0 };

    if (sensor_time != NULL)
    {
        rslt = bmi3_get_regs(BMI3_REG_SENSOR_TIME_0, reg_data, 4, dev);
        if (rslt == BMI3_OK)
        {
            *sensor_time =
                (uint32_t)(reg_data[0] | (uint32_t)reg_data[1] << 8 | (uint32_t)reg_data[2] << 16 |
                           (uint32_t)reg_data[3] <<
                    24);
        }
    }
    else
    {
        rslt = BMI3_E_NULL_PTR;
    }

    return rslt;
}

/*!
 * @brief This API reads the raw temperature data from the register and can be
 * converted into degree celsius.
 */
int8_t bmi3_get_temperature_data(uint16_t *temp_data, struct bmi3_dev *dev)
{
    /* Variable to store result of API */
    int8_t rslt;

    /* Array to define data stored in register */
    uint8_t reg_data[2] = { 0 };

    if (temp_data != NULL)
    {
        /* Read the sensor data */
        rslt = bmi3_get_regs(BMI3_REG_TEMP_DATA, reg_data, 2, dev);

        if (rslt == BMI3_OK)
        {
            *temp_data = (uint16_t)(reg_data[0] | ((uint16_t)reg_data[1] << 8));
        }
    }
    else
    {
        rslt = BMI3_E_NULL_PTR;
    }

    return rslt;
}

/*!
 * @brief This API reads the FIFO data.
 */
int8_t bmi3_read_fifo_data(struct bmi3_fifo_frame *fifo, struct bmi3_dev *dev)
{
    /* Variable to store result of API */
    int8_t rslt;

    /* Array to store FIFO configuration data */
    uint8_t config_data[2] = { 0 };

    /* Variable to store FIFO data address */
    uint8_t reg_addr = BMI3_REG_FIFO_DATA;

    /* Null-pointer check */
    if (fifo != NULL)
    {
        /* Get the set FIFO frame configurations */
        rslt = bmi3_get_regs(BMI3_REG_FIFO_CONF, config_data, 2, dev);

        if (rslt == BMI3_OK)
        {
            /* Get sensor enable status, of which the data is to be read */
            fifo->available_fifo_sens =
                (uint16_t)(((config_data[0]) | ((uint16_t) config_data[1] << 8)) & BMI3_FIFO_ALL_EN);

            if (fifo->length != 0)
            {
                /* Read FIFO data */
                if (dev->intf == BMI3_SPI_INTF)
                {
                    reg_addr = (reg_addr | BMI3_SPI_RD_MASK);
                }

                rslt = dev->read(reg_addr, fifo->data, (uint32_t)fifo->length, dev->intf_ptr);
            }
            else
            {
                rslt = BMI3_E_COM_FAIL;
            }
        }
    }
    else
    {
        rslt = BMI3_E_NULL_PTR;
    }

    return rslt;
}

/*!
 * @brief This API parses and extracts the accelerometer frames from FIFO data
 * read by the "bmi3_read_fifo_data" API and stores it in the "accel_data"
 * structure instance.
 */
int8_t bmi3_extract_accel(struct bmi3_fifo_sens_axes_data *accel_data,
                          struct bmi3_fifo_frame *fifo,
                          const struct bmi3_dev *dev)
{
    /* Variable to store result of API */
    int8_t rslt;

    /* Variable to index the bytes */
    uint16_t data_index = 0;

    /* Variable to index accelerometer frames */
    uint16_t accel_index = 0;

    /* Variable to define the data enable byte */
    uint16_t data_enable = 0;

    rslt = null_ptr_check(dev);

    /* Null-pointer check */
    if ((rslt == BMI3_OK) && (accel_data != NULL) && (fifo != NULL))
    {
        data_index = dev->dummy_byte;

        /* Convert word to byte since all sensor enables are in a byte */
        data_enable = fifo->available_fifo_sens & BMI3_FIFO_HEAD_LESS_ACC_FRM;

        for (; (data_index < fifo->length);)
        {
            rslt = check_data_index(data_index, fifo);

            if (rslt == BMI3_OK)
            {
                /* Unpack frame to get the accelerometer data */
                rslt = unpack_fifo_data_frame(accel_data, &data_index, &accel_index, data_enable, fifo);
            }

            if (rslt != BMI3_W_PARTIAL_READ)
            {
                if (fifo->available_fifo_sens == BMI3_FIFO_HEAD_LESS_ACC_FRM)
                {
                    data_index = data_index + BMI3_LENGTH_FIFO_ACC;
                }

                /* If gyro enable with the accel, increment the accel index by 6
                 * since gyro frame has 6 bytes of data
                 */
                if (fifo->available_fifo_sens & BMI3_FIFO_HEAD_LESS_GYR_FRM)
                {
                    data_index = data_index + BMI3_LENGTH_FIFO_GYR;
                }

                /* If sensor time enable with the accel, increment the accel index by 2
                 * since sensor time frame has 2 bytes of data
                 */
                if (fifo->available_fifo_sens & BMI3_FIFO_HEAD_LESS_SENS_TIME_FRM)
                {
                    data_index = data_index + BMI3_LENGTH_SENSOR_TIME;
                }

                /* If temperature enable with the accel, increment the accel index by 2
                 * since temperature frame has 2 bytes of data
                 */
                if (fifo->available_fifo_sens & BMI3_FIFO_HEAD_LESS_TEMP_FRM)
                {
                    data_index = data_index + BMI3_LENGTH_TEMPERATURE;
                }
            }
        }

        /* Update number of accelerometer frames to be read */
        (fifo->avail_fifo_accel_frames) = accel_index;

        if (fifo->avail_fifo_accel_frames != 0)
        {
            rslt = BMI3_OK;
        }
    }
    else
    {
        rslt = BMI3_E_NULL_PTR;
    }

    return rslt;
}

/*!
 * @brief This API parses and extracts the temperature frames from FIFO data
 * read by the "bmi3_read_fifo_data" API and stores it in the "temp_data"
 * structure instance.
 */
int8_t bmi3_extract_temperature(struct bmi3_fifo_temperature_data *temp_data,
                                struct bmi3_fifo_frame *fifo,
                                const struct bmi3_dev *dev)
{
    /* Variable to store result of API */
    int8_t rslt;

    /* Variable to index the bytes */
    uint16_t data_index = 0;

    /* Variable to index temperature frames */
    uint16_t temp_index = 0;

    /* Variable to define the data enable byte */
    uint16_t data_enable = 0;

    rslt = null_ptr_check(dev);

    /* Null-pointer check */
    if ((rslt == BMI3_OK) && (temp_data != NULL) && (fifo != NULL))
    {
        data_index = dev->dummy_byte;

        /* Convert word to byte since all sensor enables are in a byte */
        data_enable = fifo->available_fifo_sens & BMI3_FIFO_HEAD_LESS_TEMP_FRM;

        for (; (data_index < fifo->length);)
        {
            /* If accel enable with the temperature, increment the temperature index by 6
             * since accel frame has 6 bytes of data
             */
            if (fifo->available_fifo_sens & BMI3_FIFO_HEAD_LESS_ACC_FRM)
            {
                data_index = data_index + BMI3_LENGTH_FIFO_ACC;
            }

            /* If gyro enable with the temperature, increment the temperature index by 6
             * since gyro frame has 6 bytes of data
             */
            if (fifo->available_fifo_sens & BMI3_FIFO_HEAD_LESS_GYR_FRM)
            {
                data_index = data_index + BMI3_LENGTH_FIFO_GYR;
            }

            rslt = check_data_index(data_index, fifo);

            if (rslt == BMI3_OK)
            {
                /* Unpack frame to get the temperature data */
                rslt = unpack_fifo_data_frame(temp_data, &data_index, &temp_index, data_enable, fifo);
            }

            if (rslt != BMI3_W_PARTIAL_READ)
            {
                /* If sensor time enable with the temperature, increment the temperature index by 2
                 * since sensor time frame has 2 bytes of data
                 */
                if (fifo->available_fifo_sens & BMI3_FIFO_HEAD_LESS_SENS_TIME_FRM)
                {
                    data_index = data_index + BMI3_LENGTH_SENSOR_TIME;
                }
            }
        }

        /* Update number of temperature frames to be read */
        (fifo->avail_fifo_temp_frames) = temp_index;

        if (fifo->avail_fifo_temp_frames != 0)
        {
            rslt = BMI3_OK;
        }
    }
    else
    {
        rslt = BMI3_E_NULL_PTR;
    }

    return rslt;
}

/*!
 * @brief This API parses and extracts the gyro frames from FIFO data
 * read by the "bmi3_read_fifo_data" API and stores it in the "gyro_data"
 * structure instance.
 */
int8_t bmi3_extract_gyro(struct bmi3_fifo_sens_axes_data *gyro_data,
                         struct bmi3_fifo_frame *fifo,
                         const struct bmi3_dev *dev)
{
    /* Variable to store result of API */
    int8_t rslt;

    /* Variable to index the bytes */
    uint16_t data_index = 0;

    /* Variable to index gyro frames */
    uint16_t gyro_index = 0;

    /* Variable to define the data enable byte */
    uint16_t data_enable = 0;

    rslt = null_ptr_check(dev);

    /* Null-pointer check */
    if ((rslt == BMI3_OK) && (gyro_data != NULL) && (fifo != NULL))
    {
        data_index = dev->dummy_byte;

        /* Convert word to byte since all sensor enables are in a byte */
        data_enable = fifo->available_fifo_sens & BMI3_FIFO_HEAD_LESS_GYR_FRM;

        for (; (data_index < fifo->length);)
        {
            if (fifo->available_fifo_sens & BMI3_FIFO_HEAD_LESS_ACC_FRM)
            {
                data_index = data_index + BMI3_LENGTH_FIFO_ACC;
            }

            rslt = check_data_index(data_index, fifo);

            if (rslt == BMI3_OK)
            {
                /* Unpack frame to get the gyro data */
                rslt = unpack_fifo_data_frame(gyro_data, &data_index, &gyro_index, data_enable, fifo);
            }

            if (rslt != BMI3_W_PARTIAL_READ)
            {
                if (fifo->available_fifo_sens == BMI3_FIFO_HEAD_LESS_GYR_FRM)
                {
                    data_index = data_index + BMI3_LENGTH_FIFO_GYR;
                }

                /* If sensor time enable with the gyro, increment the sensor time index by 2
                 * since sensor time frame has 2 bytes of data
                 */
                if (fifo->available_fifo_sens & BMI3_FIFO_HEAD_LESS_SENS_TIME_FRM)
                {
                    data_index = data_index + BMI3_LENGTH_SENSOR_TIME;
                }

                /* If temperature enable with the gyro, increment the temperature index by 2
                 * since temperature frame has 2 bytes of data
                 */
                if (fifo->available_fifo_sens & BMI3_FIFO_HEAD_LESS_TEMP_FRM)
                {
                    data_index = data_index + BMI3_LENGTH_TEMPERATURE;
                }
            }
        }

        /* Update number of gyro frames to be read */
        (fifo->avail_fifo_gyro_frames) = gyro_index;

        if (fifo->avail_fifo_gyro_frames != 0)
        {
            rslt = BMI3_OK;
        }
    }
    else
    {
        rslt = BMI3_E_NULL_PTR;
    }

    return rslt;
}

/*!
 * @brief This API sets the FIFO water-mark level in words.
 */
int8_t bmi3_set_fifo_wm(uint16_t fifo_wm, struct bmi3_dev *dev)
{
    /* Variable to store result of API */
    int8_t rslt;

    /* Array to store data */
    uint8_t data[2] = { 0 };

    uint16_t fifo_watermark = fifo_wm & BMI3_FIFO_WATERMARK_MASK;

    /* Get LSB value of FIFO water-mark */
    data[0] = BMI3_GET_LSB(fifo_watermark);

    /* Get MSB value of FIFO water-mark */
    data[1] = BMI3_GET_MSB(fifo_watermark);

    /* Set the FIFO water-mark level */
    rslt = bmi3_set_regs(BMI3_REG_FIFO_WATERMARK, data, BMI3_LENGTH_FIFO_WM, dev);

    return rslt;
}
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
