roboryman/EchoCore/PinOutPlanning_RETS/Core/Inc/ads131m02.h

/*
 * Copyright (c) 2024 Galahad Labs, LLC. All rights reserved.
 * ads131m02.h
 *
 *  Created on: Jan 3, 2024
 *      Author: Merrick Ryman
 */

#ifndef INC_ADS131M02_H_
#define INC_ADS131M02_H_

#include <stdint.h>

extern volatile uint8_t adc_flag;

#define SPI_HANDLE (hspi1) // ADC on SPI1 for EchoCore Rev A
#define BUS_TIMEOUT 1000

/* Word Length */
#define WORD_LENGTH_BITS 24 // 16, 24, or 32
#define WORD_LENGTH_BYTES (WORD_LENGTH_BITS / 8)
#define WORD_MAX_BITS 32
#define WORD_MAX_BYTES 4


/* Number of words in a full ADS131M02 SPI Frame */
#define NUM_FRAME_WORDS 4


/* Frame Length */
#define FRAME_LENGTH_BITS (WORD_LENGTH_BITS * NUM_FRAME_WORDS)
#define FRAME_LENGTH_BYTES (WORD_LENGTH_BYTES * NUM_FRAME_WORDS)


/* Command Opcodes */
#define NULL_COMMAND 0x0000
#define RSET_COMMAND 0x0011
#define STBY_COMMAND 0x0022
#define WKUP_COMMAND 0x0033
#define LOCK_COMMAND 0x0555
#define ULCK_COMMAND 0x0655
#define RREG_COMMAND 0xA000
#define WREG_COMMAND 0x6000


/* Register Mapping */
#define REG_ID				0x00
#define REG_STATUS			0x01
#define REG_MODE			0x02
#define REG_CLOCK			0x03
#define REG_GAIN			0x04
#define REG_CFG				0x06
#define REG_THRSHLD_MSB		0x07
#define REG_THRSHLD_LSB		0x08
#define REG_CH0_CFG			0x09
#define REG_CH0_OCAL_MSB	0x0A
#define REG_CH0_OCAL_LSB	0x0B
#define REG_CH0_GCAL_MSB	0x0C
#define REG_CH0_GCAL_LSB	0x0D
#define REG_CH1_CFG			0x0E
#define REG_CH1_OCAL_MSB	0x0F
#define REG_CH1_OCAL_LSB	0x10
#define REG_CH1_GCAL_MSB	0x11
#define REG_CH1_GCAL_LSB	0x12
#define REG_REGMAP_CRC		0x3E
#define REG_RESERVED		0x3F


/* Register Bitield Masks */
#define MASK_ID_CHANCNT				0x0F00
#define MASK_STATUS_LOCK			0x8000
#define MASK_STATUS_F_RESYNC		0x4000
#define MASK_STATUS_REG_MAP			0x2000
#define MASK_STATUS_CRC_ERR			0x1000
#define MASK_STATUS_CRC_TYPE		0x0800
#define MASK_STATUS_RESET			0x0400
#define MASK_STATUS_WLENGTH			0x0300
#define MASK_STATUS_DRDY1			0x0002
#define MASK_STATUS_DRDY0			0x0001
#define MASK_MODE_REG_CRC_EN		0x2000
#define MASK_MODE_RX_CRC_EN			0x1000
#define MASK_MODE_CRC_TYPE			0x0800
#define MASK_MODE_RESET				0x0400
#define MASK_MODE_WLENGTH			0x0300
#define MASK_MODE_TIMEOUT			0x0010
#define MASK_MODE_DRDY_SEL			0x000C
#define MASK_MODE_DRDY_HIZ			0x0002
#define MASK_MODE_DRDY_FMT			0x0001
#define MASK_CLOCK_CH1_EN			0x0200
#define MASK_CLOCK_CH0_EN			0x0100
#define MASK_CLOCK_TBM				0x0030
#define MASK_CLOCK_OSR				0x0013
#define MASK_CLOCK_PWR				0x0003
#define MASK_GAIN1_PGAGAIN1			0x0070
#define MASK_GAIN1_PGAGAIN0			0x0007
#define MASK_CFG_GC_DLY				0x1E00
#define MASK_CFG_GC_EN				0x0100
#define MASK_CFG_CD_ALLCH			0x0080
#define MASK_CFG_CD_NUM				0x0070
#define MASK_CFG_CD_LEN				0x000E
#define MASK_CFG_CD_EN				0x0001
#define MASK_THRSHLD_MSB_CD_TH_MSB	0xFFFF
#define MASK_THRSHLD_LSB_CD_TH_LSB	0xFF00
#define MASK_THRSHLD_LSB_DCBLOCK	0x000F
#define MASK_CH0_CFG_PHASE0			0xFFC0
#define MASK_CH0_CFG_DCBLK0_DIS0	0x0004
#define MASK_CH0_CFG_MUX0			0x0003
#define MASK_CH0_OCAL_MSB_OCAL0_MSB	0xFFFF
#define MASK_CH0_OCAL_LSB_OCAL0_LSB	0xFF00
#define MASK_CH0_GCAL_MSB_GCAL0_MSB	0xFFFF
#define MASK_CH0_GCAL_LSB_GCAL0_LSB	0xFF00
#define MASK_CH1_CFG_PHASE1			0xFFC0
#define MASK_CH1_CFG_DCBLK1_DIS0	0x0004
#define MASK_CH1_CFG_MUX1			0x0003
#define MASK_CH1_OCAL_MSB_OCAL1_MSB	0xFFFF
#define MASK_CH1_OCAL_LSB_OCAL1_LSB	0xFF00
#define MASK_CH1_GCAL_MSB_GCAL1_MSB	0xFFFF
#define MASK_CH1_GCAL_LSB_GCAL1_LSB	0xFF00
#define MASK_REGMAP_CRC_REG_CRC		0xFFFF


/* Status Register Configuration Masks */
#define MASK_STATUS_UNLOCKED		UINT16_C(0x0000)
#define MASK_STATUS_LOCKED			UINT16_C(0x8000)
#define MASK_STATUS_NO_RESYNC		UINT16_C(0x0000)
#define MASK_STATUS_RESYNC			UINT16_C(0x4000)
#define MASK_STATUS_NO_CRC_CHANGE	UINT16_C(0x0000)
#define MASK_STATUS_CRC_CHANGE		UINT16_C(0x2000)
#define MASK_STATUS_NO_CRC_ERROR	UINT16_C(0x0000)
#define MASK_STATUS_CRC_ERROR		UINT16_C(0x1000)
#define MASK_STATUS_CRC_TYPE_CCITT	UINT16_C(0x0000)
#define MASK_STATUS_CRC_TYPE_ANSI	UINT16_C(0x0800)
#define MASK_STATUS_NOT_RESET		UINT16_C(0x0000)
#define MASK_STATUS_WAS_RESET		UINT16_C(0x0400)
#define MASK_STATUS_DATA_16BIT		UINT16_C(0x0000)
#define MASK_STATUS_DATA_24BIT		UINT16_C(0x0100)
#define MASK_STATUS_DATA_32BIT_ZP	UINT16_C(0x0200)
#define MASK_STATUS_DATA_32BIT_SE	UINT16_C(0x0300)
#define MASK_STATUS_DRDY1_NO_DATA	UINT16_C(0x0000)
#define MASK_STATUS_DRDY1_DATA		UINT16_C(0x0002)
#define MASK_STATUS_DRDY0_NO_DATA	UINT16_C(0x0000)
#define MASK_STATUS_DRDY0_DATA		UINT16_C(0x0001)


/* Mode Register Configuration Masks */
#define MASK_MODE_REG_CRC_DISABLE	UINT16_C(0x0000)
#define MASK_MODE_REG_CRC_ENABLE	UINT16_C(0x2000)
#define MASK_MODE_SPI_CRC_DISABLE	UINT16_C(0x0000)
#define MASK_MODE_SPI_CRC_ENABLE	UINT16_C(0x1000)
#define MASK_MODE_CRC_TYPE_CCITT	UINT16_C(0x0000)
#define MASK_MODE_CRC_TYPE_ANSI		UINT16_C(0x0800)
#define MASK_MODE_NO_RESET			UINT16_C(0x0000)
#define MASK_MODE_YES_RESET			UINT16_C(0x0400)
#define MASK_MODE_DATA_16BIT		UINT16_C(0x0000)
#define MASK_MODE_DATA_24BIT		UINT16_C(0x0100)
#define MASK_MODE_DATA_32BIT_ZP		UINT16_C(0x0200)
#define MASK_MODE_DATA_32BIT_SE		UINT16_C(0x0300)
#define MASK_MODE_SPI_TOUT_DISABLE	UINT16_C(0x0000)
#define MASK_MODE_SPI_TOUT_ENABLE	UINT16_C(0x0010)
#define MASK_MODE_DRDY_SRC_MOST_LAG	UINT16_C(0x0000)
#define MASK_MODE_DRDY_SRC_OR_EN	UINT16_C(0x0004)
#define MASK_MODE_DRDY_SRC_MOST_LED	UINT16_C(0x0008)
#define MASK_MODE_DRDY_HIZ_LOGIC_HI	UINT16_C(0x0000)
#define MASK_MODE_DRDY_HIZ_HIGH_IMP	UINT16_C(0x0002)
#define MASK_MODE_DRDY_FMT_LOGIC_LO	UINT16_C(0x0000)
#define MASK_MODE_DRDY_FMT_LO_FIXED	UINT16_C(0x0001)


/* Clock Register Configuration Masks */
#define MASK_CLOCK_CH1_DISABLE		UINT16_C(0x0000)
#define MASK_CLOCK_CH1_ENABLE		UINT16_C(0x0200)
#define MASK_CLOCK_CH0_DISABLE		UINT16_C(0x0000)
#define MASK_CLOCK_CH0_ENABLE		UINT16_C(0x0100)
#define MASK_CLOCK_TURBOMODE_OFF	UINT16_C(0x0000)
#define MASK_CLOCK_TURBOMODE_ON		UINT16_C(0x0020)
#define MASK_CLOCK_OSR_128			UINT16_C(0x0000)
#define MASK_CLOCK_OSR_256			UINT16_C(0x0004)
#define MASK_CLOCK_OSR_512			UINT16_C(0x0008)
#define MASK_CLOCK_OSR_1024			UINT16_C(0x000C)
#define MASK_CLOCK_OSR_2048			UINT16_C(0x0010)
#define MASK_CLOCK_OSR_4096			UINT16_C(0x0014)
#define MASK_CLOCK_OSR_8192			UINT16_C(0x0018)
#define MASK_CLOCK_OSR_16256		UINT16_C(0x001C)
#define MASK_CLOCK_PWR_VERY_LOW		UINT16_C(0x0000)
#define MASK_CLOCK_PWR_LOW			UINT16_C(0x0001)
#define MASK_CLOCK_PWR_HIGH_RES		UINT16_C(0x0002)


/* Gain1 Register Configuration Masks */
#define MASK_GAIN1_PGA_CH1_1		UINT16_C(0x0000)
#define MASK_GAIN1_PGA_CH1_2		UINT16_C(0x0010)
#define MASK_GAIN1_PGA_CH1_4		UINT16_C(0x0020)
#define MASK_GAIN1_PGA_CH1_8		UINT16_C(0x0030)
#define MASK_GAIN1_PGA_CH1_16		UINT16_C(0x0040)
#define MASK_GAIN1_PGA_CH1_32		UINT16_C(0x0050)
#define MASK_GAIN1_PGA_CH1_64		UINT16_C(0x0060)
#define MASK_GAIN1_PGA_CH1_128		UINT16_C(0x0070)
#define MASK_GAIN1_PGA_CH0_1		UINT16_C(0x0000)
#define MASK_GAIN1_PGA_CH0_2		UINT16_C(0x0001)
#define MASK_GAIN1_PGA_CH0_4		UINT16_C(0x0002)
#define MASK_GAIN1_PGA_CH0_8		UINT16_C(0x0003)
#define MASK_GAIN1_PGA_CH0_16		UINT16_C(0x0004)
#define MASK_GAIN1_PGA_CH0_32		UINT16_C(0x0005)
#define MASK_GAIN1_PGA_CH0_64		UINT16_C(0x0006)
#define MASK_GAIN1_PGA_CH0_128		UINT16_C(0x0007)


/* CFG Register */
// Global Chop Delay Masks Here ...
#define MASK_CFG_GC_DISABLE			UINT16_C(0x0000)
#define MASK_CFG_GC_ENABLE			UINT16_C(0x0100)
#define MASK_CFG_CD_ANY				UINT16_C(0x0000)
#define MASK_CFG_CD_ALL				UINT16_C(0x0080)
// Current-detect thresholds selection number Masks Here...
// Current-detect measurement length selection Masks here...
#define MASK_CFG_CD_DISABLE			UINT16_C(0x0000)
#define MASK_CFG_CD_ENABLE			UINT16_C(0x0001)


/* THRSHLD LSB Register */
#define MASK_THRSHLD_LSB_DC_DISABLE	UINT16_C(0x0000)
#define MASK_THRSHLD_LSB_DC_4		UINT16_C(0x0001)
#define MASK_THRSHLD_LSB_DC_8		UINT16_C(0x0002)
#define MASK_THRSHLD_LSB_DC_16		UINT16_C(0x0003)
#define MASK_THRSHLD_LSB_DC_32		UINT16_C(0x0004)
#define MASK_THRSHLD_LSB_DC_64		UINT16_C(0x0005)
#define MASK_THRSHLD_LSB_DC_128		UINT16_C(0x0006)
#define MASK_THRSHLD_LSB_DC_256		UINT16_C(0x0007)
#define MASK_THRSHLD_LSB_DC_512		UINT16_C(0x0008)
#define MASK_THRSHLD_LSB_DC_1024	UINT16_C(0x0009)
#define MASK_THRSHLD_LSB_DC_2048	UINT16_C(0x000A)
#define MASK_THRSHLD_LSB_DC_4096	UINT16_C(0x000B)
#define MASK_THRSHLD_LSB_DC_8192	UINT16_C(0x000C)
#define MASK_THRSHLD_LSB_DC_16384	UINT16_C(0x000D)
#define MASK_THRSHLD_LSB_DC_32768	UINT16_C(0x000E)
#define MASK_THRSHLD_LSB_DC_65536	UINT16_C(0x000F)


/* CH0 CFG Register */
#define MASK_CH0_CFG_DC_ENABLED		UINT16_C(0x0000)
#define MASK_CH0_CFG_DC_DISABLED	UINT16_C(0x0004)
#define MASK_CH0_CFG_INPUT_PN		UINT16_C(0x0000)
#define MASK_CH0_CFG_INPUT_SHORTED	UINT16_C(0x0001)
#define MASK_CH0_CFG_INPUT_POS_DC	UINT16_C(0x0002)
#define MASK_CH0_CFG_INPUT_NEG_DC	UINT16_C(0x0003)


/* CH1 CFG Register */
#define MASK_CH1_CFG_DC_ENABLED		UINT16_C(0x0000)
#define MASK_CH1_CFG_DC_DISABLED	UINT16_C(0x0004)
#define MASK_CH1_CFG_INPUT_PN		UINT16_C(0x0000)
#define MASK_CH1_CFG_INPUT_SHORTED	UINT16_C(0x0001)
#define MASK_CH1_CFG_INPUT_POS_DC	UINT16_C(0x0002)
#define MASK_CH1_CFG_INPUT_NEG_DC	UINT16_C(0x0003)


/* Register Misc */
#define MAX_ADDRESS 0x3F
#define ID			0x22
#define MASK_EMPTY	UINT16_C(0x0000)


/* Error Codes */
#define ADS_OK					0
#define ADS_GENERIC				1
#define ADS_NULL_PTR			2
#define ADS_INCOMPLETE_FRAME	3
#define ADS_INVALID_RESPONSE	4
#define ADS_INVALID_DATA_LEN	5
#define ADS_REG_EXCEEDS_MAX		6


uint8_t ADS131M02_echocore_init(void);
void ADS131M02_task(void);
uint8_t ADS131M02_null(uint8_t *response);
uint8_t ADS131M02_reset(void);
uint8_t ADS131M02_standby(void);
uint8_t ADS131M02_wakeup(void);
uint8_t ADS131M02_lock(void);
uint8_t ADS131M02_unlock(void);
uint8_t ADS131M02_rreg(uint8_t address, uint8_t *data, uint8_t len);
uint8_t ADS131M02_wreg(uint8_t address, uint16_t *data, uint8_t len);
static int32_t sign_extend_24bit_to_32bit(unsigned char *buffer);
static void ADS131M02_print_error(uint8_t rslt);
static uint8_t ADS131M02_test(void);
static int8_t ADS131M02_spi_read(uint8_t *response, uint16_t length);
static int8_t ADS131M02_spi_write(const uint8_t *payload, uint16_t length);


#endif /* INC_ADS131M02_H_ */
